xuanxly/fpga-piano-Chuyun/docs/design-status.md

# 文件适用范围与资料状态

[返回项目首页](../README.md)

整理日期：2026-11-03。

|资料|当前内容|适用范围|
|---|---|---|
|PCB工程|项目归档的三份嘉立创EDA专业版原生epro2导出|可编辑设计；Pressure/Control选择PCB2，Lighting选择PCB1|
|原理图和PCB图|项目归档的9张原始截图及对应图文材料|接口和布局阅读|
|亚克力CAD|七片毫米DXF|标称切割轮廓与厚度|
|按键STL|固定定位座、圆形托盘，各28件|打印几何，配合需结合采购硅胶和FSR|
|Blender|整机分层、单键模型|结构说明；层高、PCB厚度及电路外观为示意|
|实物照片|整机、按键、主控、Control、采集板、屏幕及接线|原型装配记录|
|技术文档|R10复核提交版，40页|机械、电路、D13软件、新HOME/VERIFY/EFFECTS实拍与验证数据|
|D13工程|D13完整源码及发布文件，逐文件校验复制|源码、约束、ROM、已发布位流、CH569 HEX、测试与历史记录|
|录音工作室|项目提供的在线链接|外部维护，不随硬件目录打包网页部署文件|

## 配合资料待补

- IO Bank实际供电与D13约束、电气连接的一致性验收记录。
- 四块采集板编号、28个实体键到ADC通道的实装映射。
- 触摸、模拟音频、长时间录放和手机磁盘兼容性等实板专项测试记录。
- 外贴侧板后的整机实测外廓、左右轨距、各层高度和层板有效宽度。
- 灯板实物照片与112灯工程的逐灯地址/布局对应记录。
- Gerber、钻孔文件、贴片生产BOM、坐标文件和原始DRC结果（当前材料未包含，未从截图代造）。

以上空缺集中记录在本页；已经确认的最终结构在正文直接描述。D13源码、约束与发布文件已附入，D12作为历史版本保留。硬件专项验收数据由对应实测记录提供。

## 文件核验

[manifest.csv](../verification/manifest.csv) 列出归档材料、便携来源标签、文件字节数及SHA-256。 [file-checks.json](../verification/file-checks.json) 记录工程包完整性、DXF、STL和Blender资源检查。文件检查不能代替PCB DRC、加工公差验证或整机上板测试。

源资料中的本地工作目录、软件会话数据库和历史备份不作为GitHub入口。原始文件保留在原位置，仓库采用独立副本。

D12目录保留原包内容与第三方许可证；其中历史报告的本机路径仅表示原验证环境，不作为新电脑的依赖路径。附带的历史接线资料以本仓库D13 CST与现版接线说明为准。
