xuanxly/fpga-piano-Chuyun/fpga/d13/docs/hardware/PCB4_20261021/原始工程核对_20261021.md

# PCB4 原始工程核对与已确认灯效

日期：2026-10-21。

## 本轮用户确认

- 原始工程：桌面 `4x7_R2_C120019_布线修复完成_20261020.epro2`。
- 尚未打样。
- 保留当前 PCB，不修改去耦电容或其他板上电路；不再把增加去耦作为继续软件开发的前置条件。
- 灯效：按住时本键四灯保持亮；按下瞬间向周围其他琴键扩散一次并逐渐熄灭；多键可各自产生波纹。
- 5V 电源来源、额定电流及线束仍未确认。
- 本轮完成资料归档和静态网络核对，未修改 PCB、原理图、HDL、CST 或位流，未操作下载器。

## 原始工程归档

- 来源：`C:/Users/KUKI/Desktop/4x7_R2_C120019_布线修复完成_20261020.epro2`
- 本目录保留同名副本，大小 366,899 字节。
- 原件和副本 SHA256：`D5F0B95F5D8CA90B69EB961A93FDA79C734F0D4EC0A00FE1CC61A12144680D92`。
- 工程为 ZIP 容器，包括 project2.json、图片和 `4x7_R2_slots_power_20261020.epru`。
- 内含 1 张原理图页、1 块 PCB，以及符号、器件和封装库。读取时将空值记录按删除记录处理，而非当成有效元件；未修改原始工程包。

## 已核对的 PCB 焊盘网络

以下是原始文件中的焊盘网络定义，不等于原生 EDA 的 ERC/DRC 或实物导通验证。

| 接口 | 引脚 | 工程网络 | 用途 |
| --- | --- | --- | --- |
| U2 四针接口 | 1 | 空网络 | NC，不接 |
| U2 | 2 | GND | FPGA 与灯板的信号参考地 |
| U2 | 3 | $1N5 | FPGA 灯光数据输入至缓冲器 |
| U2 | 4 | 空网络 | NC，不接 |
| P1 电源端 | 1 | +5V | 灯板独立 5V 电源正极 |
| P1 | 2 | GND | 灯板电源负极 |

U2 的第 1、4 针未分配电源网络，不能按常见四针灯带接口的线序猜接。辅助几何检查未发现走线靠近这两个 NC 焊盘，但未进行完整铜皮/焊盘几何 DRC。

信号路径：

`U2-3 → U1-2（1A）→ U1-3（1Y）→ R2 33Ω → D001-3（DI）`

- R3 10kΩ 从 $1N5 接 GND，是缓冲器输入下拉。
- R2 确认为 C120019、33Ω，跨接缓冲器输出 $1N6 与首灯输入 $1N7。
- U1-14 接 +5V、U1-7 接 GND；使用的通道 U1-1（低有效 OE）接 GND。
- 未使用通道的 OE：4、10、13 接 +5V；A：5、9、12 接 GND；Y：6、8、11 空置。没有发现这些控制输入悬空的网络定义。
- 5V 缓冲器输出只进入灯链；U2 数据入口位于缓冲器输入侧。未发现数据入口网络被直接分配到 +5V。
- P1 有装配备注：原端子高度超过外壳限制，计划将端子移到板外并在 P1 焊线。后续装配需要明确线束固定、绝缘和极性标识。

## 112 灯链检查

已通过 7 项静态网络断言，结果另存 `native_net_audit.json`：

1. 112 颗灯全部为 2 脚接 GND、4 脚接 +5V。
2. D001～D112 之间 111 个相邻连接全部满足前灯 1 脚 DO 与后灯 3 脚 DI 同网，且不是电源/地/空网络。
3. D112 的 DO 留空，符合末端无需继续输出的连接方式。
4. U2 数据入口、U1 输入和 R3 下拉连接一致。
5. U1 输出经 R2 进入第一颗灯。
6. P1 电源极性网络一致。
7. U1 电源、所用 OE 及未用通道输入连接一致。

这些检查能确认串接网络的意图；不能证明实际走线、过孔和铺铜没有断路或短路。

## 灯珠封装名称疑点的更新

原 PDF 的封装名带 WS2815C，单凭名称不能判错。原始工程显示：

- 所用器件实际是 C52917434 / WS2812B-2020-V6。
- 符号定义为 1=DO、2=GND、3=DI、4=VDD，与厂家资料相符。
- 封装四个焊盘编号的相对分布可对应厂家顶视图旋转 180° 后的方向，未发现逻辑编号互换。
- 实际库焊盘约 0.8×0.8mm，横向中心距约 1.73mm，纵向约 1.10mm；与本次取得的厂家推荐焊盘图不完全相同。此处只记录尺寸，不能将“编号正确”扩大为贴装工艺验证通过。

依用户决定，本轮保留现有封装与 PCB，不做替换。

## 供电的已知边界

- 文件存在 100mil（2.54mm）+5V 主干和 60mil（1.524mm）行供电线；分支主要约 0.6mm；底层有 GND 铺铜定义。
- 这是文件中的线宽信息，不能据此单独保证整个回路在约 4A 负载下的温升、压降、连接器和焊线载流均合格。
- 现板电源从 P1 进入；FPGA 只需提供数据和参考地。不得让普通 GPIO 或信号杜邦线承担灯板供电电流。
- 5V 电源额定值未确认，不把“有 5V”视为具备所需供电能力。后续程序可以设置总亮度上限和复位时熄灯，但不能把软件限亮当作供电/接线检查的替代品。
- 用户已经决定保留现板电容配置；先前 PDF 初审中的电容建议保留为历史记录，本轮不执行。

## 空间映射

以 PDF 第 4 页的正面方向为准；上到下 4 排、左到右 7 列。按现有电子琴每排 C/D/E/F/G/A/B 的顺序，拟采用下表。最终安装方向尚未通过实物确认。

| 排 | C | D | E | F | G | A | B |
| --- | --- | --- | --- | --- | --- | --- | --- |
| 上排 C3～B3 | D025～028 | D021～024 | D017～020 | D013～016 | D009～012 | D005～008 | D001～004 |
| 第 2 排 C4～B4 | D029～032 | D033～036 | D037～040 | D041～044 | D045～048 | D049～052 | D053～056 |
| 第 3 排 C5～B5 | D081～084 | D077～080 | D073～076 | D069～072 | D065～068 | D061～064 | D057～060 |
| 下排 C6～B6 | D085～088 | D089～092 | D093～096 | D097～100 | D101～104 | D105～108 | D109～112 |

键组中心间距约 31mm，各键四灯中心形成约 23×23mm 的方形。按灯链序号逐个追逐不是二维扩散；后续应按物理坐标计算波纹，再映射到串行发送地址。

拟定实现边界：

- 使用现有压力前端的 28 键状态，检测按下边沿；不从混音或 FFT 反推按键。
- 本键四灯的保持显示与一次性波纹分别计算，避免波纹消失时误熄仍按住的本键。
- 每键分别维护波纹状态，多键同时触发时不互相抢占；重叠像素按确定规则限幅合成。
- 112 灯统一串行发送；协议按实际 V6 的 GRB、脉宽和复位时间实现。
- 仍未选择 FPGA 输出球位；需要结合当前 36 个已用球位和开发板原理图检查可用口，不能拿 U2-3 的数字当成 FPGA 引脚号。
- 当前 RTL 仍未实现以上灯效，本轮没有新增 RTL 或运行相关仿真。

## 依据和验证范围

- 原始工程包为当前接口和灯链连接的依据；PDF 初审仍保留在同目录。
- Worldsemi V6 资料：https://www.world-semi.com/downloads/datasheets/en/ws2812b-2020-v6-1.0.pdf
- TI SN74HCT125：https://www.ti.com/lit/ds/symlink/sn74hct125.pdf
- 本轮为静态文件审查，未运行嘉立创原生 ERC/DRC，未验证制造输出、实物供电、装配或 FPGA 下载后的灯效。
