xuanxly/fpga-piano-Chuyun/fpga/d13/docs/hardware/PCB4_20261021/阅读与待确认事项.md

# PCB4 灯板资料归档与初审

日期：2026-10-21。当前阶段为资料阅读和讨论，未修改 HDL、CST、器件配置或位流，未进行上电、下载、ERC/DRC 或实物验证。

后续更新：已收到并核对同目录原始 `.epro2` 工程，接口、灯链和用户确认规则以 `原始工程核对_20261021.md` 为准。用户确认尚未打样、现有 PCB 不修改，去耦建议不作为继续软件开发的前置条件；本文件保留为 PDF 初审记录。

## 原文件与副本

- 用户提供：`C:/Users/KUKI/Desktop/PCB4.pdf`
- 项目副本：`D:/FPGA/13_learning/pressure_piano_28/docs/hardware/PCB4_20261021/PCB4.pdf`
- 大小：2,277,691 字节；6 页。
- 原件与副本 SHA256 均为：`CE9CCC7E7CCBFC173521DB89D6F004352775C1BB69287AA93D68EDE226FE4917`。
- 保留原始文件内容，未重新导出、裁切或覆盖桌面文件。

## 逐页内容

| 页 | 内容 | 可支持的结论 |
| --- | --- | --- |
| 1 | 正面灯珠位号分布 | 4 排琴键，每排 7 组，每组 4 灯，共 112 灯；相邻组未共用同一颗灯 |
| 2 | 背面元件位号分布 | 28 个分布式电容位置，另有电源入口、缓冲器和接口 |
| 3 | BOM | 具体型号及数量，见下表 |
| 4 | 正面焊盘与走线 | 灯珠串接布局；需要原理图/网表确认完整 DIN→DOUT 顺序 |
| 5 | 背面走线、铺铜及器件 | 可观察供电布线和接口区域；不能据此替代网络与载流核验 |
| 6 | 钻孔分布 | 可用于位置辅助核对；没有孔径表、板材/铜厚或完整尺寸标注 |

该 PDF 不含电气原理图、网络表、ERC/DRC 报告。不能从“已经画出走线”直接认定网络正确、焊盘正确或供电安全。

## BOM 摘要

| 器件 | 数量 | 型号/值 | 备注 |
| --- | --- | --- | --- |
| D001～D112 | 112 | WS2812B-2020-V6，C52917434 | BOM 封装名为 LED-SMD_4P-L2.2-W2.0-P1.00_WS2815C-2020-4P，须核对映射 |
| C1～C28 | 28 | 100nF，CT4-0805B104K500F3，C84772 | BOM 使用直插封装；不能只凭型号中的 0805 判断为贴片料 |
| C29 | 1 | 470µF，OCR471M1CBK-0811G，C134851 | 核对极性、耐压及尺寸 |
| U1 | 1 | SN74HCT125N，PDIP-14，C154102 | 5V 缓冲器，须核对供电、使能和未用输入 |
| U2 | 1 | PZ2.54-1*4-WZ，C5224015 | 四针接口，当前缺少各针网络定义 |
| P1 | 1 | WJ500V-5.08-2P，C8465 | 两针端子，极性与供电用途待原理图确认 |
| R2 | 1 | 33Ω，C120019 | 功能需原理图确认，不直接认定为数据串联电阻 |
| R3 | 1 | 10kΩ，C119347 | 功能需原理图确认，不直接认定为下拉电阻 |

## 当前代码是否已实现

检查 `src/pressure_piano_28_top.v`、`src/piano28_core.v`、`src/instrument_controls.v` 及工程源文件清单：

- 当前已有 28 键 `key_gate` 和每键 12bit `key_pressure`，可作为未来灯效输入。
- `transpose_led[9:0]` 是移调指示，`dark_led` 是明暗模式指示，不是本灯板控制接口。
- 尚无本灯板的数据输出端口、WS2812 发送驱动、112 灯空间映射或按键波纹引擎。
- 现有 HDMI 屏幕琴键格不等于实体琴键灯效。
- 结论：28 键检测可复用，实体“本键四灯点亮并向周围扩散”尚未实现。
- 当前原工程的仿真及实现结果不构成本灯板的验证证据；未来加入后须单独验证并重新综合、布局布线。

## 必须核对或建议修改

1. **灯珠封装与引脚映射。** BOM 料号与封装名称不同，不足以直接判定错误，但必须对照实际库焊盘编号、尺寸及安装方向。厂家资料第 2～3 页定义：1=DO、2=GND、3=DI、4=VDD。必须保证各级 DO 接下一级 DI，不能把编号连续当成已验证串联顺序。

2. **独立供电和压降。** 厂家标注每个颜色通道 12mA；若 112 灯三色满亮，按该数值估算 LED 电流为 `112×3×12mA=4.032A`，功率在 5V 下约 20.16W，尚未计控制电路及供电余量。这是选型估算，不是实测电流或保证最大值。灯板电源应独立规划，不能由 FPGA GPIO 或单根普通杜邦线承担全板电流。还需根据实际铜厚、板尺寸、供电/地线宽度、连接器、线束及注电点核算压降和温升；程序亮度上限只能作为补充措施。

3. **去耦电容分布。** 本次取得的厂家 WS2812B-2020-V6 V1.4 资料第 5 页典型应用电路为每灯 VDD 配 100nF。本板是 112 灯配 28 个 100nF。建议按每颗灯附近一个 100nF 预留/调整，并为 U1 的 VCC/GND 就近配置一个 100nF。若用户已打样或具体批次有另行明确要求，应先核对实际资料与布局，再决定补焊和限亮测试，不直接声称现板必然失效。470µF 入口电容不能替代每处高频去耦。

4. **缓冲器和 FPGA 边界。** TI 的 SN74HCT125 推荐供电 4.5～5.5V，VIH 最低 2V，可用于 FPGA 3.3V 输出到 5V 灯板方向的缓冲。必须确认 14 脚 VCC、7 脚 GND、所用通道低有效 OE，以及所有未用输入/OE 的确定电平。不能把 5V 输出、5V 上拉或外部 5V 电源接回 FPGA 普通 GPIO。PDF 缺少网络名，当前不能给 U2/P1 的逐针接线结论，尤其应核对其电源是否会与开发板电源并接回灌。

5. **空间映射与机械位置。** 从正面位号可见各琴键行的编号方向交替。未来代码需要明确“ADC 板/通道 → 琴键行列 → 四颗灯 → 串行地址”的表，不能简单沿灯珠链依次点亮来冒充二维扩散。需要确认演奏者视角下每排 C～B 的方向及整板安装方向，并核对琴键、FSR、支架和背面元件是否干涉。

## 协议可行性（计算，非实测）

厂家资料给出 24bit GRB、高位先发、约 800kbps、帧间低电平复位大于 280µs。

- 112 灯一帧数据耗时约 `112×24/800000=3.36ms`。
- 加入不少于 300µs 的复位空闲，约 3.66ms；因此从发送带宽看，60Hz 灯效刷新可行。
- 发送逻辑应按实际 V6 数据手册的 0/1 高低脉宽实现，不能只按“800kHz”生成等占空比时钟。
- 这是协议预算，未验证当前 PCB 信号质量、供电、实际可达帧率或灯效观感。

## 讨论完成前需要的信息

- 配套电气原理图或原始嘉立创工程路径；至少包含 U1/U2/P1、第一颗灯和灯链连接。
- 当前是否已打样、焊接，灯板计划的 5V 供电来源和可供电流。
- 建议效果：按住本键四灯保持亮，按下边沿产生一次向邻键扩散并衰减的波纹；多键分别触发并叠加。与“按住持续产生波纹”需由用户选择。

## 外部依据

- Worldsemi 官方 WS2812B-2020-V6 数据手册（本次取得页面标记 V1.4；URL 文件名含 1.0，不能按 URL 推断正文版本）：https://www.world-semi.com/downloads/datasheets/en/ws2812b-2020-v6-1.0.pdf ，重点第 1～5 页。
- TI SNx4HCT125 Rev.G 数据手册：https://www.ti.com/lit/ds/symlink/sn74hct125.pdf ，重点第 3～4、8～9 页。

归档与阅读完成。灯板电气通过、整机接线通过、灯效代码完成、实物效果通过均未确认。
