xuanxly/fpga-piano-Chuyun/fpga/d13/docs/D12_DESIGN.md

# D12 实现与边界

六应用：频谱、触屏键盘、WAV录音、文件管理/WAV播放、五音色、灯光游戏。Home为2排3列，所有页面保留音量和音调柱，文件播放时音调柱禁用。

界面仍保持原两拍RGB/HS/VS/DE延迟：第一拍选择文本及字符序号，第二拍取字符、字模和字模位置。八页共3072000像素与修改前逐字节一致，进度条全范围和28键隔离另外复验，不增加帧缓存。

## 游戏

四排七键对应 C3..B6，与实体压力键、触屏键和PCB4灯序相同。进入GAME显示 `/SONGS` 的英文CSV文件，每页六个，可翻页。选择后校验整份文件，再以最多32个待处理事件流式装入分布式队列。计时、按键边沿、和弦、长音、分数、灯光和屏幕提示由HDL完成。

练习模式在目标时刻等待正确键；挑战模式按固定时间前进。倒计时期间灯光不提示琴键，结束后最多提前150ms提示，与可按窗口对齐，灯亮即可按。挑战允许前后150ms，50ms内命中100分，其他命中70分。和弦必须在窗口内逐个触发并最终同时按住。超过300ms的音符按实际命中时刻计算持续时间，允许结尾60ms释放余量；下一次同键进入可按窗口时允许换音。蓝色提示按键，绿色表示正确/继续保持，红色表示错误。错误键仍会实时发声。队列暂空时冻结游戏计时，退出GAME停止游戏与引导。谱面最长5分钟，末尾为迟按尾音与EOF保留500ms内部收尾余量。

音频主链不读取谱面来自动发音。谱面只引导玩家，实际按键仍进入既有28声部合成器。

游戏状态按合法谱面范围缩窄：绝对时间和长音截止19位、分数20位，每条队列事件64位。最大迟按尾音截止不超过360500ms，小于19位上限524287ms。队首装载时预计算可按、提示及完美命中窗口；命中时分别保存长音结束和提前释放截止时刻。时间及长音的63项比较与实际下一状态一起预测寄存，判定仍在原来的毫秒边沿发生，不增加判定延迟；清空、队首装载和命中同拍的优先级也保持。214405个时钟周期与旧判定器逐拍对照，并检查全部63项寄存结果等于当前状态的直接比较。模块综合占用见 `reports/d12_game_area_reduction.json`，整机占用以最终PnR报告为准；不把单模块统计当作整片FPGA资源。游戏22个场景包含60/61ms释放边界，五分钟边界、画面/灯光和实际CPU暂停继续均纳入修改后复验。

## 谱面格式

```csv
PIANO28,1
0,1000,C3+E3+G3
1500,300,D4
```

三列依次是绝对时间ms、持续时间ms、以加号连接的键名。仅接受C/D/E/F/G/A/B、八度3..6，无升降号。相同时刻的和弦写在同一行。时间严格递增，同一键的音符不得重叠。40..60000ms音长，总时长不超过5分钟、4096事件、262144字节。`#` 开头是注释。示例均为本项目编写的短练习。

## 分音色按钮

钢琴、电钢琴、风琴：短按切换明暗。吉他：短按开关轻揉弦。弦乐：短按开关揉弦。五种音色各自记忆状态。短按在释放时确认；长按约2秒只执行既有触屏USB启动，不额外触发短按。

5Hz三角LFO只调节吉他/弦乐DDS步长。吉他50ms后渐入，峰值约±1.7音分；弦乐200ms后渐入，峰值约±13.6音分。每声部独立起音年龄，28声部仍896时钟/采样。

铃音相关的弯音步长、3.5倍步长和相位分别放在现有32拍调度的第2、3、4拍计算，保持逐声部上下文及整帧时长。修改后重新完成五音色逐样本对照、录音链、28键/四路ADC整机与揉弦验证。

## 文件、录音和磁盘调度

录音保存内部合成PCM为48kHz/16位单声道WAV，保留五分钟限制和暂停。WAV播放支持16位单/双声道、8..48kHz；文件播放屏蔽琴音，退出播放器停止播放。D12去掉MP3解码器以节省块存储，MP3仍可在磁盘模式复制/删除。

录音、游戏、手机磁盘互斥。进入游戏前结束并保存录音；进入USB磁盘前结束录音、停止播放器/游戏、同步并卸载FatFs。导出后仅处理手机的原始扇区请求，拒绝录音和打开文件。EJECT先让CH569断开USB设备，再同步TF卡并交还FPGA重新挂载。拷贝期间不应强制拔电或按EJECT。手机拔线后还须通过EJECT交还卡，不能仅根据USB暂停判断卡可收回。

## CH569

CH569-USB3 Type-C运行USB2 MSC/Bulk-Only设备，使用CH569原生USB外设。FPGA与CH569通过板上既有HSPI连接作带背压的四位GPIO握手。MCU PA/PB脚位与NEO31005原理图第21页核对，FPGA球位与官方60K HSPI CST核对。使用HD13作为MCU请求，HD5/6/7/12作为FPGA发送数据，避开专用I2C/SSPI引脚，保留D11启动设置。

MCU先发带CRC16的 `PIANO12!` 身份包，FPGA文件服务核验后才能驱动数据脚。FPGA数据OEN使用INIT=1寄存器，MCU READY下降时异步高阻。未更换CH569固件时磁盘功能显示 `USB LINK WAIT`，不自动进入磁盘。

屏幕的独立USB触控主机保持原枚举及轮询时序。其宽描述符比较先寄存，计数器按原门限缩窄；描述符在脱离设备和进入下一控制步骤前清零，避免等待窗口直接驱动328位清零使能。真实USB针脚模型的枚举、错误设备拒绝、五指演奏及USB时钟故障恢复均重新验证。

等待结束、帧启动窗口和拔出门限使用同步预测状态，逐拍对照原组合定义；控制步骤提前解码。事务复位许可单独寄存，首次SETUP等待许可就绪，避免异步CLEAR的状态解码长路径；USB位时序、重试等待和SOF窗口保持。

USB描述符、SCSI、传输错误恢复和128GB块地址经过软件测试；这不代表已通过USB电气或iPhone实测。速度由GPIO握手、软核SD SPI和TF卡决定，不声称USB3吞吐量。

只改CH569应用固件，不改BL616下载器。恢复镜像来自官方Sipeed固定提交，`docs/ch569_recovery/PROVENANCE.json`有来源和哈希；它是官方恢复镜像，不是本机板子的读回备份。刷写前仍须确认恢复方式并尽可能保留板上固件读回。

## 验证边界

数字仿真、C主机测试、综合/PnR与真实板级验收分别记录。新位流只在最终所有检查通过后交付，不使用中途失败产物。原D11保持可恢复。没有自动下载FPGA、CH569或写任何硬件Flash。

## UI和USB时序拆分

UI按“坐标预译码→五指归属→提交”三拍处理，一个50MHz时钟周期为20ns。额外一拍只用于分割组合路径，不改触摸坐标、音量刻度、移调范围和点击优先级。新旧UI通过16001帧随机逐帧对照，覆盖八页面、五指ID、滑动/松手、命令顺序、CPU导航和断线。流水数据不要求复位，只有有效标志清零；未有效的数据不会提交。

USB枚举的附着/总线复位/恢复计数独立于控制传输成功或失败分支；离开枚举阶段计时器保持零。各阶段原有门限不变，避免事务结果经错误分支组合路径返回宽计数器。

处理器数据总线先锁存请求、MMIO及常用FIFO地址译码，再完成仲裁；游戏命令在CPU消费ACK的同一拍提交。1220笔事务检查覆盖ROM、带字节掩码RAM、只提交一次的MMIO、连续游戏写后读、录放冲突及五分钟录音边界。五分钟容量标志和音频FIFO空满标志与计数同拍预测更新，音频采样不等待软件。

基准画面的音量柱高度改为完整128项整数查表，与原计算的194560个边缘/刻度像素一致，RGB延迟仍为两拍。五种音色关闭揉弦时保持与D11的逐样本对照结果，28声部仍为896时钟/帧。
