xuanxly/fpga-piano-Chuyun/fpga/d13/reports/package_checks/整理验证.md

# D13 整理与迁移验证

本目录是精简开发工程，版本 **0x0000C02F**。原工程`D:/FPGA/11_projects/pressure_piano_validation_d13`保留，14484项原文件在整理前后逐项SHA256一致。完整版逐字节保留全部原文件；精简版保留当前开发所需文件。

- 当前Gowin工程58项引用全部在包内，GPRJ、过程配置、device.cfg及正式FS与原D13相同。
- 原D13报告中记录的121项源码/约束/ROM/固件哈希一致，34项历史通过日志及其哈希全部保留。它们是原发布时的结果，不称为本次重跑34项。
- 在精简版新位置由真实Gowin CLI打开工程成功；没有重新综合或PnR，没有操作下载器。
- 从精简版路径重新编译全部仿真源码，运行`tb_effects28`、`tb_d13_rom_equivalence`、`tb_d12_game_timing`三项均PASS。效果器91300行新输出与原验证数据逐字节相同；ROM14336次等价、游戏214405周期等价通过。
- 从精简版重编译当前C固件，ROM和20个银行逐字节一致；重编译CH569 HEX与既有发布HEX一致。
- 两个新目录的`README_请先看.md`本地链接全部存在，工程不通过链接/junction引用原目录。外部软件工具需要另行安装，路径见工具参数/`compiler_path.json`。
- 每个目录附相对路径的`PACKAGE_MANIFEST.json`和`SHA256SUMS.txt`，使用`python tools/verify_package_d13.py`独立核对，不依赖原D13目录。清单自身不纳入自身哈希。

FPGA SHA256 `065BDDD3654E0265ABBB3CC54C5DD1021EBD49B6E1336ED688BE5E37649A1E46`；CH569 HEX SHA256 `32A1A44B66B82F75DF07F9CBE4BD8E78CFBD2A951D2C342DD48AD58F77CDE68E`。

本次未重跑完整物理实现或真实卡/触屏/音频实板验收，没有下载FPGA、MCU或Flash。原D13数字验证边界与PR1014记录保持。
