xuanxly/fpga-piano-Chuyun/docs/references.md

# 官方参考与项目链接

[返回项目首页](../README.md)

- [触韵录音工作室](https://proud-leaf-166f.2272419355.workers.dev/)：由项目提供，网站代码与部署由对应成员维护。
- [Sipeed Tang Mega 60K Dock 官方资料](https://wiki.sipeed.com/hardware/en/tang/tang-mega-60k/mega-60k.html)：主控平台参考。
- [Microchip MCP3004/3008 数据手册 DS21295D](https://www.microchip.com/content/dam/mchp/documents/APID/ProductDocuments/DataSheets/21295d.pdf)：ADC引脚和器件参数参考。
- [Waveshare 5inch HDMI LCD(H) 官方说明](https://www.waveshare.com/wiki/5inch_HDMI_LCD_(H))：屏幕接口与产品说明。

本仓库仅链接厂家资料，主控板和屏幕本身的原始设计权利归相应厂家。具体自制板端连接以原生工程导出为准。
