xuanxly/fpga-piano-Chuyun/fpga/levels/使用说明.md

# 三首右手主旋律关卡

把SONGS文件夹中的三个CSV复制到TF卡的 `/SONGS/` 目录，退出电脑USB磁盘模式并由FPGA重新挂载，在GAME中刷新/选择。无需覆盖七里香关卡，也无需重新烧录。

|文件|曲目|速度与范围|
|---|---|---|
|STAR.CSV|小星星|80 BPM，C4～A4；图中未标时值，按常见四分/二分音符节奏编排|
|ODEJOY.CSV|欢乐颂|保留60 BPM；从E调移到C调，低音sol使用G3|
|SUMMER1.CSV|菊次郎的夏天 第1页主题片段|保留90 BPM；从D调移到C调，右手单音主旋律|

三首均采用 `PIANO28,1`，UTF-8无BOM，第一列为倒计时结束后的绝对毫秒；第一音从1500ms开始。开始前把音调/移调设为0。休止以时间空隙表示，时值小于一拍留90ms松手间隙，一拍及以上留120ms。持续时间超过300ms的音按游戏规则长按。

《小星星》和《欢乐颂》按所给图片的旋律范围转换。《菊次郎的夏天》只收到第1页（原谱共3页），本版选取第4小节的弱起、第5～9及第13～15小节；省略左手、开头等待、反复及第一结尾路线，延音合并，右手和音取最高旋律音，第14小节的三连装饰音简化为主音D5。因此它是该页主题片段，不是整首完整版。

建议先用练习模式熟悉键位，再用挑战模式。《菊次郎的夏天》保留若干十六分音符，最快相邻音约167ms。CSV本身只引导灯光和判定，声音仍由玩家按键产生。

chart_sources中的JSON是按拍数整理的编辑源稿；实际游玩读取SONGS里的CSV。
