xuanxly/fpga-piano-Chuyun/fpga/d13/docs/D13_CONTEST_RECHECK.md

# D13 对赛题二的增量复核

本文件更新 D12 风险清单中与本次开发直接有关的结论。旧文件 `CONTEST_FAQ_RISK_REVIEW_20261102.md` 保留为历史证据，不代表 D13 当前功能。最终资源、时序及位流身份以 `reports/d13_verification.json` 为准；尚未生成该文件时，不代表实现验收通过。

最终数字审计已通过：34项测试，User Code **0x0000C02F**；Logic40581/59904、BSRAM103/118、DSP86/118，Setup/Hold零违例，最小余量+2.529/+0.140ns。原58球位与启动配置保持，新增J13三路标准I2S。仍需D13实板验证触控改善、效果听感及模拟延迟，不能由上述数字直接宣称所有评分项已实测达标。

依据仍为本地 `FPGA2026_pre2(1).pptx` 第9～14页，以及2026-11-02已读取的[技术答疑](https://docs.qq.com/sheet/DUXVvYWhsUmRhaVFI?tab=orss47)、[赛事答疑](https://docs.qq.com/sheet/DUXVvYWhsUmRhaVFI?tab=BB08J2)和[高云赛题原文](https://www.gowinsemi.com.cn/university/match2026)。答疑含整理建议、往届内容和未答问题，不能把所有单元格都解释为本届正式豁免。

## 本次补上的内容

|原问题|D13实现|仍需如何展示|
|---|---|---|
|缺少可从实机进入的验收模式|第七应用VERIFY，主动START后实时生成1/4/8/16/28/32个不同频率，离开停止；32份独立相位和包络，纯HDL计算|用高分辨率FFT观察375Hz步进的不同谱峰；32声部测试能力与28键演奏能力分别说明|
|板载PT8211不是标准I2S|保留PT8211右对齐接口，另加真正1bit延迟的I2S；J13-1/2/3分别BCLK/WS/DATA|逻辑分析仪核对48kHz、16bit有效数据和左右32bit时隙；三路为3.3V数字信号|
|混响/回声/合唱缺口|第八应用EFFECTS，三种HDL效果可独立开关及调节并叠加；退出保持|分别试听/测量尾音与调制；录音为带效果、主音量之前，文件播放不加效果|
|只用固定文字宣称性能|VERIFY提供采样计数、合成周期、PCM峰值、门控至数字DAC事件延迟与错误标志|区分标称时钟计数、静态设计参数及真实模拟测量，不把界面文字当外部仪器结果|
|触控间歇不灵敏|定向复现并修复USB空DATA序号、同时间戳有效变更及半帧超时误释放|数字测试通过仍须上板对照，详细证据见`TOUCH_SELF_CHECK_D13.md`|
|频谱参考来源说明未带齐|已补入`SPECTRUM.md`和`third_party/hack_spectrum`来源资料|按真实引用范围致谢；VexRiscv/FatFs/CH569等第三方来源及许可继续保留|

## 规模必须按实际信号路径解释

正常乐器提供28个独立演奏声部。钢琴、风琴、弦乐每声部显式相加6个分量，全部28声部启用时为168个计算分量，理论分量吞吐量8.064M次/秒。它们共享各自声部的基频和包络，不能写成168个独立琴键或168份独立声部状态；实际可闻分量还取决于音色、力度、衰减和频谱重叠。

VERIFY另有32份独立相位/包络和32个不同频率，标称48kHz时为1.536M声部采样/秒。其工作时屏蔽乐器门控，不能把两个互斥引擎的数量相加。32个谱峰已在RTL输出中由独立DFT核对；正式演示还应展示同一最终位流的真实输出。

吉他重复倍频合并计数；电钢琴FM调制器/载波与加法分量分别说明，不能把FM边带数当算子数。详见`D13_SCOPE.md`。

## 本次没有消除的边界

1. **整机延迟**：GATE-DAC只从已判定门控开始，到装载非零数字PCM为止。FSR形变、ADC触发滤波、起音包络和模拟DAC仍需完整口径的外部测量。D12记录的极弱压力静态12～13ms反例未在本次改变，不能承诺任意力度最坏情况均≤10ms或≤5ms。
2. **软件辅助职责**：演奏合成、效果、测试音、FFT和像素为HDL；FPGA软核处理文件系统、WAV封装/辅助播放及谱面装载，CH569处理USB磁盘。新增两个应用无需MCU算法，但整机不能称为完全没有处理器。媒体辅助功能按用户向赛事方确认的工作量边界单独介绍。
3. **真实外设验收**：仿真卡、协议模型和ROM重编译不能替代真实TF卡、手机、耳机、灯板及长期触摸测试。保留D12回退位流。未自动下载FPGA或升级CH569。
4. **扩展资源**：加入效果RAM后必须依据D13最终PnR统计，不能沿用D12的92块BSRAM。新增功能仍受片内RAM、布线及实际时序限制，不承诺继续无限添加。
5. **材料与现场**：最终报告、视频和桌面需自行核对匿名要求；现场测验应由队员独立解释/修改/仿真，保留已提交版本及哈希。第三方歌曲的公开使用范围另外确认。

本次开发补齐了指定的功能入口和数字验证证据，不作“所有基础及扩展要求已经实板达标”的结论。
