xuanxly/fpga-piano-Chuyun/fpga/d13/docs/D13_IMPLEMENTATION_NOTES.md

# D13 物理实现记录

## 最终通过结果（2026-11-02）

第五轮物理实现和完整审计已通过，User Code **0x0000C02F**，FS SHA256 `065BDDD3654E0265ABBB3CC54C5DD1021EBD49B6E1336ED688BE5E37649A1E46`。建立/保持零违例，最小Setup +2.529ns、Hold +0.140ns、Recovery +0.674ns、Removal +0.743ns，0.300ns额外建立预算保持。Logic40581/59904、Register16953/60780、BSRAM103/118、DSP86/118、PLLA2/8。

322个实际封装行与D12比较仅三处新I2S变化；原58球位、整份device.cfg及USB/CH569直接INIT1高阻使能均通过审计。表头不作为物理引脚，最终解析器显式排除表头。34项数字检查与当前源码匹配，最终文件身份见`reports/d13_verification.json`。下方失败/中止过程保留历史，只有本段及最终报告代表可交付版本。

仍保留PR1014通用时钟布线告警；在该实际布线结果下STA已通过，但这不代替板上长期稳定性、电气和模拟测量。本次未下载FPGA/CH569或写Flash，D13实板触控/音效试听仍待用户验收。

功能检查和物理布线是两道独立验收。存储优化和游戏关键路径修改后，34项当前源码匹配的RTL、独立音频模型及固件ROM复编译已通过。是否能够发布以最终`d13_verification.json`为准。

1. 初版Place3/Route0实际映射Logic46519、BSRAM112/118，最终PR0004，7298条未布通。失败源码和实现记录保存在`reports/pnr_attempts/route0_pr0004_7298/`。没有交付这一轮的位流。
2. 效果存储改为15个1024×16银行共享端口，所有原有延迟长度和16bit算法保持，处理26周期/样本；91300个输出重新与原独立模型逐值相等。原8KB LUT ROM改同步BSRAM，14336次全地址/随机/停顿读取证明数据和一周期延迟等价。综合Logic39927、BSRAM103（仅综合）；这轮Place3/Route2在45分钟仍停留布线阶段时保存并中止，没有判为STA通过。记录`reports/pnr_attempts/route2_split_enabled_stopped45/`。
3. 第三轮保留上述逻辑，关闭继承的`Convert_SDP32_36_to_SDP16_18`，使用原生宽度RAM做PnR。按[高云SUG1220 Tcl命令说明第36页](https://cdn.gowinsemi.com.cn/SUG1220.pdf)，此选项将32/36位SDP拆为两块16/18位SDP，0表示关闭，适用于Arora V。第一轮综合/映射的SDP计数存在8块差额；关闭后的实际资源和时序仍必须由这一轮报告确认，不能只按预计节省数量宣称成功。
4. 第三轮实际全部布通，BSRAM103/118，DSP86/118，但5处Setup违例（最差-1.724ns），Hold零违例；没有发布该FS。路径均为游戏队首的RAM选择、边界加减及比较串联。第四轮增加队首时间边界缓存并将当前/下一事件的比较分开，保留同拍命中/窗口更新；对照旧判定器214405周期完全一致，且逐拍检查缓存与队列。33项新回归和第四轮完整综合/PnR分别验收，不放宽时钟或时序预算。
5. 第四轮Setup零违例、最小+2.260ns，Hold有13处，均为触控邮箱目的寄存器的PnR副本。逐项验证13个触控及14个媒体快照副本与原目的寄存器D/CLK/握手CE一致后，将原邮箱max_delay16.667/30ns及异步Hold例外补到两组副本家族；不切正常内部时序或同步器二级。补约束后第五轮重跑PnR，原33项加独立异步邮箱测试为34项通过。最终审计同时核对这些复制端点的实际物理连接和明确的最大延迟约束，不能只以报告违例数消失作为证据。

第三轮复用的是逐项核对源文件哈希后保留的综合网表，物理映射选项不改变逻辑PCM精度、ROM内容、引脚或时钟；保存的过程JSON和实际`cmd.do`需一致。完整Setup/Hold/Recovery/Removal、0.300ns额外预算、全部322封装行、原58球位和USB/CH569直接INIT1高阻保护仍是发布门槛。

没有更改开发板供电、配置引脚、外部电平，也没有编程FPGA、MCU或Flash。失败/中止尝试的报告属于开发记录，不能替代最终可用位流的验收。
