xuanxly/fpga-piano-Chuyun/fpga/d13/docs/D13_SCOPE.md

# D13：现场验证、效果器、标准I2S及触控修复

User Code **0x0000C02F**；34项RTL自检、独立音频参考、两种128GB卡模型的真实C服务、ROM重编译和实际Gowin完整综合/PnR审计通过。最小余量{'Setup': 2.529, 'Hold': 0.14, 'Recovery': 0.674, 'Removal': 0.743} ns，资源{'Logic': '40581/59904', 'Register': '16953/60780', 'I/O Port': '61/297', 'BSRAM': '103/118', 'DSP': '86/118', 'PLLA': '2/8'}。保留额外0.300ns建立预算。 D12/925A保留；D13实板验收尚未完成，没有自动下载硬件。

## 用户确认的范围

Home两排四列，保留原六应用，新增VERIFY、EFFECTS。混响、回声、合唱独立开关/强度，允许同时使用；退出效果页仍生效，录音保存带效果琴声。文件播放器维持原路径。新增音频算法、参数控制、测试音与页面渲染均为HDL，既有CPU仅继续文件服务。

## 标准I2S接线

| 信号 | 开发板排针 | 60K球位 | 电平 |
|---|---|---|---|
| BCLK | J13-1 | E14 | 3.3V输出 |
| LRCLK/WS | J13-2 | E13 | 3.3V输出 |
| DATA | J13-3 | C15 | 3.3V输出 |
| GND | J13-12 | 地 | 共地 |

J13是靠PCIe侧的SDRAM0扩展排针，不是已接控制板的J14。J13不能同时插SDRAM扩展板；11脚是5V，不接音频信号。以NEO31005原理图第19页的方框/1脚标记确认方向，避免只凭照片左右。

48kHz、16位有效PCM、左右32位时隙，BCLK平均3.072MHz，WS为48kHz，WS改变后隔一位发送MSB。使用50MHz时钟分数分频，平均速率准确，单边沿有20ns量化；不因此宣称理想无抖动音频时钟。与原PT8211平均帧边界同步，原3.5mm输出保留。引出的是数字接口，不能直接接无源扬声器。

依据：NEO31005第7页BTB和第19页排针映射，官方60K CST中sdram_dq[0]/[1]/[2]的E14/E13/C15及LVCMOS33声明。最终PnR审计确认新增球位与D12原58球位无重合，全部322封装行只变化这三处。

## VERIFY数据口径

- 可选1/4/8/16/28/32测试声部，每个有独立相位、步长与包络状态；频率375×(1..32)Hz。只在本页主动START后出声，离开即停止。
- 该测试引擎是独立的纯HDL实时演示模式，不冒充乐器实际可弹的28复音，也不把其32声部与乐器28声部相加。
- FS MEAS：以50MHz标称系统时钟计数一秒内实际采样tick，不是外部频率计对晶振的校准。
- LAST/MAX CYC：实际合成busy到done周期；GATE-DAC：从全松手后检测到门控上升，到DAC帧装载非零PCM的数字延迟。都不包含真实FSR形变、ADC前端或DAC模拟延迟。
- LAST/MAX CYC接的是正常28声部乐器流水线；启动32声部测试时，该乐器流水线仍计算静音帧，计数不改成测试引擎的256周期。演示时分别解释两条并行流水线，不能把896周期标成32测试声部耗时。GATE-DAC测量前应关闭效果并等待原尾音消失，否则“下一非零PCM”可能来自原有尾音。
- ANALOG LAT明确要求外部测量，界面不伪造≤5/10ms通过结果。
- USB ERR/SKIP：主机轮询错误及已ACK但非11字节的DATA计数，用于观察触控异常时的状态。
- 28声部、5音色、3种效果以及资源/静态时序属于设计/构建参数；它们应与实际报告共同展示，不能把固定UI文字当作现场测量。

## 效果器

48kHz mono硬件效果链保留直接琴声，混入独立湿声，26个系统周期/采样。回声为128ms反馈延时；混响为四条互质附近延时梳状滤波器及全通扩散；合唱为0.8Hz LFO驱动的分数延时插值。系数变化按每采样一档平滑，反馈向零衰减防止负一LSB自保持。全关时采样等值；15个1024×16银行共用一个读写端口，15360周期初始化期间直通。最后输出限幅，极高叠加量可能有意触发限幅，验证页记录峰值/限幅标志。

效果产生的延时尾音不同于按键响应延迟；直接琴声没有等到128ms才发出。文件播放不加效果。录音抽取效果输出且不受监听主音量影响。

## 调度与资源口径

50MHz系统时钟下，每个48kHz采样帧约1041/1042周期。现有28声部流水线忙896周期，效果器再占26周期，滤波/音量还有少量寄存周期；完整音频链自检逐帧比较录音与串行输出并检查期限错误，不依靠CPU逐样本运算。VERIFY的32路测试引擎占256周期，与正常乐器引擎并行计算，输出只选一条；这不是把两个耗时顺序相加。FFT、USB的60MHz域、30MHz像素域和灯光发送均继续使用各自状态机，不用软件轮流绘屏/生成音效。

这些周期数字描述算法调度，不能代替组合逻辑在50MHz内能否收敛的物理STA；最终资源/时序看本次PnR审计。效果延迟线使用片内RAM，初始化期间直通；未新增外部SDRAM或MCU，也未占用TF卡作实时效果延迟。原有软核/CH569仍承担媒体辅助服务。

## 触控修复证据边界

用户反馈运行D12/925A时有时整段触控不灵敏，有时正常。旧代码已通过新定向测试复现：合法已ACK空DATA未更新toggle；相同ScanTime但不同坐标/松手会被忽略。原报告层还会因不完整下一帧超时清空上一完整触点。

修复分别维护USB包序号与HID帧语义：合法DATA推进toggle，只有11字节才发布；内容变化的同ScanTime可更新；缺续包只丢半帧；已知ID明确Tip0或拔出仍释放。保持CRC、重复DATA和停钟高阻保护。定向测试和7302条历史真实报告回放已通过，但不能据此确认已覆盖实板全部原因，需要上板观察新增错误计数。

## 五种音色的规模说明

乐器是28份独立声部状态。钢琴、风琴、弦乐每声部显式计算1/2/3/4/5/7倍频正弦并相加，设计上为6个分量；28份全开时168个运算分量，标称吞吐量168×48000=8.064M分量采样/秒。它们共享本声部基频相位及包络，不能写成168个独立演奏声部。

吉他基础1/2/3分量与亮度分支2/3/4/5/7相加，其中2/3倍频重复，应合并理解为6个频率分量，而非8个独立频率。起音亮度衰减后部分分量可能已不可闻，不能一直算满168。

电钢琴包含直接基频、二倍频正弦FM调制器及载波、独立3.5倍铃音与很弱的5倍附加分量。调制器/载波按FM算子口径、旁路加法分量按实际非零贡献分开统计，不能把边带峰数当算子数，也不能把中间计算但未混入输出的h3/h4计入。正式评分数量仍需按答疑和频谱/RTL说明共同核定。

此外28个自然音阶键的泛音存在重叠，32频段柱图不能当作168个独立谱峰证明。VERIFY使用375Hz间隔的32个不同频率，2048点FFT中对齐16..512bin；内部/外部高分辨率频谱核对更明确。音频均由实时DDS计算，无整段录音触发。
