xuanxly/fpga-piano-Chuyun/fpga/d13/docs/D13_上板步骤.md

# D13 上板与使用

保留原D12/925A位流。用SRAM Program下载本包D13 FS，核对User Code **0x0000C02F**。原PCB2/3/4、耳机和HDMI接线不变；TOUCH接J18，USBA-Switch朝FPGA，长按PCB3按钮约2秒启用触控。

Home两排四列，VERIFY为第七个、EFFECTS为第八个应用。SPECTRUM/KEYBOARD/RECORDER/FILES分别是频谱/键盘/录音/文件，TIMBRE/GAME是音色/游戏。实际版本以Home D13及烧录日志User Code核对。

效果页REVERB为混响、ECHO为回声、CHORUS为合唱。左侧按钮独立开关，右侧滑条分别调强度，三种可叠加，退出保持；录音保存带效果琴声，监听音量不改变录音，文件播放器不加效果。

VERIFY默认不发测试音。选择1/4/8/16/28/32后START，纯HDL实时生成375Hz步进至12kHz的测试声部；离开页面停止。STOP后可用实体键演示真实演奏。测试32声部与正常乐器28复音分开说明。

FS MEAS、LAST/MAX CYC、GATE-DAC、PCM PEAK来自硬件计数。LAST/MAX CYC观察正常28声部乐器引擎；32声部测试有另一条256周期流水线，不混用两者耗时。GATE-DAC只表示已判定门控到数字DAC装载非零PCM，测量前关闭效果并等待原尾音消失；整机模拟延迟仍需外部测量。触摸修复经过数字回归，实板是否完整改善仍须确认；异常时记录VERIFY内USB ERR/SKIP与顶部诊断行。

## 新标准I2S

|信号|位置|球位|
|---|---|---|
|BCLK|J13-1|E14|
|LRCLK/WS|J13-2|E13|
|DATA|J13-3|C15|
|GND|J13-12|GND|

三路均为3.3V数字输出；J13靠PCIe侧，不能与SDRAM0扩展板并用。11脚是5V，不接信号。16bit有效PCM、32bit左右时隙、48kHz，标准1bit延迟。原3.5mm继续工作。

## 验证边界

34项RTL自检、独立音频模型、模拟128GB FAT32/exFAT真实C服务、ROM复编译及实际Gowin综合/PnR审计通过。
最小余量：{'Setup': 2.529, 'Hold': 0.14, 'Recovery': 0.674, 'Removal': 0.743} ns，保留0.300ns额外建立预算。资源：{'Logic': '40581/59904', 'Register': '16953/60780', 'I/O Port': '61/297', 'BSRAM': '103/118', 'DSP': '86/118', 'PLLA': '2/8'}。

以上不是D13实板验收，没有自动刷写FPGA、CH569或Flash。已有USB磁盘仍需D12配套CH569固件。FS SHA256 `065BDDD3654E0265ABBB3CC54C5DD1021EBD49B6E1336ED688BE5E37649A1E46`。

本轮仍保留PR1014通用时钟布线告警；实际STA已通过，长期实板稳定性仍待确认。完整失败/修复过程和数字验证见工程内`docs/D13_IMPLEMENTATION_NOTES.md`、`docs/D13_VALIDATION_INDEX.md`；触控问题若仍出现，记录VERIFY的USB ERR/SKIP和顶部诊断行再定位。
