xuanxly/fpga-piano-Chuyun/fpga/d12/docs/CONTEST_TOPIC2_D12.md

# 选题2复核（D12）

依据：本地 `D:\Gowin\FPGA2026_pre2(1).pptx` 第9..14页（哈希与提取见 `reports/d12_contest_slides.json`），以及[高云2026赛事页](https://www.gowinsemi.com.cn/university/match2026)。

2026-11-02 根据当前实现及已完成的数字检查再次逐项复核，原PPT哈希未变，记录见 `reports/d12_contest_recheck.json`。最终检查数量以 `reports/d12_verification.json` 为准。下列待确认项仍保留，不因仿真通过而改写为实测达标。

用户已向赛事方确认：辅助媒体播放功能不计工作量，不会因此违规。此处按该补充解释组织功能，不把辅助播放算作实时合成成果。

2026-11-02新增：[按公开答疑逐项核对的风险清单](CONTEST_FAQ_RISK_REVIEW_20261102.md)。本次新增资料改变了PT8211与32路规模的判断口径；旧JSON中的“未达/未确认”是当时的复核记录，不是新的赛事定论。另发现默认压力滤波下弱按压触发约12～13ms的静态反例，尚未修复或实测。

| 题目要求 | D12实现及证据边界 |
|---|---|
| FPGA HDL逐样本、逐声部实时合成，核心避免软核 | DDS、加法谐波、电钢琴FM、ADSR、持续力度、滤波、揉弦、混音、限幅、主音量和PT8211发送均为RTL。软核只负责文件系统、WAV辅助录放、谱面装载、USB扇区服务；CH569只处理USB磁盘传输。 |
| 至少2个独立可控演奏维度 | 压力键选音和持续力度独立；还有全局移调、明暗/揉弦、音色选择。传感器实际灵敏度、误触率仍须逐键实测。 |
| 基础复音≥4 | 28份独立声部上下文，896时钟/48kHz音频帧，约17.92µs。多音同时发声、上下文隔离及关闭揉弦时五音色对照有仿真。 |
| 控制到音频总延迟≤10ms | 数字调度有上界，但896时钟只是合成时间，不能当作传感器到声卡模拟输出总延迟。ADC扫描、压力滤波、触屏轮询、音色自身起音和DAC均须计入，整机≤10ms尚待示波器/音频实测。弦乐慢起音是音色设计，演示延迟应同时给出明确测量定义。 |
| I2S输出DAC | PPT第9页设计要求第2条，不是I2C。PT8211仍为LSBJ右对齐，不能称为标准I2S；新增答疑技术100/赛事72倾向允许板载PT8211，并建议另留GPIO标准I2S。因此不再列为确定违规，保留协议表述和额外I2S的保底建议。 |
| 扩展规模 | 当前28复音、每声部多个显式合成分量。新增答疑技术108/109、赛事75/77允许分量统计及同采样周期时分复用，不能仅凭28键断定32路扩展未达。实际可闻分量、共享相位/包络和FM统计仍须列表与频谱佐证；当前不宣称已验证某个大于32的独立振荡器数。 |
| 扩展≥2种乐器音色 | 五种音色，吉他/电钢琴D11听感已有用户确认；D12保持关闭揉弦时五音色与D11逐样本一致。实板D12试听待验收。 |
| 表情/效果 | 压力动态、移调、明暗及吉他/弦乐5Hz揉弦。未实现混响、延迟或合唱，不把揉弦当作这些效果。 |
| FPGA硬件可视化/LED演奏指引 | FFT、画面像素、WS2812发送、游戏计时/判定/提示掩码均为RTL。CSV由CPU校验/装载，不自动触发预录音或自动代奏。 |
| 脱机曲目引导、手机谱面/录音回传 | GAME从TF卡加载CSV后脱机引导；CH569 USB MSC提供手机修改谱面与传输WAV录音。USB识别、TF卡兼容及实物灯序仍须上板验收。 |

实时演奏主链与辅助WAV播放必须在说明和演示中分开。游戏错误键仍由同一HDL引擎即时发声；谱面没有预置整段音频。新增MCU/CPU服务不冒充FPGA实时合成工作量。

该复核说明实现范围和未确认指标，不替代赛事方对正式材料的判断。不要在答辩中把尚未实测的总延迟、标准I2S、已验证的32路规模或手机USB兼容性写为已通过。
