xuanxly/fpga-piano-Chuyun/fpga/d12/reports/package_checks/gowin_synthesis_report.html

- Synthesis Messages
- Synthesis Details
- Resource
  - Resource Usage Summary
  - Resource Utilization Summary
- Timing
  - Clock Summary
  - Max Frequency Summary
  - Detail Timing Paths Informations

# Synthesis Messages

Report Title | GowinSynthesis Report

Design File

D:\Gowin\outputs\pressure_piano_D12_clean_20261102\src\ch569_gpio_link.v
D:\Gowin\outputs\pressure_piano_D12_clean_20261102\src\game_engine28.v
D:\Gowin\outputs\pressure_piano_D12_clean_20261102\src\reset_sync.v
D:\Gowin\outputs\pressure_piano_D12_clean_20261102\src\debounce_bit.v
D:\Gowin\outputs\pressure_piano_D12_clean_20261102\src\instrument_controls.v
D:\Gowin\outputs\pressure_piano_D12_clean_20261102\src\mcp3008_scan.v
D:\Gowin\outputs\pressure_piano_D12_clean_20261102\src\pressure_frontend.v
D:\Gowin\outputs\pressure_piano_D12_clean_20261102\src\voice_allocator.v
D:\Gowin\outputs\pressure_piano_D12_clean_20261102\src\note_frequency.v
D:\Gowin\outputs\pressure_piano_D12_clean_20261102\src\piano_osc.v
D:\Gowin\outputs\pressure_piano_D12_clean_20261102\src\piano_voice.v
D:\Gowin\outputs\pressure_piano_D12_clean_20261102\src\tone_filter.v
D:\Gowin\outputs\pressure_piano_D12_clean_20261102\src\piano_engine.v
D:\Gowin\outputs\pressure_piano_D12_clean_20261102\src\pt8211_tx.v
D:\Gowin\outputs\pressure_piano_D12_clean_20261102\src\pressure_piano_top.v
D:\Gowin\outputs\pressure_piano_D12_clean_20261102\src\spectrum_fft.v
D:\Gowin\outputs\pressure_piano_D12_clean_20261102\src\spectrum_video.v
D:\Gowin\outputs\pressure_piano_D12_clean_20261102\src\spectrum_board.v
D:\Gowin\outputs\pressure_piano_D12_clean_20261102\src\pressure_piano_visual_top.v
D:\Gowin\outputs\pressure_piano_D12_clean_20261102\src\ip\DVI_TX_Top.v
D:\Gowin\outputs\pressure_piano_D12_clean_20261102\src\ip\spectrum_pll.v
D:\Gowin\outputs\pressure_piano_D12_clean_20261102\src\mcp3008_scan28.v
D:\Gowin\outputs\pressure_piano_D12_clean_20261102\src\pressure28_frontend.v
D:\Gowin\outputs\pressure_piano_D12_clean_20261102\src\sine28_shared.v
D:\Gowin\outputs\pressure_piano_D12_clean_20261102\src\note_frequency28.v
D:\Gowin\outputs\pressure_piano_D12_clean_20261102\src\piano28_engine.v
D:\Gowin\outputs\pressure_piano_D12_clean_20261102\src\piano28_core.v
D:\Gowin\outputs\pressure_piano_D12_clean_20261102\src\pressure_piano_28_top.v
D:\Gowin\outputs\pressure_piano_D12_clean_20261102\src\ws2812_frame_tx.v
D:\Gowin\outputs\pressure_piano_D12_clean_20261102\src\light_ripple28.v
D:\Gowin\outputs\pressure_piano_D12_clean_20261102\src\piano28_lights.v
D:\Gowin\outputs\pressure_piano_D12_clean_20261102\src\audio_status28.v
D:\Gowin\outputs\pressure_piano_D12_clean_20261102\src\touch_ui28.v
D:\Gowin\outputs\pressure_piano_D12_clean_20261102\src\piano_ui_renderer.v
D:\Gowin\outputs\pressure_piano_D12_clean_20261102\src\piano28_touch_system.v
D:\Gowin\outputs\pressure_piano_D12_clean_20261102\src\ws170120_reports.v
D:\Gowin\outputs\pressure_piano_D12_clean_20261102\src\usb_fs_phy60.v
D:\Gowin\outputs\pressure_piano_D12_clean_20261102\src\usb_fs_transaction.v
D:\Gowin\outputs\pressure_piano_D12_clean_20261102\src\ws170120_usb_host.v
D:\Gowin\outputs\pressure_piano_D12_clean_20261102\src\usb_touch_board.v
D:\Gowin\outputs\pressure_piano_D12_clean_20261102\src\usb_session_guard.v
D:\Gowin\outputs\pressure_piano_D12_clean_20261102\src\usb_pad_buffer.v
D:\Gowin\outputs\pressure_piano_D12_clean_20261102\src\usb_pad_pair_registered.v
D:\Gowin\outputs\pressure_piano_D12_clean_20261102\src\usb_diag_bridge.v
D:\Gowin\outputs\pressure_piano_D12_clean_20261102\src\ip\usb_pll60.v
D:\Gowin\outputs\pressure_piano_D12_clean_20261102\src\VexRiscv.v
D:\Gowin\outputs\pressure_piano_D12_clean_20261102\src\media_soc.v
D:\Gowin\outputs\pressure_piano_D12_clean_20261102\src\media_ui28.v
D:\Gowin\outputs\pressure_piano_D12_clean_20261102\src\media_ui_renderer.v
D:\Gowin\outputs\pressure_piano_D12_clean_20261102\src\media_memories.v
D:\Gowin\outputs\pressure_piano_D12_clean_20261102\src\piano28_timbre_engine.v
GowinSynthesis Constraints File | ---
Tool Version | V1.9.11.03 Education
Part Number | GW5AT-LV60PG484AC1/I0
Device | GW5AT-60
Device Version | B
Created Time | Mon Nov 2 15:16:11 2026
Legal Announcement | Copyright (C)2014-2025 Gowin Semiconductor Corporation. ALL rights reserved.

# Synthesis Details

Top Level Module | pressure_piano_28_touch_top

Synthesis Process

Running parser:
CPU time = 0h 0m 16s, Elapsed time = 0h 0m 18s, Peak memory usage = 514.379MB
Running netlist conversion:
CPU time = 0h 0m 0s, Elapsed time = 0h 0m 0s, Peak memory usage = 0MB
Running device independent optimization:
Optimizing Phase 0: CPU time = 0h 0m 15s, Elapsed time = 0h 0m 17s, Peak memory usage = 514.379MB
Optimizing Phase 1: CPU time = 0h 0m 6s, Elapsed time = 0h 0m 7s, Peak memory usage = 514.379MB
Optimizing Phase 2: CPU time = 0h 0m 32s, Elapsed time = 0h 0m 37s, Peak memory usage = 514.379MB
Running inference:
Inferring Phase 0: CPU time = 0h 1m 3s, Elapsed time = 0h 1m 15s, Peak memory usage = 514.379MB
Inferring Phase 1: CPU time = 0h 0m 13s, Elapsed time = 0h 0m 15s, Peak memory usage = 514.379MB
Inferring Phase 2: CPU time = 0h 0m 0.64s, Elapsed time = 0h 0m 0.675s, Peak memory usage = 514.379MB
Inferring Phase 3: CPU time = 0h 0m 0.593s, Elapsed time = 0h 0m 0.686s, Peak memory usage = 514.379MB
Running technical mapping:
Tech-Mapping Phase 0: CPU time = 0h 0m 18s, Elapsed time = 0h 0m 21s, Peak memory usage = 514.379MB
Tech-Mapping Phase 1: CPU time = 0h 0m 3s, Elapsed time = 0h 0m 3s, Peak memory usage = 514.379MB
Tech-Mapping Phase 2: CPU time = 0h 0m 5s, Elapsed time = 0h 0m 6s, Peak memory usage = 514.379MB
Tech-Mapping Phase 3: CPU time = 0h 4m 49s, Elapsed time = 0h 5m 13s, Peak memory usage = 514.379MB
Tech-Mapping Phase 4: CPU time = 0h 0m 5s, Elapsed time = 0h 0m 5s, Peak memory usage = 514.379MB
Generate output files:
CPU time = 0h 0m 4s, Elapsed time = 0h 0m 5s, Peak memory usage = 640.293MB
Total Time and Memory Usage | CPU time = 0h 7m 50s, Elapsed time = 0h 8m 43s, Peak memory usage = 640.293MB

# Resource

## Resource Usage Summary

Resource | Usage
I/O Port | 58
I/O Buf | 54
IBUF | 19
OBUF | 25
TBUF | 4
IOBUF | 2
TLVDS_OBUF | 4
Register | 14544
DFFSE | 60
DFFRE | 2260
DFFPE | 207
DFFCE | 12017
LUT | 28344
LUT2 | 2681
LUT3 | 9078
LUT4 | 16585
ALU | 5679
ALU | 5679
SSRAM | 81
RAM16SDP4 | 81
ROM16 | 3577
ROM16 | 3577
INV | 68
INV | 68
IOLOGIC | 4
OSER10 | 4
DSP
MULTALU27X18 | 19
MULT12X12 | 103
MULT27X36 | 1
BSRAM | 84
SPX9 | 12
SDPB | 42
SDPX9B | 4
pROM | 25
pROMX9 | 1
CLOCK | 2
PLLA | 2

## Resource Utilization Summary

Resource | Usage | Utilization
Logic | 38154(28412 LUT, 5679 ALU, 3577 ROM16, 81 RAM16) / 59904 | 64%
Register | 14544 / 60780 | 24%
--Register as Latch | 0 / 60780 | 0%
--Register as FF | 14544 / 60780 | 24%
BSRAM | 84 / 118 | 72%

# Timing

## Clock Summary:

NO. | Clock Name | Type | Period | Frequency(MHz) | Rise | Fall | Source | Master | Object
1 | sys_clk | Base | 20.000 | 50.000 | 0.000 | 10.000 | | | sys_clk_ibuf/I
2 | u_usb_pll/PLLA_inst/CLKOUT0.default_gen_clk | Generated | 16.667 | 60.000 | 0.000 | 8.333 | sys_clk_ibuf/I | sys_clk | u_usb_pll/PLLA_inst/CLKOUT0
3 | u_system/u_video_pll/PLLA_inst/CLKOUT0.default_gen_clk | Generated | 6.667 | 150.000 | 0.000 | 3.333 | sys_clk_ibuf/I | sys_clk | u_system/u_video_pll/PLLA_inst/CLKOUT0
4 | u_system/u_video_pll/PLLA_inst/CLKOUT1.default_gen_clk | Generated | 33.333 | 30.000 | 0.000 | 16.667 | sys_clk_ibuf/I | sys_clk | u_system/u_video_pll/PLLA_inst/CLKOUT1

## Max Frequency Summary:

NO. | Clock Name | Constraint | Actual Fmax | Logic Level | Entity
1 | sys_clk | 50.000(MHz) | 53.601(MHz) | 21 | TOP
2 | u_usb_pll/PLLA_inst/CLKOUT0.default_gen_clk | 60.000(MHz) | 102.341(MHz) | 12 | TOP
3 | u_system/u_video_pll/PLLA_inst/CLKOUT1.default_gen_clk | 30.000(MHz) | 47.147(MHz) | 23 | TOP

## Detail Timing Paths Information

### Path 1

Path Summary:

Slack | 1.294
Data Arrival Time | 18.982
Data Required Time | 20.276
From | u_usb2_pads/pad_oe_n_s0
To | usb_pin_meta_2_s0
Launch Clk | u_usb_pll/PLLA_inst/CLKOUT0.default_gen_clk[R]
Latch Clk | sys_clk[R]

Data Arrival Path:

AT | DELAY | TYPE | RF | FANOUT | NODE
16.667 | 0.000 | | | | u_usb_pll/PLLA_inst/CLKOUT0.default_gen_clk
16.948 | 0.281 | tCL | RR | 2642 | u_usb_pll/PLLA_inst/CLKOUT0
17.323 | 0.375 | tNET | RR | 1 | u_usb2_pads/pad_oe_n_s0/CLK
17.706 | 0.382 | tC2Q | RR | 3 | u_usb2_pads/pad_oe_n_s0/Q
18.081 | 0.375 | tNET | RR | 1 | u_usb2_pads/usb_drive_s0/I0
18.607 | 0.526 | tINS | RR | 1 | u_usb2_pads/usb_drive_s0/F
18.982 | 0.375 | tNET | RR | 1 | usb_pin_meta_2_s0/D

Data Required Path:

AT | DELAY | TYPE | RF | FANOUT | NODE
20.000 | 0.000 | | | | sys_clk
20.000 | 0.000 | tCL | RR | 1 | sys_clk_ibuf/I
20.000 | 0.000 | tINS | RR | 10419 | sys_clk_ibuf/O
20.375 | 0.375 | tNET | RR | 1 | usb_pin_meta_2_s0/CLK
20.340 | -0.035 | tUnc | | | usb_pin_meta_2_s0
20.276 | -0.064 | tSu | | 1 | usb_pin_meta_2_s0

Path Statistics:

Clock Skew: | -0.281
Setup Relationship: | 3.333
Logic Level: | 2
Arrival Clock Path Delay: | cell: 0.000, 0.000%; route: 0.375, 100.000%
Arrival Data Path Delay: | cell: 0.526, 31.726%; route: 0.750, 45.214%; tC2Q: 0.382, 23.060%
Required Clock Path Delay: | cell: 0.000, 0.000%; route: 0.375, 100.000%

### Path 2

Path Summary:

Slack | 1.344
Data Arrival Time | 18.968
Data Required Time | 20.311
From | u_system/media.u_media/u_game/rp_0_s1
To | u_system/media.u_media/u_game/window_open_q_s0
Launch Clk | sys_clk[R]
Latch Clk | sys_clk[R]

Data Arrival Path:

AT | DELAY | TYPE | RF | FANOUT | NODE
0.000 | 0.000 | | | | sys_clk
0.000 | 0.000 | tCL | RR | 1 | sys_clk_ibuf/I
0.000 | 0.000 | tINS | RR | 10419 | sys_clk_ibuf/O
0.375 | 0.375 | tNET | RR | 1 | u_system/media.u_media/u_game/rp_0_s1/CLK
0.757 | 0.382 | tC2Q | RR | 36 | u_system/media.u_media/u_game/rp_0_s1/Q
1.132 | 0.375 | tNET | RR | 4 | u_system/media.u_media/u_game/queue_queue_0_0_s/RAD[0]
1.659 | 0.526 | tINS | RR | 4 | u_system/media.u_media/u_game/queue_queue_0_0_s/DO[1]
2.034 | 0.375 | tNET | RR | 1 | u_system/media.u_media/u_game/n1653_s4/I0
2.560 | 0.526 | tINS | RR | 10 | u_system/media.u_media/u_game/n1653_s4/F
2.935 | 0.375 | tNET | RR | 1 | u_system/media.u_media/u_game/n1651_s5/I0
3.461 | 0.526 | tINS | RR | 5 | u_system/media.u_media/u_game/n1651_s5/F
3.836 | 0.375 | tNET | RR | 1 | u_system/media.u_media/u_game/n1408_s5/I0
4.362 | 0.526 | tINS | RR | 1 | u_system/media.u_media/u_game/n1408_s5/F
4.737 | 0.375 | tNET | RR | 1 | u_system/media.u_media/u_game/n1408_s3/I1
5.254 | 0.516 | tINS | RR | 1 | u_system/media.u_media/u_game/n1408_s3/F
5.629 | 0.375 | tNET | RR | 1 | u_system/media.u_media/u_game/n1408_s2/I1
6.145 | 0.516 | tINS | RR | 22 | u_system/media.u_media/u_game/n1408_s2/F
6.520 | 0.375 | tNET | RR | 1 | u_system/media.u_media/u_game/n1888_s19/I1
7.036 | 0.516 | tINS | RR | 3 | u_system/media.u_media/u_game/n1888_s19/F
7.411 | 0.375 | tNET | RR | 1 | u_system/media.u_media/u_game/compare_step_6_s63/I1
7.928 | 0.516 | tINS | RR | 1 | u_system/media.u_media/u_game/compare_step_6_s63/F
8.302 | 0.375 | tNET | RR | 1 | u_system/media.u_media/u_game/compare_step_6_s62/I0
8.829 | 0.526 | tINS | RR | 1 | u_system/media.u_media/u_game/compare_step_6_s62/F
9.204 | 0.375 | tNET | RR | 1 | u_system/media.u_media/u_game/compare_step_6_s61/I1
9.720 | 0.516 | tINS | RR | 1 | u_system/media.u_media/u_game/compare_step_6_s61/F
10.095 | 0.375 | tNET | RR | 1 | u_system/media.u_media/u_game/compare_step_6_s58/I0
10.621 | 0.526 | tINS | RR | 1 | u_system/media.u_media/u_game/compare_step_6_s58/F
10.996 | 0.375 | tNET | RR | 1 | u_system/media.u_media/u_game/compare_step_6_s55/I0
11.522 | 0.526 | tINS | RR | 1 | u_system/media.u_media/u_game/compare_step_6_s55/F
11.897 | 0.375 | tNET | RR | 1 | u_system/media.u_media/u_game/compare_step_6_s51/I2
12.359 | 0.461 | tINS | RR | 1 | u_system/media.u_media/u_game/compare_step_6_s51/F
12.734 | 0.375 | tNET | RR | 1 | u_system/media.u_media/u_game/compare_step_6_s47/I0
13.260 | 0.526 | tINS | RR | 1 | u_system/media.u_media/u_game/compare_step_6_s47/F
13.635 | 0.375 | tNET | RR | 1 | u_system/media.u_media/u_game/compare_step_6_s43/I0
14.161 | 0.526 | tINS | RR | 1 | u_system/media.u_media/u_game/compare_step_6_s43/F
14.536 | 0.375 | tNET | RR | 1 | u_system/media.u_media/u_game/compare_step_6_s42/I0
15.062 | 0.526 | tINS | RR | 1 | u_system/media.u_media/u_game/compare_step_6_s42/F
15.437 | 0.375 | tNET | RR | 1 | u_system/media.u_media/u_game/compare_step_6_s41/I2
15.899 | 0.461 | tINS | RR | 1 | u_system/media.u_media/u_game/compare_step_6_s41/F
16.274 | 0.375 | tNET | RR | 1 | u_system/media.u_media/u_game/compare_step_6_s40/I0
16.800 | 0.526 | tINS | RR | 2 | u_system/media.u_media/u_game/compare_step_6_s40/F
17.175 | 0.375 | tNET | RR | 1 | u_system/media.u_media/u_game/n1888_s2/I0
17.701 | 0.526 | tINS | RR | 1 | u_system/media.u_media/u_game/n1888_s2/F
18.076 | 0.375 | tNET | RR | 1 | u_system/media.u_media/u_game/n1888_s0/I1
18.593 | 0.516 | tINS | RR | 1 | u_system/media.u_media/u_game/n1888_s0/F
18.968 | 0.375 | tNET | RR | 1 | u_system/media.u_media/u_game/window_open_q_s0/D

Data Required Path:

AT | DELAY | TYPE | RF | FANOUT | NODE
20.000 | 0.000 | | | | sys_clk
20.000 | 0.000 | tCL | RR | 1 | sys_clk_ibuf/I
20.000 | 0.000 | tINS | RR | 10419 | sys_clk_ibuf/O
20.375 | 0.375 | tNET | RR | 1 | u_system/media.u_media/u_game/window_open_q_s0/CLK
20.311 | -0.064 | tSu | | 1 | u_system/media.u_media/u_game/window_open_q_s0

Path Statistics:

Clock Skew: | 0.000
Setup Relationship: | 20.000
Logic Level: | 21
Arrival Clock Path Delay: | cell: 0.000, 0.000%; route: 0.375, 100.000%
Arrival Data Path Delay: | cell: 10.335, 55.587%; route: 7.875, 42.356%; tC2Q: 0.382, 2.057%
Required Clock Path Delay: | cell: 0.000, 0.000%; route: 0.375, 100.000%

### Path 3

Path Summary:

Slack | 1.344
Data Arrival Time | 18.968
Data Required Time | 20.311
From | u_system/media.u_media/u_game/rp_0_s1
To | u_system/media.u_media/u_game/guide_due_q_s0
Launch Clk | sys_clk[R]
Latch Clk | sys_clk[R]

Data Arrival Path:

AT | DELAY | TYPE | RF | FANOUT | NODE
0.000 | 0.000 | | | | sys_clk
0.000 | 0.000 | tCL | RR | 1 | sys_clk_ibuf/I
0.000 | 0.000 | tINS | RR | 10419 | sys_clk_ibuf/O
0.375 | 0.375 | tNET | RR | 1 | u_system/media.u_media/u_game/rp_0_s1/CLK
0.757 | 0.382 | tC2Q | RR | 36 | u_system/media.u_media/u_game/rp_0_s1/Q
1.132 | 0.375 | tNET | RR | 4 | u_system/media.u_media/u_game/queue_queue_0_0_s/RAD[0]
1.659 | 0.526 | tINS | RR | 4 | u_system/media.u_media/u_game/queue_queue_0_0_s/DO[1]
2.034 | 0.375 | tNET | RR | 1 | u_system/media.u_media/u_game/n1653_s4/I0
2.560 | 0.526 | tINS | RR | 10 | u_system/media.u_media/u_game/n1653_s4/F
2.935 | 0.375 | tNET | RR | 1 | u_system/media.u_media/u_game/n1651_s5/I0
3.461 | 0.526 | tINS | RR | 5 | u_system/media.u_media/u_game/n1651_s5/F
3.836 | 0.375 | tNET | RR | 1 | u_system/media.u_media/u_game/n1408_s5/I0
4.362 | 0.526 | tINS | RR | 1 | u_system/media.u_media/u_game/n1408_s5/F
4.737 | 0.375 | tNET | RR | 1 | u_system/media.u_media/u_game/n1408_s3/I1
5.254 | 0.516 | tINS | RR | 1 | u_system/media.u_media/u_game/n1408_s3/F
5.629 | 0.375 | tNET | RR | 1 | u_system/media.u_media/u_game/n1408_s2/I1
6.145 | 0.516 | tINS | RR | 22 | u_system/media.u_media/u_game/n1408_s2/F
6.520 | 0.375 | tNET | RR | 1 | u_system/media.u_media/u_game/n1888_s19/I1
7.036 | 0.516 | tINS | RR | 3 | u_system/media.u_media/u_game/n1888_s19/F
7.411 | 0.375 | tNET | RR | 1 | u_system/media.u_media/u_game/compare_step_6_s63/I1
7.928 | 0.516 | tINS | RR | 1 | u_system/media.u_media/u_game/compare_step_6_s63/F
8.302 | 0.375 | tNET | RR | 1 | u_system/media.u_media/u_game/compare_step_6_s62/I0
8.829 | 0.526 | tINS | RR | 1 | u_system/media.u_media/u_game/compare_step_6_s62/F
9.204 | 0.375 | tNET | RR | 1 | u_system/media.u_media/u_game/compare_step_6_s61/I1
9.720 | 0.516 | tINS | RR | 1 | u_system/media.u_media/u_game/compare_step_6_s61/F
10.095 | 0.375 | tNET | RR | 1 | u_system/media.u_media/u_game/compare_step_6_s58/I0
10.621 | 0.526 | tINS | RR | 1 | u_system/media.u_media/u_game/compare_step_6_s58/F
10.996 | 0.375 | tNET | RR | 1 | u_system/media.u_media/u_game/compare_step_6_s55/I0
11.522 | 0.526 | tINS | RR | 1 | u_system/media.u_media/u_game/compare_step_6_s55/F
11.897 | 0.375 | tNET | RR | 1 | u_system/media.u_media/u_game/compare_step_6_s51/I2
12.359 | 0.461 | tINS | RR | 1 | u_system/media.u_media/u_game/compare_step_6_s51/F
12.734 | 0.375 | tNET | RR | 1 | u_system/media.u_media/u_game/compare_step_6_s47/I0
13.260 | 0.526 | tINS | RR | 1 | u_system/media.u_media/u_game/compare_step_6_s47/F
13.635 | 0.375 | tNET | RR | 1 | u_system/media.u_media/u_game/compare_step_6_s43/I0
14.161 | 0.526 | tINS | RR | 1 | u_system/media.u_media/u_game/compare_step_6_s43/F
14.536 | 0.375 | tNET | RR | 1 | u_system/media.u_media/u_game/compare_step_6_s42/I0
15.062 | 0.526 | tINS | RR | 1 | u_system/media.u_media/u_game/compare_step_6_s42/F
15.437 | 0.375 | tNET | RR | 1 | u_system/media.u_media/u_game/compare_step_6_s41/I2
15.899 | 0.461 | tINS | RR | 1 | u_system/media.u_media/u_game/compare_step_6_s41/F
16.274 | 0.375 | tNET | RR | 1 | u_system/media.u_media/u_game/compare_step_6_s40/I0
16.800 | 0.526 | tINS | RR | 2 | u_system/media.u_media/u_game/compare_step_6_s40/F
17.175 | 0.375 | tNET | RR | 1 | u_system/media.u_media/u_game/n1892_s1/I0
17.701 | 0.526 | tINS | RR | 1 | u_system/media.u_media/u_game/n1892_s1/F
18.076 | 0.375 | tNET | RR | 1 | u_system/media.u_media/u_game/n1892_s0/I1
18.593 | 0.516 | tINS | RR | 1 | u_system/media.u_media/u_game/n1892_s0/F
18.968 | 0.375 | tNET | RR | 1 | u_system/media.u_media/u_game/guide_due_q_s0/D

Data Required Path:

AT | DELAY | TYPE | RF | FANOUT | NODE
20.000 | 0.000 | | | | sys_clk
20.000 | 0.000 | tCL | RR | 1 | sys_clk_ibuf/I
20.000 | 0.000 | tINS | RR | 10419 | sys_clk_ibuf/O
20.375 | 0.375 | tNET | RR | 1 | u_system/media.u_media/u_game/guide_due_q_s0/CLK
20.311 | -0.064 | tSu | | 1 | u_system/media.u_media/u_game/guide_due_q_s0

Path Statistics:

Clock Skew: | 0.000
Setup Relationship: | 20.000
Logic Level: | 21
Arrival Clock Path Delay: | cell: 0.000, 0.000%; route: 0.375, 100.000%
Arrival Data Path Delay: | cell: 10.335, 55.587%; route: 7.875, 42.356%; tC2Q: 0.382, 2.057%
Required Clock Path Delay: | cell: 0.000, 0.000%; route: 0.375, 100.000%

### Path 4

Path Summary:

Slack | 1.936
Data Arrival Time | 18.375
Data Required Time | 20.311
From | u_system/media.u_media/u_game/rp_0_s1
To | u_system/media.u_media/u_game/perfect_open_q_s0
Launch Clk | sys_clk[R]
Latch Clk | sys_clk[R]

Data Arrival Path:

AT | DELAY | TYPE | RF | FANOUT | NODE
0.000 | 0.000 | | | | sys_clk
0.000 | 0.000 | tCL | RR | 1 | sys_clk_ibuf/I
0.000 | 0.000 | tINS | RR | 10419 | sys_clk_ibuf/O
0.375 | 0.375 | tNET | RR | 1 | u_system/media.u_media/u_game/rp_0_s1/CLK
0.757 | 0.382 | tC2Q | RR | 36 | u_system/media.u_media/u_game/rp_0_s1/Q
1.132 | 0.375 | tNET | RR | 4 | u_system/media.u_media/u_game/queue_queue_0_3_s/RAD[0]
1.659 | 0.526 | tINS | RR | 3 | u_system/media.u_media/u_game/queue_queue_0_3_s/DO[2]
2.034 | 0.375 | tNET | RR | 1 | u_system/media.u_media/u_game/queue_DOL_14_G[0]_s0/I0
2.560 | 0.526 | tINS | RR | 7 | u_system/media.u_media/u_game/queue_DOL_14_G[0]_s0/F
2.935 | 0.375 | tNET | RR | 1 | u_system/media.u_media/u_game/n1615_s7/I0
3.461 | 0.526 | tINS | RR | 1 | u_system/media.u_media/u_game/n1615_s7/F
3.836 | 0.375 | tNET | RR | 1 | u_system/media.u_media/u_game/n1615_s6/I2
4.297 | 0.461 | tINS | RR | 1 | u_system/media.u_media/u_game/n1615_s6/F
4.672 | 0.375 | tNET | RR | 1 | u_system/media.u_media/u_game/n1615_s4/I3
4.935 | 0.262 | tINS | RR | 2 | u_system/media.u_media/u_game/n1615_s4/F
5.310 | 0.375 | tNET | RR | 1 | u_system/media.u_media/u_game/n1615_s2/I3
5.572 | 0.262 | tINS | RR | 22 | u_system/media.u_media/u_game/n1615_s2/F
5.947 | 0.375 | tNET | RR | 1 | u_system/media.u_media/u_game/n1890_s24/I1
6.464 | 0.516 | tINS | RR | 3 | u_system/media.u_media/u_game/n1890_s24/F
6.839 | 0.375 | tNET | RR | 1 | u_system/media.u_media/u_game/compare_step_4_s68/I1
7.355 | 0.516 | tINS | RR | 1 | u_system/media.u_media/u_game/compare_step_4_s68/F
7.730 | 0.375 | tNET | RR | 1 | u_system/media.u_media/u_game/compare_step_4_s66/I0
8.256 | 0.526 | tINS | RR | 1 | u_system/media.u_media/u_game/compare_step_4_s66/F
8.631 | 0.375 | tNET | RR | 1 | u_system/media.u_media/u_game/compare_step_4_s64/I1
9.147 | 0.516 | tINS | RR | 1 | u_system/media.u_media/u_game/compare_step_4_s64/F
9.522 | 0.375 | tNET | RR | 1 | u_system/media.u_media/u_game/compare_step_4_s62/I2
9.984 | 0.461 | tINS | RR | 1 | u_system/media.u_media/u_game/compare_step_4_s62/F
10.359 | 0.375 | tNET | RR | 1 | u_system/media.u_media/u_game/compare_step_4_s58/I0
10.885 | 0.526 | tINS | RR | 1 | u_system/media.u_media/u_game/compare_step_4_s58/F
11.260 | 0.375 | tNET | RR | 1 | u_system/media.u_media/u_game/compare_step_4_s56/I0
11.786 | 0.526 | tINS | RR | 1 | u_system/media.u_media/u_game/compare_step_4_s56/F
12.161 | 0.375 | tNET | RR | 1 | u_system/media.u_media/u_game/compare_step_4_s53/I2
12.622 | 0.461 | tINS | RR | 2 | u_system/media.u_media/u_game/compare_step_4_s53/F
12.997 | 0.375 | tNET | RR | 1 | u_system/media.u_media/u_game/compare_step_4_s47/I1
13.514 | 0.516 | tINS | RR | 1 | u_system/media.u_media/u_game/compare_step_4_s47/F
13.889 | 0.375 | tNET | RR | 1 | u_system/media.u_media/u_game/compare_step_4_s44/I0
14.415 | 0.526 | tINS | RR | 2 | u_system/media.u_media/u_game/compare_step_4_s44/F
14.790 | 0.375 | tNET | RR | 1 | u_system/media.u_media/u_game/compare_step_4_s41/I1
15.306 | 0.516 | tINS | RR | 1 | u_system/media.u_media/u_game/compare_step_4_s41/F
15.681 | 0.375 | tNET | RR | 1 | u_system/media.u_media/u_game/compare_step_4_s40/I0
16.207 | 0.526 | tINS | RR | 1 | u_system/media.u_media/u_game/compare_step_4_s40/F
16.582 | 0.375 | tNET | RR | 1 | u_system/media.u_media/u_game/n1890_s2/I0
17.109 | 0.526 | tINS | RR | 1 | u_system/media.u_media/u_game/n1890_s2/F
17.484 | 0.375 | tNET | RR | 1 | u_system/media.u_media/u_game/n1890_s0/I1
18.000 | 0.516 | tINS | RR | 1 | u_system/media.u_media/u_game/n1890_s0/F
18.375 | 0.375 | tNET | RR | 1 | u_system/media.u_media/u_game/perfect_open_q_s0/D

Data Required Path:

AT | DELAY | TYPE | RF | FANOUT | NODE
20.000 | 0.000 | | | | sys_clk
20.000 | 0.000 | tCL | RR | 1 | sys_clk_ibuf/I
20.000 | 0.000 | tINS | RR | 10419 | sys_clk_ibuf/O
20.375 | 0.375 | tNET | RR | 1 | u_system/media.u_media/u_game/perfect_open_q_s0/CLK
20.311 | -0.064 | tSu | | 1 | u_system/media.u_media/u_game/perfect_open_q_s0

Path Statistics:

Clock Skew: | 0.000
Setup Relationship: | 20.000
Logic Level: | 21
Arrival Clock Path Delay: | cell: 0.000, 0.000%; route: 0.375, 100.000%
Arrival Data Path Delay: | cell: 9.742, 54.125%; route: 7.875, 43.750%; tC2Q: 0.382, 2.125%
Required Clock Path Delay: | cell: 0.000, 0.000%; route: 0.375, 100.000%

### Path 5

Path Summary:

Slack | 2.196
Data Arrival Time | 18.081
Data Required Time | 20.276
From | u_usb_diag/u_cdc/held_data_0_s0
To | u_usb_diag/u_cdc/dst_data_0_s0
Launch Clk | u_usb_pll/PLLA_inst/CLKOUT0.default_gen_clk[R]
Latch Clk | sys_clk[R]

Data Arrival Path:

AT | DELAY | TYPE | RF | FANOUT | NODE
16.667 | 0.000 | | | | u_usb_pll/PLLA_inst/CLKOUT0.default_gen_clk
16.948 | 0.281 | tCL | RR | 2642 | u_usb_pll/PLLA_inst/CLKOUT0
17.323 | 0.375 | tNET | RR | 1 | u_usb_diag/u_cdc/held_data_0_s0/CLK
17.706 | 0.382 | tC2Q | RR | 1 | u_usb_diag/u_cdc/held_data_0_s0/Q
18.081 | 0.375 | tNET | RR | 1 | u_usb_diag/u_cdc/dst_data_0_s0/D

Data Required Path:

AT | DELAY | TYPE | RF | FANOUT | NODE
20.000 | 0.000 | | | | sys_clk
20.000 | 0.000 | tCL | RR | 1 | sys_clk_ibuf/I
20.000 | 0.000 | tINS | RR | 10419 | sys_clk_ibuf/O
20.375 | 0.375 | tNET | RR | 1 | u_usb_diag/u_cdc/dst_data_0_s0/CLK
20.340 | -0.035 | tUnc | | | u_usb_diag/u_cdc/dst_data_0_s0
20.276 | -0.064 | tSu | | 1 | u_usb_diag/u_cdc/dst_data_0_s0

Path Statistics:

Clock Skew: | -0.281
Setup Relationship: | 3.333
Logic Level: | 1
Arrival Clock Path Delay: | cell: 0.000, 0.000%; route: 0.375, 100.000%
Arrival Data Path Delay: | cell: 0.000, 0.000%; route: 0.375, 49.505%; tC2Q: 0.382, 50.495%
Required Clock Path Delay: | cell: 0.000, 0.000%; route: 0.375, 100.000%
