xuanxly/fpga-piano-Chuyun/assets/photos/screen-back.jpg

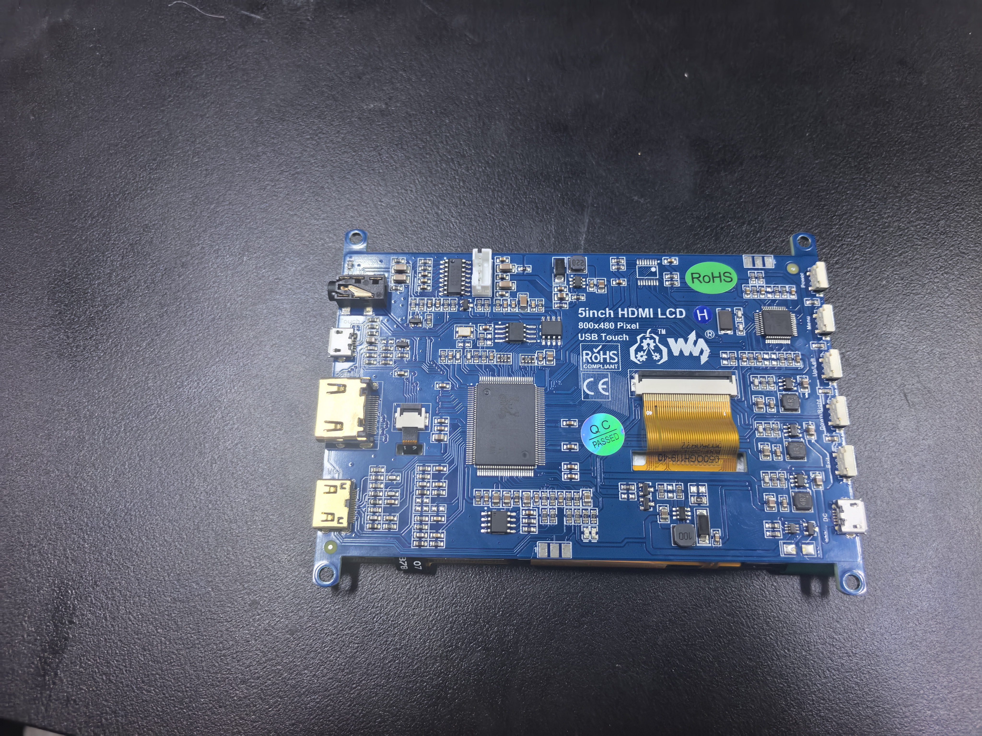
assets/photos/screen-back.jpg
