xuanxly/fpga-piano-Chuyun/assets/photos/screen-front.jpg

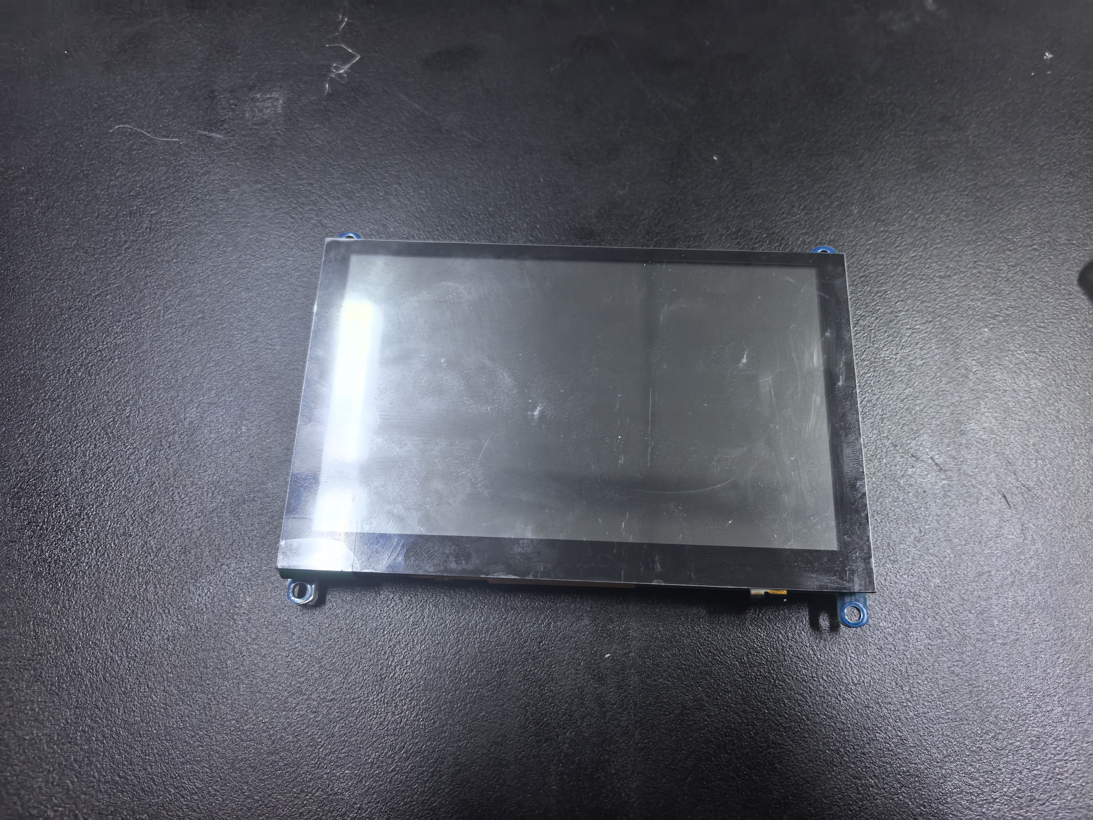
assets/photos/screen-front.jpg
