xuanxly/fpga-piano-Chuyun/fpga/d13/docs/song_sources/QLX_EASY_20261102/user_score.png

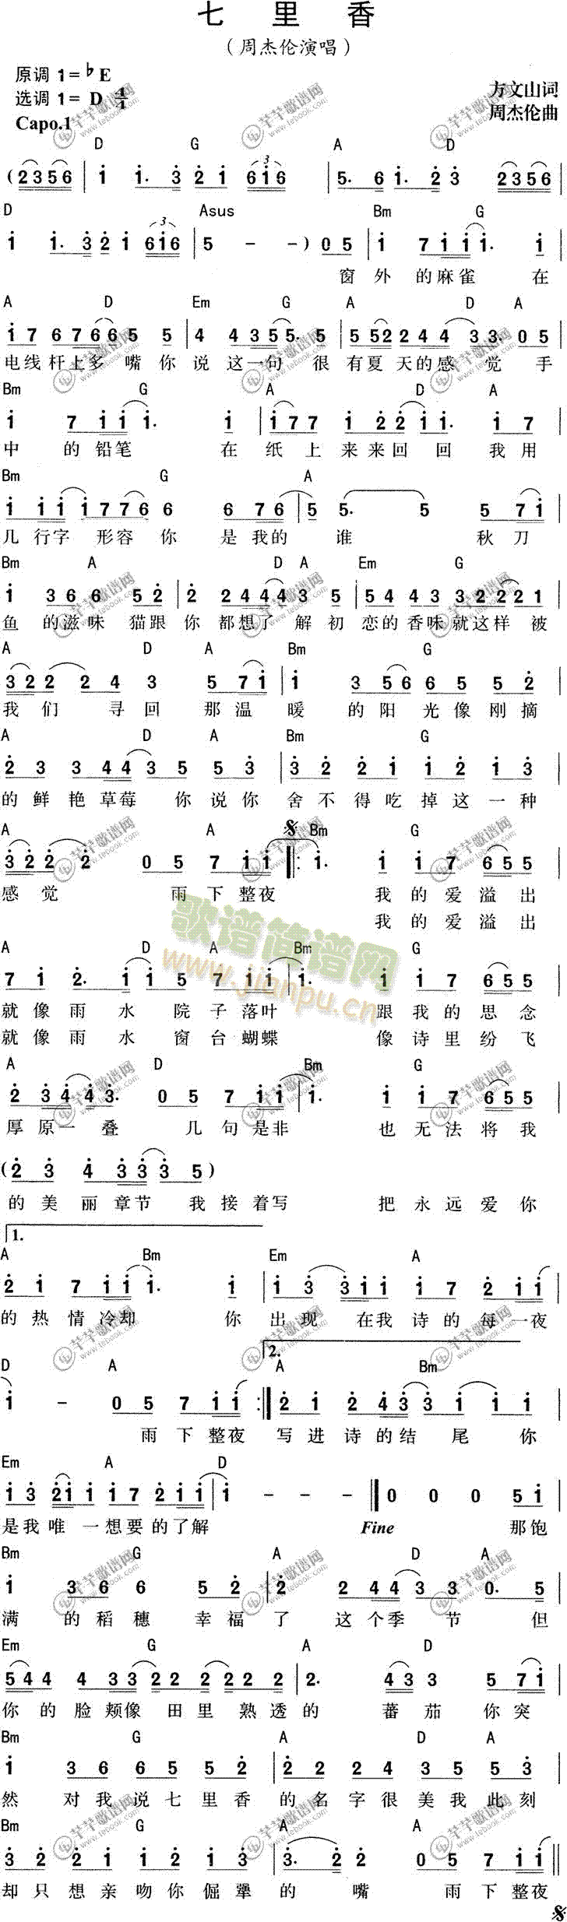
fpga/d13/docs/song_sources/QLX_EASY_20261102/user_score.png
