xuanxly/fpga-piano-Chuyun/hardware/electronics/control/pcb.png

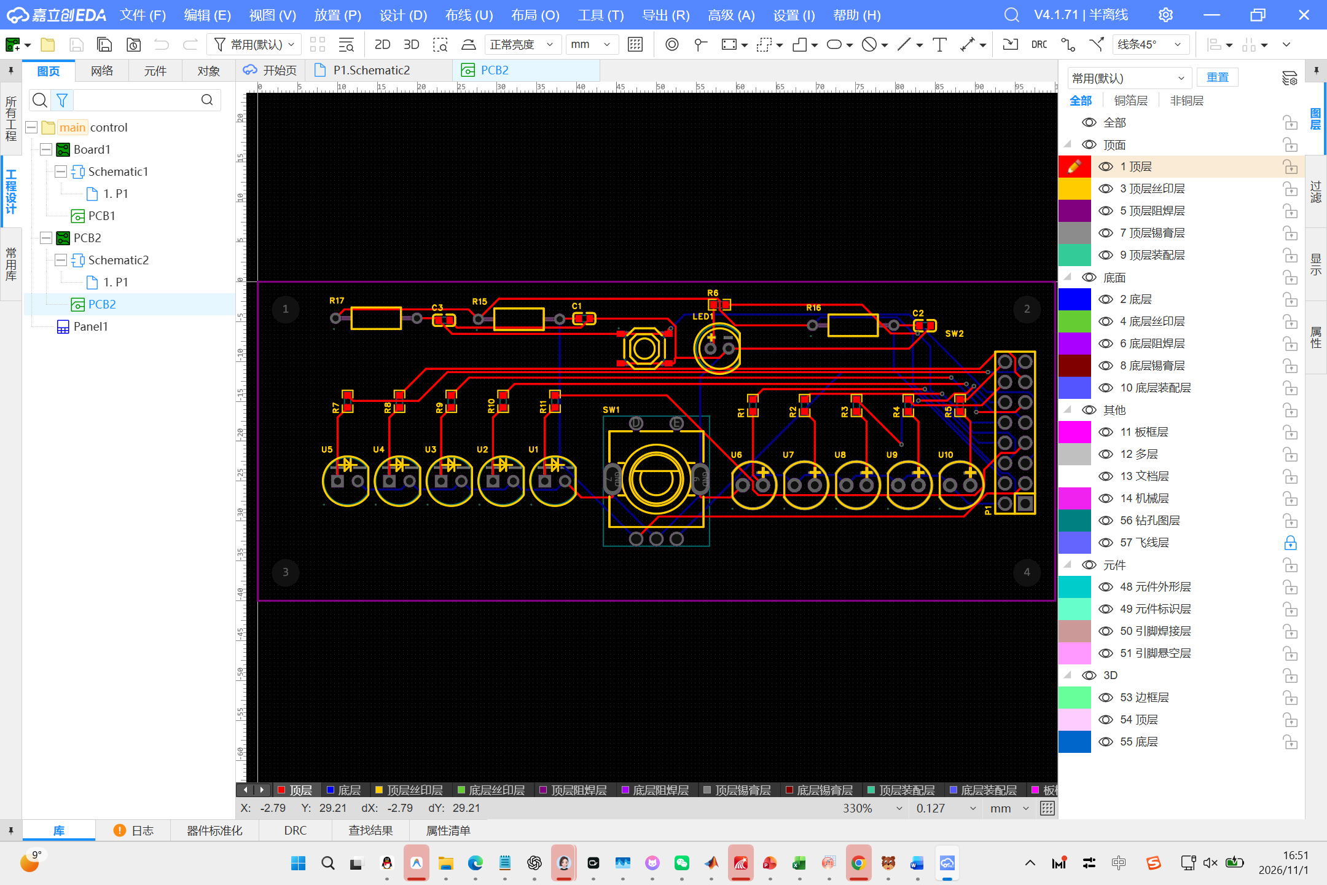
hardware/electronics/control/pcb.png
