xuanxly/fpga-piano-Chuyun/hardware/electronics/control/schematic.png

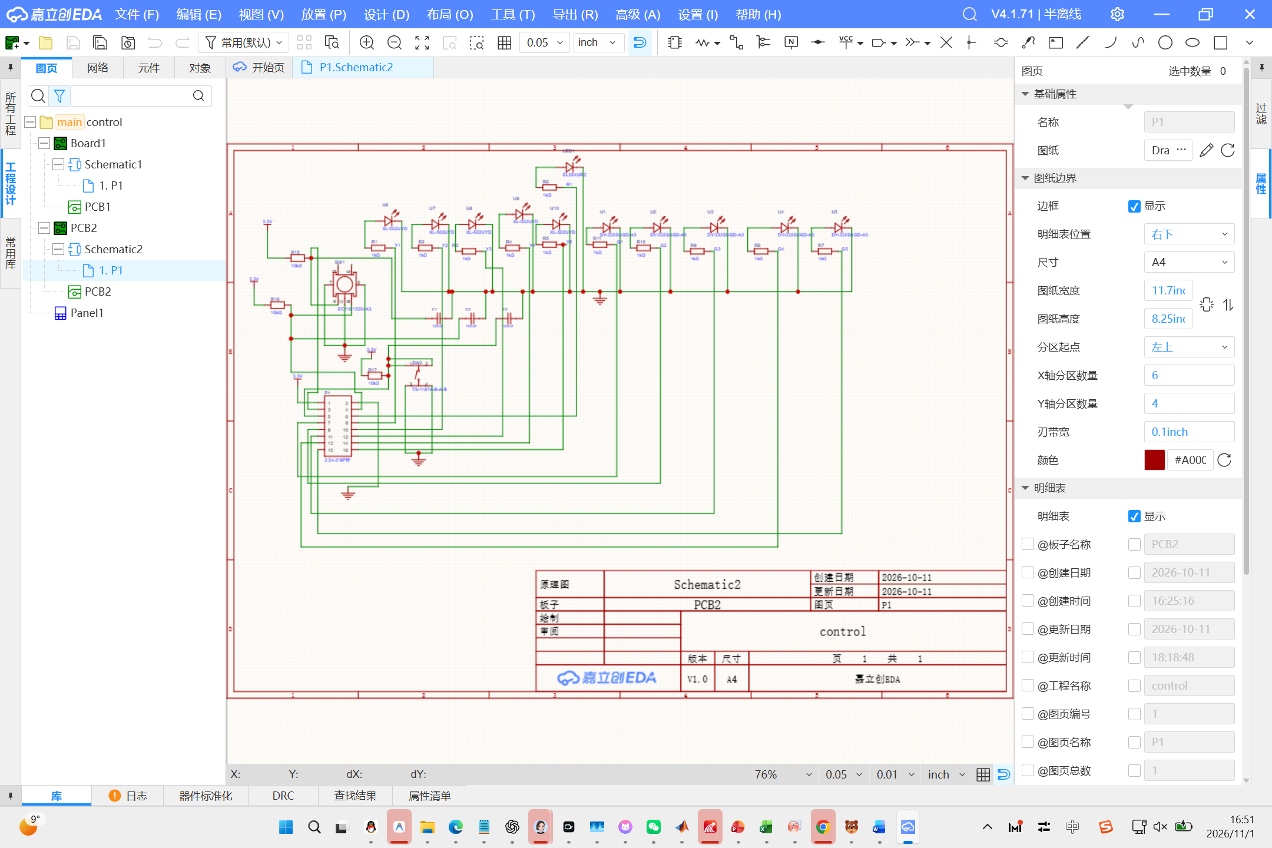
hardware/electronics/control/schematic.png
