xuanxly/fpga-piano-Chuyun/hardware/electronics/lighting/input-buffer.png

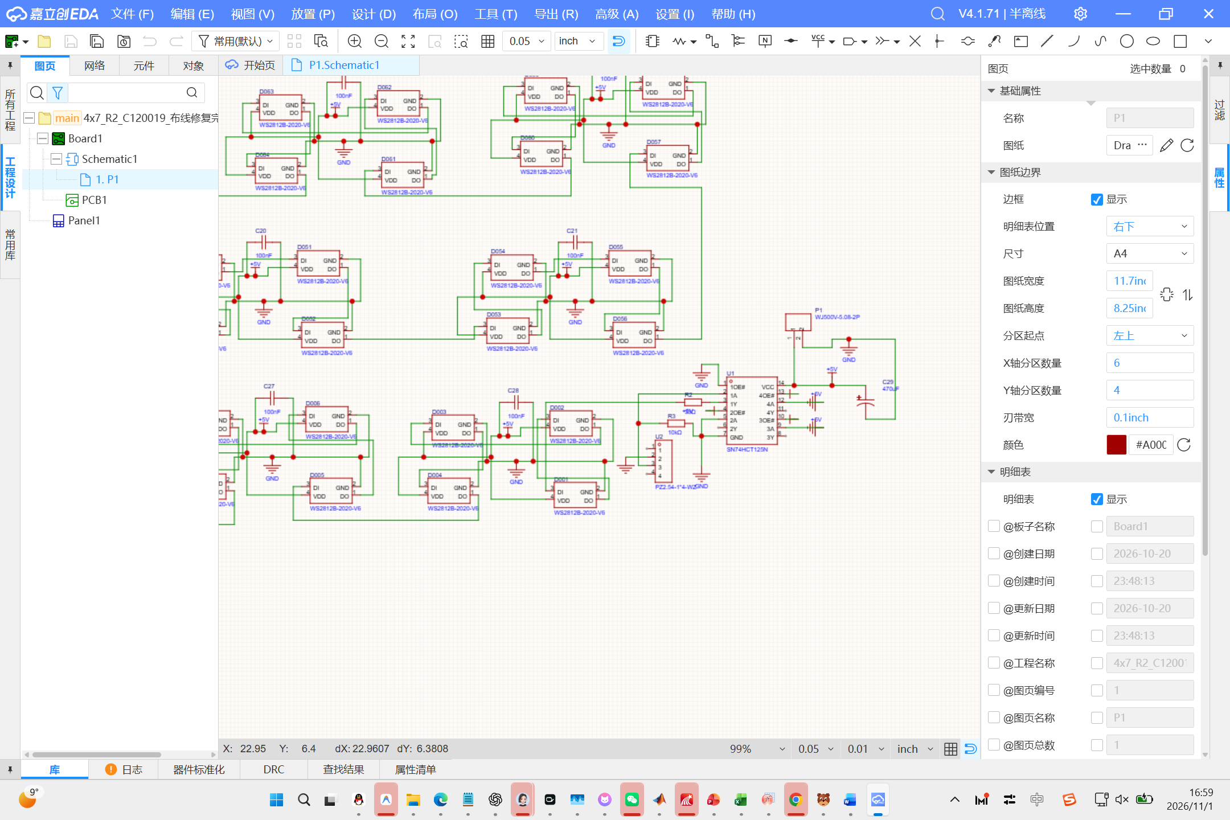
hardware/electronics/lighting/input-buffer.png
