xuanxly/fpga-piano-Chuyun/hardware/electronics/lighting/pcb.png

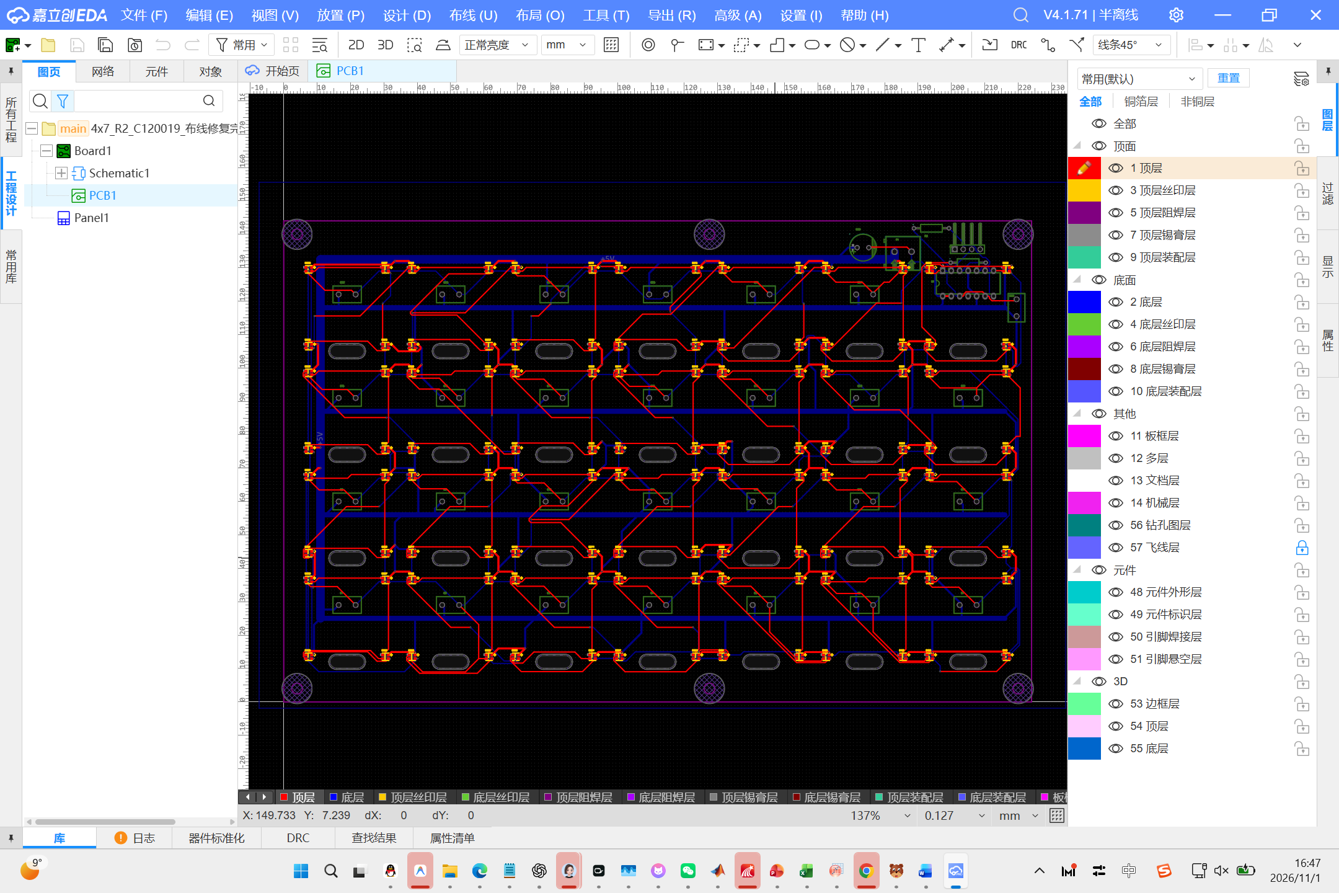
hardware/electronics/lighting/pcb.png
