xuanxly/fpga-piano-Chuyun/hardware/electronics/lighting/schematic.png

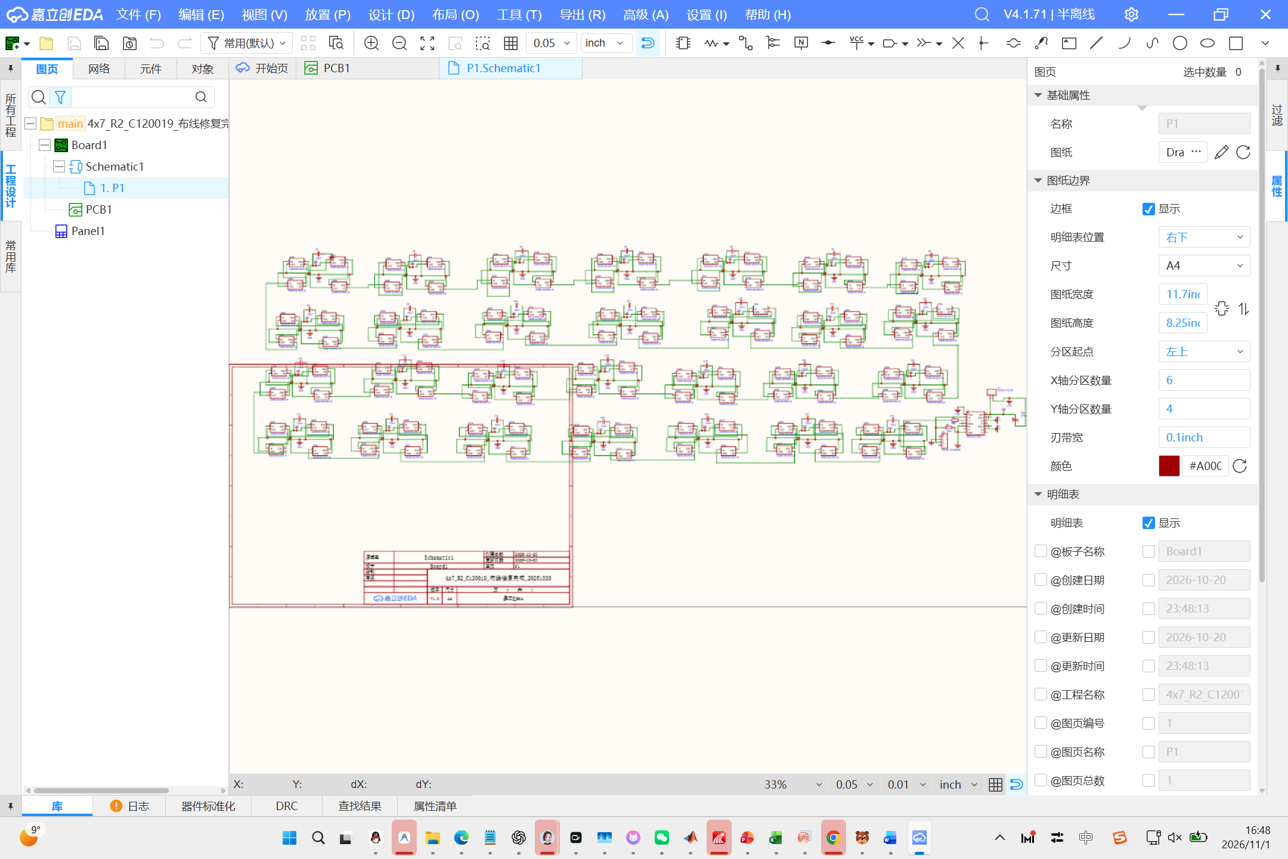
hardware/electronics/lighting/schematic.png
