xuanxly/fpga-piano-Chuyun/hardware/electronics/pressure/pcb.png

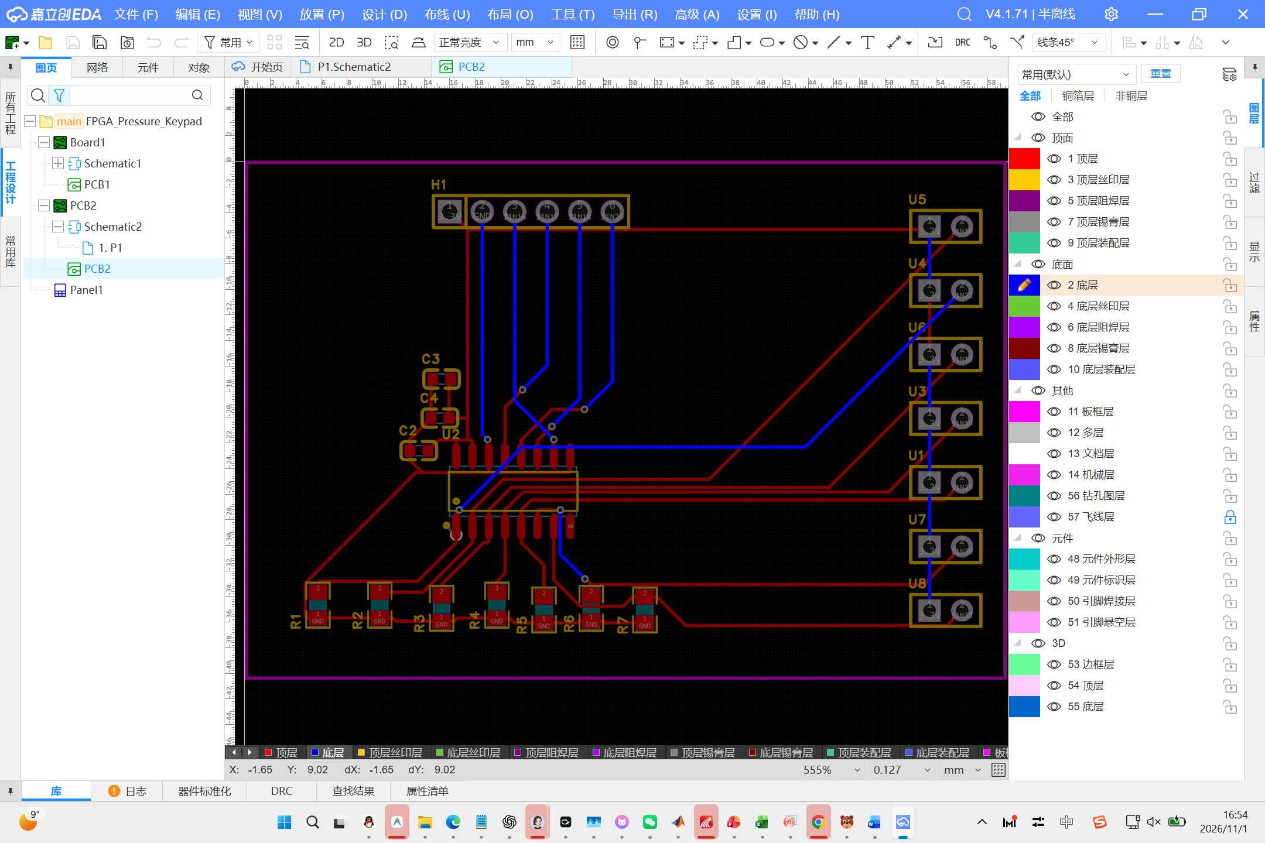
hardware/electronics/pressure/pcb.png
