xuanxly/fpga-piano-Chuyun/hardware/electronics/pressure/schematic-detail.png

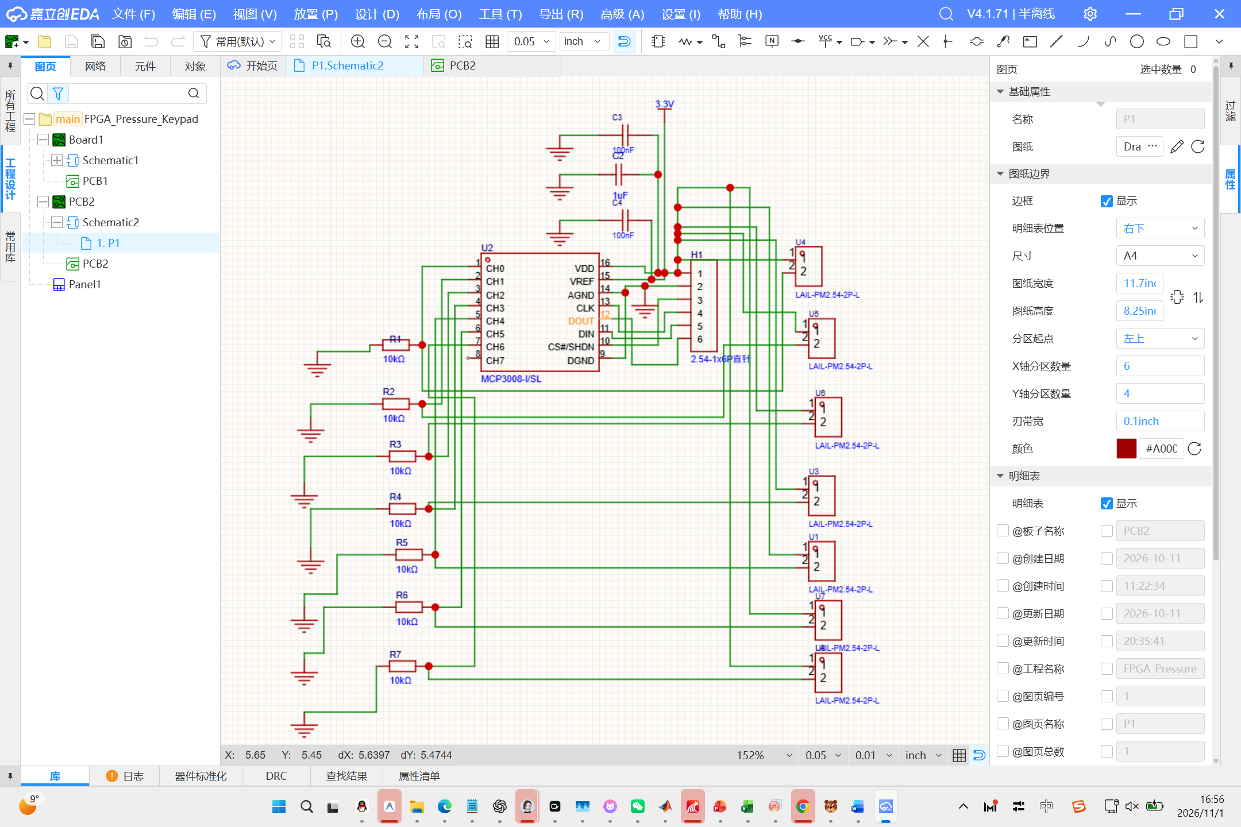
hardware/electronics/pressure/schematic-detail.png
