xuanxly/fpga-piano-Chuyun/hardware/electronics/pressure/schematic.png

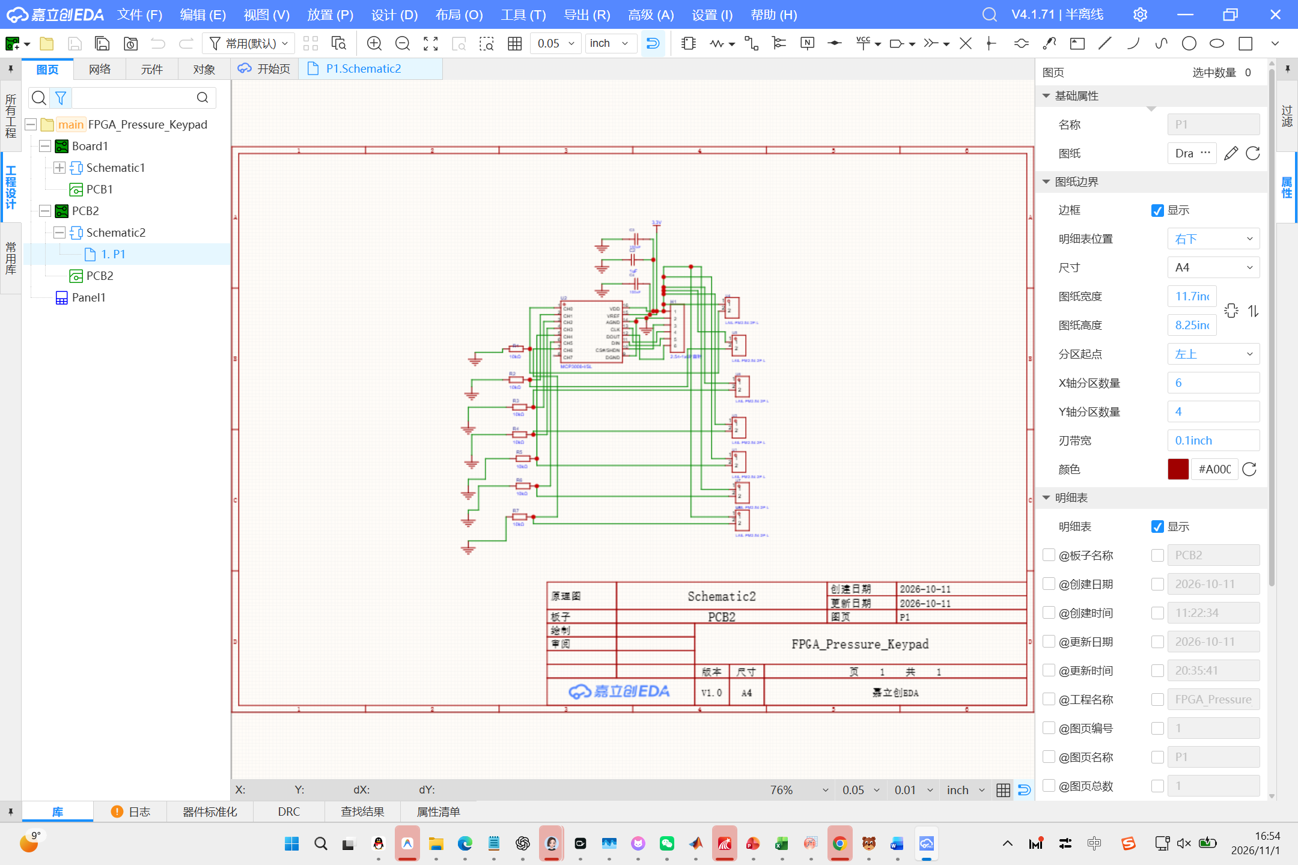
hardware/electronics/pressure/schematic.png
