xuanxly/fpga-piano-Chuyun/docs/parts-list.csv

类别 | 部件 | 数量 | 单位 | 规格或用途 | 备注
主控 | Tang Mega 60K + NEO DOCK | 1 | 套 | FPGA主控平台 | 外购
采集 | 七路压力采集PCB | 4 | 块 | 每板MCP3008使用7路，共28路 | 项目自制
控制 | Control PCB | 1 | 块 | 编码器、独立按键、11路指示灯 | 项目自制
灯光 | RGB灯板PCB | 1 | 块 | 4x7键位、一键四灯、112颗LED工程 | 项目自制
传感 | FSR压力垫 | 28 | 个 | 按采购型号与软尾开口适配 | 外购
按键 | 硅胶垫 | 28 | 片 | 直径25mm、厚约2mm | 外购
按键 | 固定定位座 | 28 | 件 | 29.8x29.8x4.4mm | 3D打印
按键 | 圆形传力托盘 | 28 | 件 | 直径25mm、总高约2.4mm | 3D打印
外壳 | 底板 | 1 | 片 | 244x224x5mm | 亚克力
外壳 | 前板 | 1 | 片 | 244x111x3mm | 亚克力
外壳 | 左侧板 | 1 | 片 | 221x111x3mm | 亚克力
外壳 | 右侧板 | 1 | 片 | 221x111x3mm | 亚克力
外壳 | 后板 | 1 | 片 | 244x116x3mm | 亚克力
层板 | 采集托板 | 1 | 片 | 232x214x5mm | 亚克力
层板 | 顶层承压板 | 1 | 片 | 232x215.5x5mm | 亚克力
导轨 | U形导轨 | 6 | 段 | 每段210mm，三层左右各一段 | 截面及配合按实物
显示 | 微雪5inch HDMI LCD(H) | 1 | 套 | 800x480、HDMI视频、USB Touch | 外购
连接 | 线束、接口线、电源、固定辅材 |  | 按实装 | 长度与数量按现物登记 | 本表为系统级清单，不是贴片BOM
