xuanxly/fpga-piano-Chuyun/docs/key-channel-map.csv

键位ID | 行_靠近演奏者为1 | 列_左到右1至7 | 采集板编号_待实装登记 | ADC通道_待实装登记 | FSR插座位号_待实装登记 | 备注 | FPGA共用CS球位_D12
1 | 1 | 1 |  |  |  | 按实际线束填写，不预设一行一板 | Y22
2 | 1 | 2 |  |  |  | 按实际线束填写，不预设一行一板 | Y22
3 | 1 | 3 |  |  |  | 按实际线束填写，不预设一行一板 | Y22
4 | 1 | 4 |  |  |  | 按实际线束填写，不预设一行一板 | Y22
5 | 1 | 5 |  |  |  | 按实际线束填写，不预设一行一板 | Y22
6 | 1 | 6 |  |  |  | 按实际线束填写，不预设一行一板 | Y22
7 | 1 | 7 |  |  |  | 按实际线束填写，不预设一行一板 | Y22
8 | 2 | 1 |  |  |  | 按实际线束填写，不预设一行一板 | Y22
9 | 2 | 2 |  |  |  | 按实际线束填写，不预设一行一板 | Y22
10 | 2 | 3 |  |  |  | 按实际线束填写，不预设一行一板 | Y22
11 | 2 | 4 |  |  |  | 按实际线束填写，不预设一行一板 | Y22
12 | 2 | 5 |  |  |  | 按实际线束填写，不预设一行一板 | Y22
13 | 2 | 6 |  |  |  | 按实际线束填写，不预设一行一板 | Y22
14 | 2 | 7 |  |  |  | 按实际线束填写，不预设一行一板 | Y22
15 | 3 | 1 |  |  |  | 按实际线束填写，不预设一行一板 | Y22
16 | 3 | 2 |  |  |  | 按实际线束填写，不预设一行一板 | Y22
17 | 3 | 3 |  |  |  | 按实际线束填写，不预设一行一板 | Y22
18 | 3 | 4 |  |  |  | 按实际线束填写，不预设一行一板 | Y22
19 | 3 | 5 |  |  |  | 按实际线束填写，不预设一行一板 | Y22
20 | 3 | 6 |  |  |  | 按实际线束填写，不预设一行一板 | Y22
21 | 3 | 7 |  |  |  | 按实际线束填写，不预设一行一板 | Y22
22 | 4 | 1 |  |  |  | 按实际线束填写，不预设一行一板 | Y22
23 | 4 | 2 |  |  |  | 按实际线束填写，不预设一行一板 | Y22
24 | 4 | 3 |  |  |  | 按实际线束填写，不预设一行一板 | Y22
25 | 4 | 4 |  |  |  | 按实际线束填写，不预设一行一板 | Y22
26 | 4 | 5 |  |  |  | 按实际线束填写，不预设一行一板 | Y22
27 | 4 | 6 |  |  |  | 按实际线束填写，不预设一行一板 | Y22
28 | 4 | 7 |  |  |  | 按实际线束填写，不预设一行一板 | Y22
