xuanxly/fpga-piano-Chuyun/fpga/d13/reports/xsim_d13_final_components/d13_page9.png

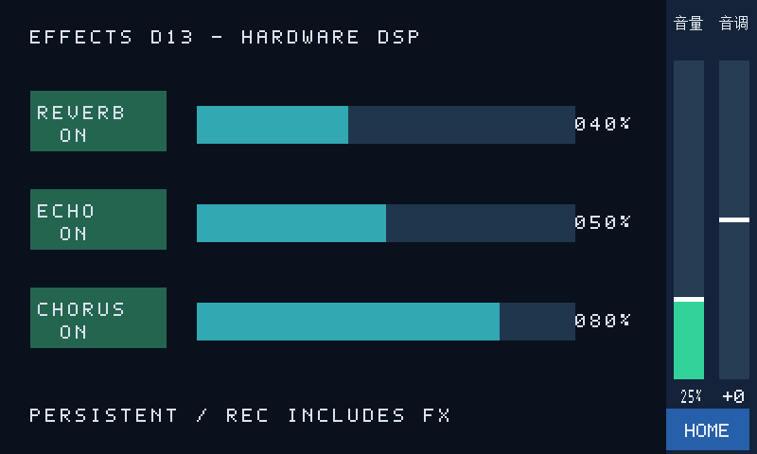
fpga/d13/reports/xsim_d13_final_components/d13_page9.png
