xuanxly/fpga-piano-Chuyun/hardware/mechanical/cad/base_244x224_t5.dxf

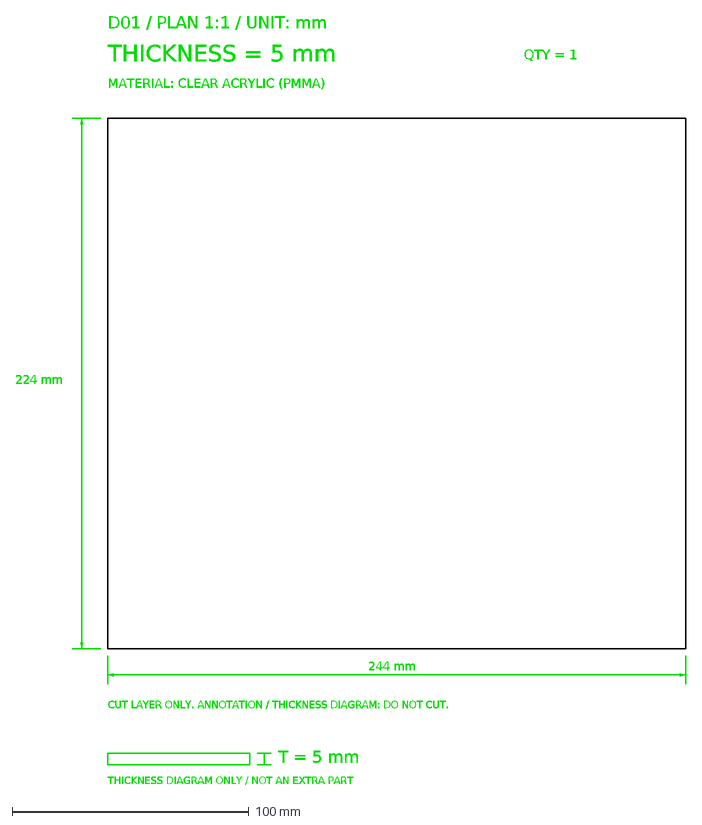
[picture p74: CAD file, 2026-11-02]
hardware/mechanical/cad/base_244x224_t5.dxf
D01 / PLAN 1:1 / UNIT: mm
THICKNESS = 5 mm
QTY = 1
MATERIAL: CLEAR ACRYLIC (PMMA)
CUT LAYER ONLY. ANNOTATION / THICKNESS DIAGRAM: DO NOT CUT.
244 mm
224 mm
THICKNESS DIAGRAM ONLY / NOT AN EXTRA PART
T = 5 mm
