xuanxly/fpga-piano-Chuyun/hardware/mechanical/stl/key_guide_29p8mm.stl

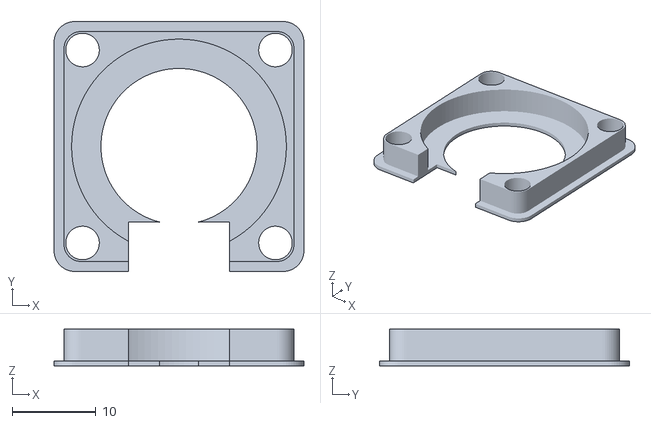
[picture p75: CAD file, 2026-11-02]
hardware/mechanical/stl/key_guide_29p8mm.stl
29.8 x 29.8 x 4.40
