xuanxly/fpga-piano-Chuyun/hardware/mechanical/cad/key_support_232x215p5_t5.dxf

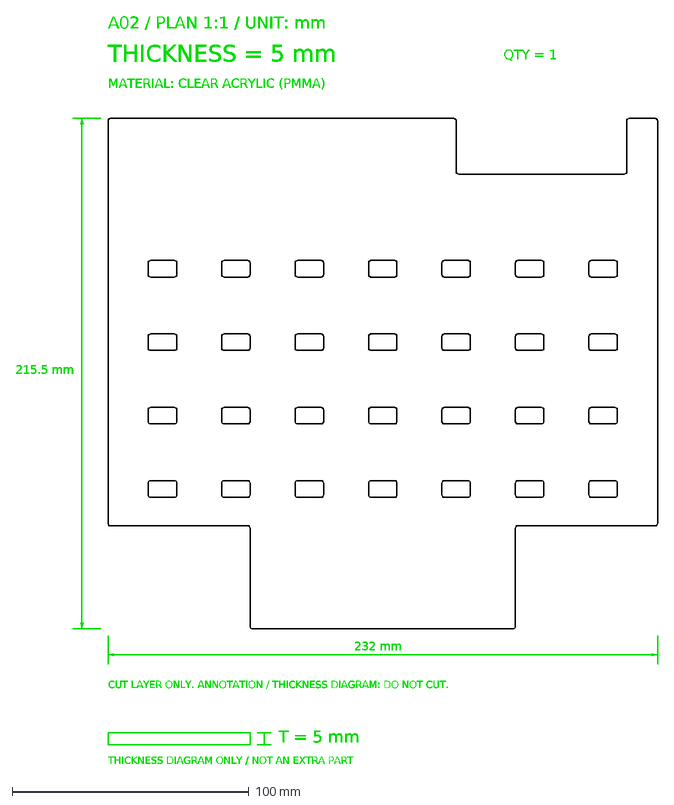
[picture p76: CAD file, 2026-11-02]
hardware/mechanical/cad/key_support_232x215p5_t5.dxf
A02 / PLAN 1:1 / UNIT: mm
THICKNESS = 5 mm
QTY = 1
MATERIAL: CLEAR ACRYLIC (PMMA)
CUT LAYER ONLY. ANNOTATION / THICKNESS DIAGRAM: DO NOT CUT.
232 mm
215.5 mm
THICKNESS DIAGRAM ONLY / NOT AN EXTRA PART
T = 5 mm
