xuanxly/fpga-piano-Chuyun/hardware/mechanical/stl/key_tray_25mm.stl

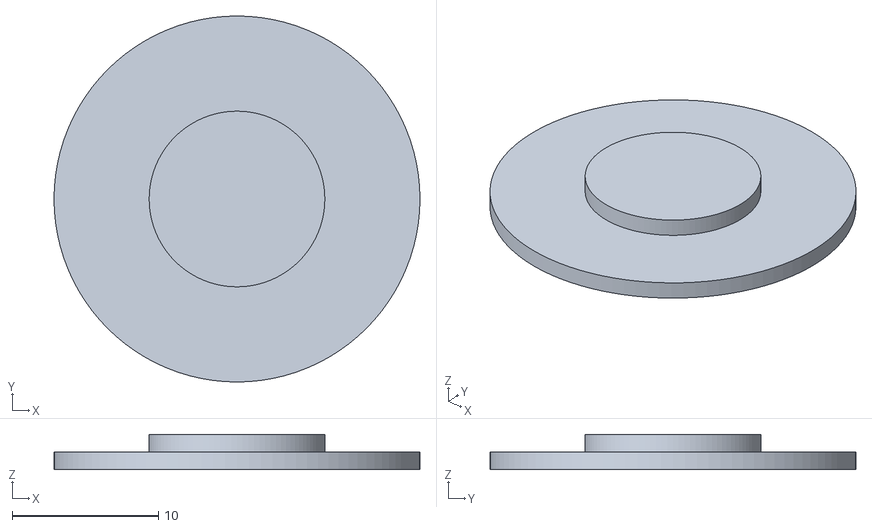
[picture p77: CAD file, 2026-11-02]
hardware/mechanical/stl/key_tray_25mm.stl
25.0 x 25.0 x 2.40
