xuanxly/fpga-piano-Chuyun/hardware/mechanical/cad/rear_244x116_t3.dxf

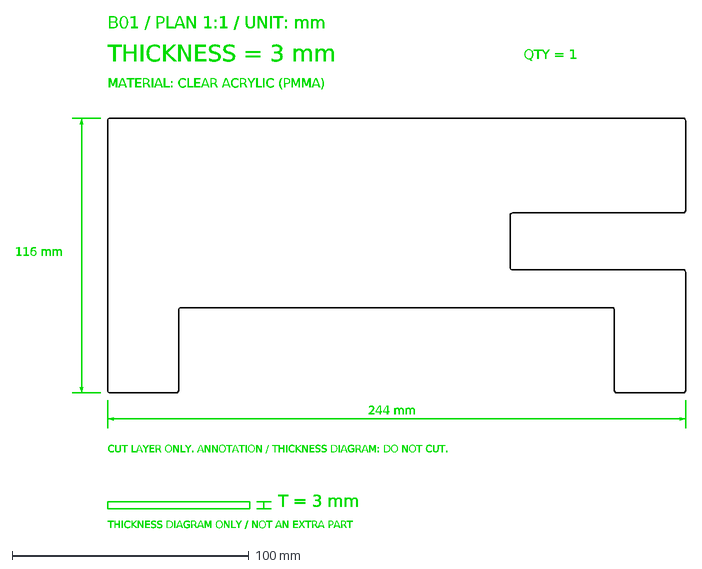
[picture p80: CAD file, 2026-11-02]
hardware/mechanical/cad/rear_244x116_t3.dxf
B01 / PLAN 1:1 / UNIT: mm
THICKNESS = 3 mm
QTY = 1
MATERIAL: CLEAR ACRYLIC (PMMA)
CUT LAYER ONLY. ANNOTATION / THICKNESS DIAGRAM: DO NOT CUT.
244 mm
116 mm
THICKNESS DIAGRAM ONLY / NOT AN EXTRA PART
T = 3 mm
