xuanxly/fpga-piano-Chuyun/hardware/mechanical/cad/side_left_221x111_t3.dxf

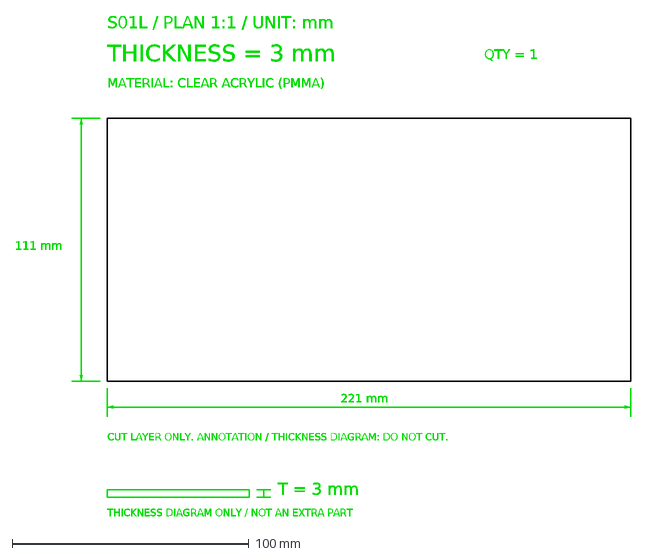
[picture p81: CAD file, 2026-11-02]
hardware/mechanical/cad/side_left_221x111_t3.dxf
S01L / PLAN 1:1 / UNIT: mm
THICKNESS = 3 mm
QTY = 1
MATERIAL: CLEAR ACRYLIC (PMMA)
CUT LAYER ONLY. ANNOTATION / THICKNESS DIAGRAM: DO NOT CUT.
221 mm
111 mm
THICKNESS DIAGRAM ONLY / NOT AN EXTRA PART
T = 3 mm
