xuanxly/fpga-piano-Chuyun/hardware/mechanical/cad/acquisition_tray_232x214_t5.dxf

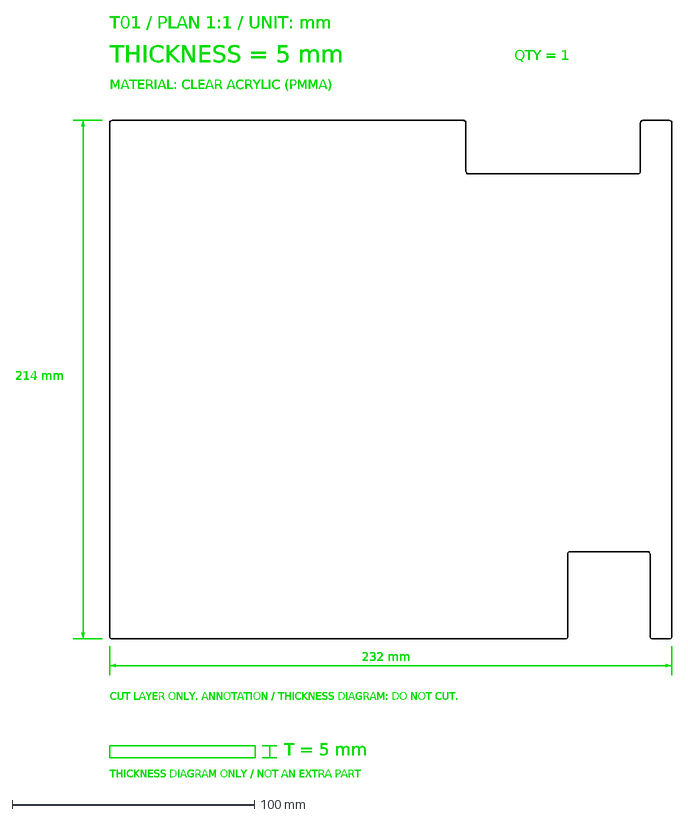
[picture p82: CAD file, 2026-11-02]
hardware/mechanical/cad/acquisition_tray_232x214_t5.dxf
T01 / PLAN 1:1 / UNIT: mm
THICKNESS = 5 mm
QTY = 1
MATERIAL: CLEAR ACRYLIC (PMMA)
CUT LAYER ONLY. ANNOTATION / THICKNESS DIAGRAM: DO NOT CUT.
232 mm
214 mm
THICKNESS DIAGRAM ONLY / NOT AN EXTRA PART
T = 5 mm
