xuanxly/fpga-piano-Chuyun/(list of files, cad)

Other CAD files:
hardware/mechanical/blender/assembly.blend
hardware/mechanical/blender/single-key.blend
