xuanxly/fpga-piano-Chuyun/fpga/d13/docs/D13_VALIDATION_INDEX.md

# D13 数字验证索引

这些检查用于证明代码行为及实现结果，不代替D13实板验收。最终汇总由`tools/audit_d13.py`生成`reports/d13_verification.json`；该审计未通过时不得发布中途位流。

## RTL：34项自检

|报告目录（reports下）|数量|覆盖|
|---|---:|---|
|xsim_d13_final_components|8|三种效果与叠加、ROM两种推断方式14336次等价读、32测试音、八应用触控、硬件计数、三页像素/同步、旧界面16001随机帧等价及原UI|
|xsim_d13_final_usb|11|同ScanTime、半帧保持、空DATA toggle、7302条真实历史报告、USB引脚模型、PID/端点拒绝、五指/音频、USB停钟高阻保护、CH569链路、灯光帧|
|xsim_d13_game_cache_final|6|游戏判定器214405周期对照、缓存逐拍一致性、22种游戏场景、五分钟边界、真实CPU游戏装载、1220次Wishbone、导引灯|
|xsim_d13_cached_system|8|媒体PCM/CPU启动、音色/力度、完整音频链录音/I2S、四ADC模型28键隔离及旧音色整机|
|xsim_d13_cdc_final|1|触控邮箱在异步时钟下134份原子快照、最新帧及断开递送|

每项以对应`tb_*.run.log`中的PASS为准，是否全部完成由最终审计确认。开发中发现过旧testbench仍以3bit连接新4bit页面，以及测试起始时按键未释放导致音色安全静音；这些是测试夹具问题，已修正后运行真实产品路径，没有删除产品保护。效果器为节省RAM从16改为26个系统周期，组件期限据此改为32周期，完整48kHz音频帧期限保持；独立采样模型的数学运算与所有延迟长度均未改。

第一轮默认路由曾因7298条未布通失败（Logic46519、BSRAM112/118），记录在`reports/pnr_attempts/route0_pr0004_7298/`。随后改效果器为15个共享端口RAM银行、固件ROM改全BSRAM，以减少高扇出LUT及RAM读端口复制；第二轮Place3/Route2保存后中止，第三轮关闭工具的宽RAM拆分映射。所有最终资源/时序均以最终审计为准，旧轮失败或中止不能当作通过；详细过程见`D13_IMPLEMENTATION_NOTES.md`。

## 独立参考和真实C服务

- `d13_audio_reference.json`：91300个效果输出与独立采样域模型逐值相等；实际测试音RTL输出4096点，32个预期频率由DFT独立核对。效果器最初的合唱RAM读延迟错误由此发现并修正。
- `host_media/test_0.log`、`test_1.log`：实际媒体C/FatFs服务连接模拟128GB FAT32/exFAT，各14455487项检查，覆盖五分钟录音、WAV回读/重采样、CSV与磁盘所有权/异常；EFFECTS保留录音，VERIFY进入时保存录音。没有操作真实卡。
- `tools/build_media_firmware.py --verify`：重新编译目标固件，并逐字节比较产品ROM，防止C源码和位流中的程序分离。
- `d13_toggle_before.log`、`d13_touch_before.log`：修复前USB空DATA与同时间戳拖动的可复现失败，不作为通过记录。修复前源码保留在`touch_before_sources/`。

## 最终物理实现审计

`tools/run_implementation.ps1`必须确认本次Tcl完整返回、新位流生成、Setup/Hold零违例及构建输入哈希未变。`audit_d13.py`还检查：

1. Setup、Hold、Recovery、Removal最小余量均非负，保留0.300ns额外建立预算。
2. D12的97项原始产品输入未改；D13实际构建输入与最终文件匹配。
3. 原58球位及整份启动配置保持，全部322封装行只允许新增E14/E13/C15三行变化，61个实际信号球位唯一。
4. USB两路IOBUF、CH569四路TBUF仍由直接INIT=1寄存器控制高阻使能，不能仅凭RTL复位代码推断上电状态。
5. 最终资源和User Code直接读取实际PnR及FS文件，发布包逐项读回核对，不沿用D12数字。

## 建议的首次实板验收顺序

1. 保留925A可回退文件，使用SRAM方式下载最终D13并核对User Code，观察POWER和HDMI持续正常。
2. 启用USB触摸；重复点击、长按、拖动、五指、松手，并观察VERIFY的USB ERR/SKIP及顶部诊断。若再次整段失灵，记录出问题前后计数，暂不把仿真修复当作根因已彻底排除。
3. 进入EFFECTS，逐个开启三种效果并调节，退出确认持续；回到录音确认保存带效果且监听音量不影响文件，文件播放保持原声。
4. 进入VERIFY默认静音，先选1声部低监听音量，再切4/8/16/28/32；观察实际采样计数、计算周期及错误标志。退出验证页应停止测试音。
5. 条件具备时接逻辑分析仪检查标准I2S，再用模拟输出做外部多频FFT和端到端延迟测量。先核对J13的1脚方向，不将数字引脚接无源扬声器。

本次未操作Programmer、FPGA Flash或CH569固件。所有“真实报告”指此前采集并保存的触控数据；“ADC模型/卡模型”不表示当前真实外设测试。
