xuanxly/fpga-piano-Chuyun/fpga/d13/reports/xsim_d13_final_components/validation32_pcm.txt

149
311
137
-15
165
310
117
-14
178
301
101
-15
192
298
83
-12
203
287
58
-15
217
280
36
-14
225
265
16
-15
231
250
-12
-8
240
227
-35
-15
245
208
-63
-14
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
