xuanxly/fpga-piano-Chuyun/verification/manifest.csv

file | source | bytes | sha256
.gitattributes | Project documentation, diagrams, renders, or verification index | 445 | 546ddb524028d8d65f745306337358571f022ffd1bee14b142292a64a46a633b
.gitignore | Project documentation, diagrams, renders, or verification index | 444 | 9452a98f10ae34096d66197acaf386f8edb2f99699d62c112a0fa05b538e54dc
README.md | Project documentation, diagrams, renders, or verification index | 5526 | a5735f991fe19fe4510a46bdef3af6461f6b522b9b5850f9ab578fd36d89dcee
assets/cover.png | Project documentation, diagrams, renders, or verification index | 2356656 | 3adcb40c853daf4eb9541902f4de17c436c2719556b7e6e645bec09ec562295c
assets/photos/control-board.jpg | Project prototype photographs | 1019618 | 656969690b1f5bb037600b038bf7ff65b81f02d86ef1ecd553b1116dc8501cd3
assets/photos/fpga-back.jpg | Project prototype photographs | 4993047 | 4bbab5d6ec912a473d8921258c90e260325c121d78375dbe398cfe45bddbee82
assets/photos/fpga-front.jpg | Project prototype photographs | 4770476 | 135e1e2844628e370c6f2fc4e23e375c0194f84eb7c96288551a148bde48bc6b
assets/photos/fpga-wiring.jpg | Project prototype photographs | 3062377 | 483c339cb53e2f6d149c0661097af630dacd9e9085b17353fee5943130044e1a
assets/photos/key-parts.jpg | Project prototype photographs | 5338326 | f2ef95237a588cdd5e6e2ed050dc94d70d562b4040a60efb531ede4dc3d0b84c
assets/photos/key-underside.jpg | Project prototype photographs | 3946165 | 19a187a9a04245d9db026756ac09fa338f8eab5528babcca439331fd70c63259
assets/photos/pressure-board.jpg | Project prototype photographs | 2190859 | 0ff0f38cabc078a99cab480d7b61f03a8977e0809dbb5ee42cef9adba250cc72
assets/photos/screen-back.jpg | Project prototype photographs | 6430692 | 84388e221087a6d39f05c49717738c0b09e76fcbbfd71a6ff912578d502111f1
assets/photos/screen-front.jpg | Project prototype photographs | 6051383 | 8f7775815ade40539421777b5424e9ef8daa0586be570d783156af1bc1285b7b
assets/photos/software/effects.jpg | Project prototype photographs | 588668 | dcb4049c2951ed29b66cbdf88aa92e6d30bbf8a2df06713436417cf7becb6348
assets/photos/software/files.png | Project prototype photographs | 1676646 | 3b79242e46cbdfac4d5dd9f9731848597fcc72dea80b5a5c6d48701529cc568e
assets/photos/software/game.jpg | Project prototype photographs | 295653 | 21cd6c1b88b49280d73893adda919dcf2f1542e4d2b1c7598edfce58b674c2d0
assets/photos/software/home.png | Project prototype photographs | 6279036 | ded3949909abc2b933abce8bd615871bc204da9017d48432bb7d18312130cee5
assets/photos/software/recorder.png | Project prototype photographs | 2084449 | 7e31b56761d95ea33cc20a84db6a737fa089c52d09e63119e8de54a214ba2330
assets/photos/software/spectrum.png | Project prototype photographs | 2714233 | 4b4cad92e9a4eb26f141f715aeb900b9742cd14b3b1d99566baf0173ff469ed5
assets/photos/software/timbre.jpg | Project prototype photographs | 201588 | b303fdb602816915eee378df3de731e3ea04f46569814f395985a3f3facc1d54
assets/photos/software/verify.jpg | Project prototype photographs | 698953 | 58a13d1130329780fbf202ac001f81aac509203fbbdf1cd36f63d4a0a2a1d330
assets/photos/whole-angle.jpg | Project prototype photograph | 405415 | 6769043f5033288044c0844ad036973f5c2afb4b9e06c58ee97ad8476df3a569
assets/photos/whole-front.jpg | Project prototype photographs | 520163 | 3e6b0c3167eabc71059ccf82725191cd10aa106b3af4e45f62083eb85a11a2e4
assets/photos/whole-inside.jpg | Project prototype photographs | 536386 | b0bd8cadec79c547a63a8c5aea2134fe5eadcf3243a4174ea96e2f5d6eccb8a3
assets/renders/assembled-cutaway.png | Project documentation, diagrams, renders, or verification index | 2262694 | cc644227bb71702526e3beb10fe7d87ccd19c58eee84000444eaf7ee424895a6
assets/renders/internal-plates-cad.png | Project documentation, diagrams, renders, or verification index | 43748 | 04895849b324855e6cfa73b0d28b413c798174b30cf91abeb7de6bb3c10fdb2c
assets/renders/key-exploded.png | Project documentation, diagrams, renders, or verification index | 1738899 | cedbb04edb0fe4b05201f50251b830d47615a0a8e97c38ea7f98b214f175ce92
assets/renders/layered-assembly.png | Project documentation, diagrams, renders, or verification index | 1939586 | 385e5a93b5d8a54718e1721ac941aea54faf70c4c1d86436d23c85052a44f88a
docs/assembly.md | Project documentation, diagrams, renders, or verification index | 4348 | 25e4c6f610cc8dadd965f64dbc42e8ade90ffe67aa586ff3ca8da9928c02344b
docs/design-status.md | Project documentation, diagrams, renders, or verification index | 2591 | 8ebe7b484e60f6ab3ea25de941694c0cc4a272f7637aded1d1d61b8b6c9eba20
docs/figures/01-system-overview.png | Project documentation, diagrams, renders, or verification index | 249388 | 95f8575e2e2c5420194db065412ee38dbf0fe9e1743df69e14e438d6bbacdd64
docs/figures/01-system-overview.svg | Project documentation, diagrams, renders, or verification index | 10048 | 3fe63d9d6261b64290ee38dee35a62921e5eebec613fae47fa810ba2d7857622
docs/figures/02-pressure-board.png | Project documentation, diagrams, renders, or verification index | 2761091 | 2349515f4d8841e1cae9fc9ec8a62bb2a11a30569fb86a26f127cc0f8ac4e2d7
docs/figures/02-pressure-board.svg | Project documentation, diagrams, renders, or verification index | 500647 | 98252a383625d05f70002f48c4ee1b8c2f54bb530427e7a3e8f2ee49b3d958e7
docs/figures/03-pressure-spi.png | Project documentation, diagrams, renders, or verification index | 989317 | 0f5aebc8a3f61015c4dd5c00e1d01919030edcf684fd9db7434802905b7ed619
docs/figures/03-pressure-spi.svg | Project documentation, diagrams, renders, or verification index | 686474 | 3d4b1d5b56559231b07582537d7525c58a0a58d4d31683edd82a1faad8404089
docs/figures/04-control-layout.png | Project documentation, diagrams, renders, or verification index | 4293930 | fed170d8460915fdcd16affd7e1210b12a284cbf6d44afaa5e4e5e064917e297
docs/figures/04-control-layout.svg | Project documentation, diagrams, renders, or verification index | 625661 | 01baa6e6f68fe0e7cdbce2df1e76171d3ea98998ceb048c7cad9fe793e428f16
docs/figures/05-control-pinout.png | Project documentation, diagrams, renders, or verification index | 1063130 | 8cd5d96f306bd59944e05e79ace165661eee9995521ead1a4af44d88062c9b42
docs/figures/05-control-pinout.svg | Project documentation, diagrams, renders, or verification index | 796327 | 4d4acf31a52678fbbb903b32bf05f8ce3b0aa9e55e3e02a8c391bdd5a54e0e30
docs/figures/06-lighting-layout.png | Project documentation, diagrams, renders, or verification index | 4210200 | f4cc63703aa0d6e610bfca52cfebc8970b14ba96ec7966c970f95c7a31f82ff3
docs/figures/06-lighting-layout.svg | Project documentation, diagrams, renders, or verification index | 713338 | 397d492f165f8bbce2f17ccd8a15d4ecdb031ad90f02d22ee87531d6e64f554b
docs/figures/07-lighting-input.png | Project documentation, diagrams, renders, or verification index | 1092125 | fbd6ebee10027769946cd371609f261073f5ecfbfb06cf59c31ce59a34cf5919
docs/figures/07-lighting-input.svg | Project documentation, diagrams, renders, or verification index | 838840 | 49c3c3d76c761f8fe808879a3ffaa8d2aaa7dbbb665d7cf5e73954280e5cd171
docs/figures/08-wiring.png | Project documentation, diagrams, renders, or verification index | 2161856 | 6b3bb1e32857131a876d558afdf6a2da4240b471bdcb4f9ea0cf161069747530
docs/figures/08-wiring.svg | Project documentation, diagrams, renders, or verification index | 98293 | 42b1650b0bd2a744781544b79fc8381b01b341f548d6dd9e8c3994eb877e21b4
docs/figures/09-peripherals.png | Project documentation, diagrams, renders, or verification index | 3067536 | 9918eb220f113ae0edfb6945bee5d50c089571fd6d1f76cf96257d6be81a0065
docs/figures/09-peripherals.svg | Project documentation, diagrams, renders, or verification index | 83272 | d53509017bdc1b7ab514a76f4815a1efc7cc189d558ba3bb51a93a5762d0fdff
docs/figures/media-function-flows.png | Project software flow diagram | 527533 | 61a8e83d3db54b5f082caca6307625e4dbe7ed3805aba93868e148692da53475
docs/figures/media-function-flows.svg | Project software flow diagram | 9178 | 7692f54445402bf04c214752f0c881127ae6caece5a59122d117cb3dcf56b41f
docs/figures/realtime-signal-flow.png | Project software flow diagram | 439235 | 718bf6ff6289547002e8d41dd6115935493f81925d235c8a76d71ba61ff3c276
docs/figures/realtime-signal-flow.svg | Project software flow diagram | 6471 | 75dacb91c3f34d226a5ab5329a86b076eea0c8bfb8074ed5c7d2ccdc676a87fc
docs/figures/software-main-flow.png | Project software flow diagram | 283307 | e8ba28097d7e65719eb7fd569f3149bfab9b7895f9d045ed754997a349d4921a
docs/figures/software-main-flow.svg | Project software flow diagram | 4227 | 7ad5d3d9ab2b6a05f288b29cb6b638d2abd774015a58e254cf4d7a6932d03b64
docs/hardware.md | Project documentation, diagrams, renders, or verification index | 3237 | 4803a665346bc5e8e97b09c31cbe12167e0bf964baa0c42130cc2f1f0fa72365
docs/key-channel-map.csv | Project documentation, diagrams, renders, or verification index | 1875 | 66872ee4db5cfdca5aed2d4f7a4f4e1be07ac4b9a9a0ebe7678bebf9f0a790b1
docs/parts-list.csv | Project documentation, diagrams, renders, or verification index | 1222 | d30cdc4e72813ff65ff4dcbeb4acb3c5bde34652f39bebcb896c9fc38bbd8423
docs/references.md | Project documentation, diagrams, renders, or verification index | 809 | 2e77763bc48173ae7bcf9415455bc60c8cf0bed6e37e482b445d162bd3b5a015
docs/software.md | Project documentation, diagrams, renders, or verification index | 3538 | 81a8e6a21446efb0a8c116a8fa3579e0344a6fb06a3f20f9dca3f64e6f851a2b
docs/technical-report.docx | R10 technical report, 40 pages | 36874126 | 3ae68137e0356a0bbc92eafbb047d4b07a33173b47107a3c9b20e9c7aecd4482
docs/wiring.md | Project documentation, diagrams, renders, or verification index | 4533 | 5dd08d022c77769cbcd5d21ed3e63ba8b1054342e271b091975c3478e5bbd928
fpga/README.md | Project documentation, diagrams, renders, or verification index | 2242 | 4cb207c913b4bb27e76da8b8208702e64ece90e3e97adfebce8d09c6cf4055a1
fpga/d12/README_请先看.md | D12 historical release archive | 4233 | cab27abb93afdfbfa58e4de08a11a4d1e0a932c4d9bd24d042077a39987cf023
fpga/d12/SHA256SUMS.txt | D12 historical release archive | 75606 | 3ff82e2a126061c727acbaf8070f4c227168cd849f416fe16ff49fef7d2cefd1
fpga/d12/constraints/pressure_piano.cst | D12 historical release archive | 5092 | f60b6f13f9d4f29993d240db2ea9fad21df84c416155f7166b4b0a2a6aa2ff00
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
fpga/d12/third_party/ch569/EVT/EXAM/SRC/Peripheral/inc/CH56x_timer.h | D12 historical release archive | 6790 | 3f9fd4f19e5fe949e0669dcb633664e5864cb67900b2eb30b4773c0ae1a0b171
fpga/d12/third_party/ch569/EVT/EXAM/SRC/Peripheral/inc/CH56x_uart.h | D12 historical release archive | 7106 | 082519ef221feb152fdb58e38b395485f2618089149381ffc624a80246b42fc3
fpga/d12/third_party/ch569/EVT/EXAM/SRC/Peripheral/src/CH56x_bus8.c | D12 historical release archive | 1506 | 462d0e8de449b4865976fbd389fb3b85460860c6115c668b4f7402680701128c
fpga/d12/third_party/ch569/EVT/EXAM/SRC/Peripheral/src/CH56x_clk.c | D12 historical release archive | 3043 | ccc6c5cb55e34707fbe005dd2aed8f6a1a7ae9ceca3ad08edb1b93666f7ac6c8
fpga/d12/third_party/ch569/EVT/EXAM/SRC/Peripheral/src/CH56x_dvp.c | D12 historical release archive | 3424 | d108c902d72eb8970a6754edd2e7ce7347ac0922166007be1739f3aa569692fe
fpga/d12/third_party/ch569/EVT/EXAM/SRC/Peripheral/src/CH56x_ecdc.c | D12 historical release archive | 5431 | 711a2358d4c92b5b04eb7c7bfb152674216b98a8ecf7c1df5efdef3a733a1b29
fpga/d12/third_party/ch569/EVT/EXAM/SRC/Peripheral/src/CH56x_emmc.c | D12 historical release archive | 23863 | 63c78d3c530e3972f905221c73cf00ff18dd4874a931d3499ab3b5a2ee11c289
fpga/d12/third_party/ch569/EVT/EXAM/SRC/Peripheral/src/CH56x_eth.c | D12 historical release archive | 11855 | fed77ec9415ad8778aec3eb75292ee63b7098af1e1c5d36ca6390fc036bd1ad1
fpga/d12/third_party/ch569/EVT/EXAM/SRC/Peripheral/src/CH56x_gpio.c | D12 historical release archive | 15864 | 942bbbd9e00c891a8d24980ae83b879f7b01c65911e1ab3b2181ac10d37f7dad
fpga/d12/third_party/ch569/EVT/EXAM/SRC/Peripheral/src/CH56x_hspi.c | D12 historical release archive | 2073 | a602aa0bb71e91cd50412ff6033b115005c73ee99a9e90aa5614e4516062a92c
fpga/d12/third_party/ch569/EVT/EXAM/SRC/Peripheral/src/CH56x_pwm.c | D12 historical release archive | 2187 | 9e81ba2075596745c9c570e5663ab0959cb3b6e32df5a0b5e7298ca837ab2ced
fpga/d12/third_party/ch569/EVT/EXAM/SRC/Peripheral/src/CH56x_pwr.c | D12 historical release archive | 3873 | 492feee4a24d33f9e73de916cf9e2e21641d80e90ee0ec32c378a7e97436ddba
fpga/d12/third_party/ch569/EVT/EXAM/SRC/Peripheral/src/CH56x_spi.c | D12 historical release archive | 17747 | 9852d750a8871d69e6fa7f008178811c0ea80ee42d6271f6a6927e4d78840b8b
fpga/d12/third_party/ch569/EVT/EXAM/SRC/Peripheral/src/CH56x_sys.c | D12 historical release archive | 5240 | 0c2a16609eef50f247cb652d4be002ace2ba8184735fc600cde6f7a9981485e9
fpga/d12/third_party/ch569/EVT/EXAM/SRC/Peripheral/src/CH56x_timer.c | D12 historical release archive | 6847 | 7f49fa51199928939e2e86bc1857fe65cd85c206f2446d0641118dce2a062638
fpga/d12/third_party/ch569/EVT/EXAM/SRC/Peripheral/src/CH56x_uart.c | D12 historical release archive | 13747 | daf1c7bc46da74b7e88bd718388eaadfe28d81e33442e78e0397cb80b7303a12
fpga/d12/third_party/ch569/EVT/EXAM/SRC/RVMSIS/core_riscv.c | D12 historical release archive | 8227 | 27ee847e65f27cc2d10504aa061a3705c189354a2952649d078abffc4aa20236
fpga/d12/third_party/ch569/EVT/EXAM/SRC/RVMSIS/core_riscv.h | D12 historical release archive | 17043 | c4c6b1e75321e0842577f4ac92f1bf3ef530ff021546790858114dea67c26487
fpga/d12/third_party/ch569/EVT/EXAM/SRC/Startup/startup_CH56x.S | D12 historical release archive | 4404 | 9e705dcf06cc51a85e308f8397a6cdc9b1d64bef22918c4c1dc336683e3281b2
fpga/d12/third_party/ch569/EVT/EXAM/USBSS/USBD/MSC_U-Disk/.cproject | D12 historical release archive | 33746 | ab2b6a8fecf77250e285e520df6e8d1b41849c7fdf0f05848e4d15a3f9665e43
fpga/d12/third_party/ch569/EVT/EXAM/USBSS/USBD/MSC_U-Disk/.ld | D12 historical release archive | 3771 | bf256ff00504b63a20aa46ccf619cc62ba4fc22cf71077595eef6662118ddad7
fpga/d12/third_party/ch569/EVT/EXAM/USBSS/USBD/MSC_U-Disk/.project | D12 historical release archive | 1677 | ca7239d548cd8311cd1bc8166f70e5e5f068121f50aa7890e1f6711148a3ebe5
fpga/d12/third_party/ch569/EVT/EXAM/USBSS/USBD/MSC_U-Disk/.template | D12 historical release archive | 917 | ef306df7c125c1cf811166ca57154ddb5d2b23a7dca3df803765c4647c2b32b7
fpga/d12/third_party/ch569/EVT/EXAM/USBSS/USBD/MSC_U-Disk/MSC_U-Disk.wvproj | D12 historical release archive | 202 | 474400f56cabf2d81e7a48e9c74464f2cb27954c436c1479356a262f5a8ccd2d
fpga/d12/third_party/ch569/EVT/EXAM/USBSS/USBD/MSC_U-Disk/User/Main.c | D12 historical release archive | 2980 | c20f61c3a031aee88cd64e23be1c2d5063754980915289da82eff9eccac2dc6f
fpga/d12/third_party/ch569/EVT/EXAM/USBSS/USBD/MSC_U-Disk/User/SW_UDISK.c | D12 historical release archive | 43262 | 2f98639f52bf424da28c6d295388058d311e2613d1f144dbdb817f98ca2dd657
fpga/d12/third_party/ch569/EVT/EXAM/USBSS/USBD/MSC_U-Disk/User/SW_UDISK.h | D12 historical release archive | 5465 | 3d28c7cea9c3c0ba665d32ef7e53ddf164bf2c60cede07cdbac06dc8ec68e518
fpga/d12/third_party/ch569/EVT/EXAM/USBSS/USBD/MSC_U-Disk/User/USB20/CH56x_usb20.c | D12 historical release archive | 21759 | f3dc363836487b5a266c5ca7906f5f6add5dd85ad87b2e4776b26b9d85e5cc6d
fpga/d12/third_party/ch569/EVT/EXAM/USBSS/USBD/MSC_U-Disk/User/USB20/CH56x_usb20.h | D12 historical release archive | 1445 | 5df7aeea27063aa8243d232c7c0b45869f645388892154096f7330aa3b02127e
fpga/d12/third_party/ch569/EVT/EXAM/USBSS/USBD/MSC_U-Disk/User/USB30/CH56x_usb30.c | D12 historical release archive | 29766 | ad7b680c53f73f961c8214853bc64b3eef903792d4d6297a8f7630de3e37481b
fpga/d12/third_party/ch569/EVT/EXAM/USBSS/USBD/MSC_U-Disk/User/USB30/CH56x_usb30.h | D12 historical release archive | 2692 | bca56a924803c11ca818f25a33b39a1f6f196da0419c7d2d98188807181f7336
fpga/d12/third_party/ch569/EVT/EXAM/USBSS/USBD/MSC_U-Disk/User/USB30/CH56xusb30_LIB.h | D12 historical release archive | 14215 | b25afceddae0557963d25a56d498235f43c09bd66526fe69ccddbe1845d5aa96
fpga/d12/third_party/ch569/EVT/EXAM/USBSS/USBD/MSC_U-Disk/User/USB30/libCH56x_USB30_device_lib.a | D12 historical release archive | 44868 | df585627c3f5a81cd9dc5034f09792495f5c1fb3e1077c891e3170b7cb2d2b1b
fpga/d12/third_party/ch569/PROVENANCE.json | D12 historical release archive | 6194 | f4b1a430042b9e28cc093cfb5999e56f2416a66e9caf2341239bd9523621e590
fpga/d12/third_party/ch569/README.md | D12 historical release archive | 3102 | 38ff0790ccdfa840bd45d54c3f3b44984ab537dfb59cf944a72dd8f07001465f
fpga/d12/third_party/ch569/README_zh.md | D12 historical release archive | 2619 | 40e94aaa3bfcac6cbd0a8ed022bd17b46f169c7e133c8e61853fac119cd67491
fpga/d12/third_party/fatfs/00readme.txt | D12 historical release archive | 861 | f8e4cd3036f8ac35956dd8d105a519a388306b9190e121bb936b1599c6bda564
fpga/d12/third_party/fatfs/diskio.h | D12 historical release archive | 2733 | 1c2b29f53e061c55d43b2e412c3a61320b2621bac7561a05e275514baa44785a
fpga/d12/third_party/fatfs/ff.c | D12 historical release archive | 266710 | dbeae3d7d22dbc070983e31af897fa5e43d29c726a0a240fe9589ffe2ec0ef1e
fpga/d12/third_party/fatfs/ff.h | D12 historical release archive | 17365 | 42920ae4d6080bfc2a72d92a9969b5e94eeaff070e5e71d90da9ab6d7d8e158e
fpga/d12/third_party/fatfs/ffconf.h | D12 historical release archive | 12715 | 08ab6d82a3db47ffa6337bedf0a0e6748aaa7a422cd8ea9947beb78338845c84
fpga/d12/third_party/fatfs/ffunicode.c | D12 historical release archive | 1974995 | 3f1632c1f1e64b0b683b0d7e51341b9870728f398604869dd8211f1819509a8e
fpga/d12/third_party/hack_spectrum/LICENSE | D12 historical release archive | 35150 | a528722b444d85696d4edafadf85c37f20ebdbb79835129d1d198cf297757825
fpga/d12/third_party/hack_spectrum/ORIGINAL_README.md | D12 historical release archive | 1256 | e6b17a14b8d6885358354eb10113704a8931302c4d1f8b94dd734160a7d1460e
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
fpga/d12/third_party/helix/testwrap/Umakefil | D12 historical release archive | 2030 | e6ccf1aa2ec440f86a33fbf9ff50eb8b479080b914f47b3b90eafab1390ace45
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
