xuanxly/fpga-piano-Chuyun/fpga/d13/docs/CONTEST_FAQ_RISK_REVIEW_20261102.md

# D12 对照赛事答疑的风险核对

核对日期：2026-11-02。对象：`pressure_piano_game_d12` 当前源码、925A位流对应数字报告、已有实板反馈。此次未修改HDL/固件/管脚，未重新编译或下载硬件。

## 依据及解释边界

- [答疑汇总·技术相关](https://docs.qq.com/sheet/DUXVvYWhsUmRhaVFI?tab=orss47)，以下用“技术问题号（回复单元格）”定位。
- [答疑汇总·赛事相关](https://docs.qq.com/sheet/DUXVvYWhsUmRhaVFI?tab=BB08J2)。
- [高云官网2026赛题原文与时间安排](https://www.gowinsemi.com.cn/university/match2026)。本地PPT第9～14页作为补充。

答疑表含往届答复搬运、整理者建议和未答问题。赛事表第43行明确标注前部来自上一届；部分新答复使用“应该”“我觉得”等措辞。因此下文保留答复的不确定性，不把整张表解释为具有同等确定性的本届正式承诺。技术问题133、134及赛事问题94的回复当前为空，不能视为已获批准。

## 结论

当前未发现足以认定整机违规的确定证据。实时合成、FFT、像素渲染和灯光核心仍为HDL。但不能宣称“全部要求和扩展均已达标”。最需要优先处理的是弱按压延迟、现场可验证性、软件辅助功能的工作量边界；此外还缺D12整机实板验收。

原复核中的两项需要更新：

1. 板载PT8211：技术100（D62）、赛事72（D77）给出倾向可接受的答复，建议额外引出标准I2S。当前不应再写成确定违规或必须外购DAC。
2. 规模：技术108/109（D70/D71）、赛事75/77（D80/D82）允许按合成分量统计及采样周期内时分复用。28个琴键不等于只有28个可计分合成分量，不能仅凭键数判定32路扩展未达；也不能未经统计直接宣称168个独立振荡器。

## 逐项风险

### R1 高：压力触发存在超过10ms的静态反例

依据：官网基础要求；技术95、103、115（D57、D65、D77）。外部传感器是否全部计入尚无统一口径，但FPGA内部处理应先满足要求。

当前四块MCP3008并行扫描，每键约0.99988ms更新一次。`pressure28_frontend.v`先做差值四分之一滤波，再用归一化结果决定触发；默认BASE=0、FULL=1023、PRESS_ON=160。

从空载阶跃到ADC=41，按源码整数规则，滤波值依次为：

`10,17,23,27,30,32,34,35,36,37,38,39,40`

第13次更新才达到归一化160。因此从原始输入变化至触发约需12～13ms，尚未包含音色起音和DAC。此为静态推算，不是实板或新增仿真结果；也不表示所有力度均超标，但足以否定当前“最坏情况必定≤10ms”的说法。

建议：后续将低延迟触发与持续力度平滑分开设计并验证；测量弱/强按压、触屏、不同音色，从原始有效控制到PCM及模拟音频的延迟。896周期/17.92µs仅是声部运算耗时，不能代替整链路数据。弦乐的渐强包络不能用“到达峰值时间”与“首次有效发声时间”混为一谈。

源码：`src/mcp3008_scan.v:6,18`、`src/mcp3008_scan28.v:3,14`、`src/pressure28_frontend.v:3,20,46,62`、`src/piano28_timbre_engine.v:63`。

### R2 高：WAV辅助播放确实经过软核，展示边界必须明确

依据：技术A2（D35）、赛事A2（D45）；技术133（D95）仍未答。用户此前转述已向赛事方确认辅助媒体播放不计工作量、不会因此整机违规，此事实保留，但当前表格未为这个专门问题提供新的书面明确答复。

当前VexRiscv执行C文件读取、WAV解析及重采样，播放PCM经复用器送向同一DAC。这与纯HDL演奏合成是两条不同来源，不能把文件播放器也算作纯硬件实时合成成果。录音的PCM生成和采集为HDL，WAV封装与写卡为软件。

建议：材料用两种颜色标出实时演奏主链与辅助媒体链；主展示先演奏且可在不读音频文件时工作。若需要更保守的参赛版，可另行关闭辅助播放，保留录音/文件传输，不必因本条立即删除所有软核服务。

证据：`src/media_soc.v:28,84,105`；`firmware/media_service.c:129,165,183`；`src/piano28_core.v:53`。

### R3 中：不能把整个作品宣称为“没有CPU、全部纯HDL”

依据：技术A2、90、91（D35、D52、D53），赛事58、68（D64、D73）。参数配置与外设控制并非一概禁用MCU；选题二音频/视觉核心另有要求。

FFT、柱图、UI像素、灯光发送和游戏计时判定是HDL；CPU仍提供文件名、状态文本、谱面校验和装载，CH569运行USB磁盘固件。这种划分有合理性，但对应软件工作不能全部归入纯HDL视觉算法。CPU文件名写入文本RAM，与CPU生成频谱/音效不是同一回事。

建议：逐模块列出“HDL／FPGA软核C／CH569 C／显示器内部驱动”，如实解释职责。屏幕自身HDMI驱动芯片、USB触控控制器的存在不等于违规。

证据：`src/piano28_touch_system.v:36,55,65,68,84`、`src/media_soc.v:84`、`docs/D12_DESIGN.md:9,43`。

### R4 中：振荡器规模与吞吐量尚无可审查的统计证明

依据：官网振荡器统计/吞吐量规则；技术101/102/108/109（D63、D64、D70、D71），赛事75/77（D80、D82）。

当前28份声部上下文，每声部计算多个显式正弦分量；部分音色还使用FM与独立铃音相位。时分复用本身符合答疑，键数不足32不直接等于规模不达标。但非当前音色使用的运算、静音声部、同一波形天然谐波、未进入输出的中间结果，不能机械累加。当前多个谐波由同一基频相位派生，包络也共享，需按加法分量/FM规则逐项解释。

建议：按五种音色列出实际非零可闻运算分量、状态、频率、包络、输出贡献与48kHz实际采样率；给出保守统计和频谱证据，再申报规模项。未做这份核对前，既不写“确定未达32”，也不写“已验证168个独立振荡器”。

证据：`src/piano28_timbre_engine.v:37,100,156,163,228,238,252,265`。

### R5 高：缺少已确认可从实机进入的多频验收模式

依据：官网“现场验证要求”；技术110（D72）说明一个音频通道即可，不要求多组I2S输出。

当前产品入口是六个应用；未在产品HDL/C入口找到专用多频测试模式。已有仿真testbench不能直接作为板上可操作入口。手按多键能演示复音，但当前32频段柱状图也不能逐一分辨和计数所有独立谱峰：2048点/48kHz的FFT频率间隔约23.44Hz，柱图还做了频段聚合，且自然音列及泛音会重叠。

建议：后续提供明确可进入的纯HDL验收模式，输出已知、分离的频率；用外部频谱或高分辨率原始FFT数据核验，并当场修改频率/力度证明实时运算。一个模拟音频输出通道即可。

证据：`src/media_ui28.v`、`src/piano28_core.v`、`src/spectrum_fft.v:7,12`。

### R6 低～中：PT8211可接受性已有正向答复，标准I2S仍需准确表述

依据：技术87、100、110（D49、D62、D72），赛事72（D77）。答复倾向允许现有板载PT8211，同时建议留GPIO标准I2S。

当前PT8211发送器是16位LSBJ/右对齐，不是带1bit延迟的标准I2S。3.5mm耳机输出可以继续保留；不能直接把这三根音频线复制并改名为标准I2S。

建议：材料如实说明板载DAC协议并引用答疑；资源/空闲引脚允许时可另增标准I2S串行输出作保底，无需先购买新DAC。此条不应再作为确定的整机违规结论。

证据：`src/pt8211_tx.v:72`、`src/piano28_core.v:72`。

### R7 中：独立演奏维度还缺实体链路闭环验收

依据：技术97、119（D59、D81）：不同传感原理不是硬性条件；选音和独立力度可成立。

28压力键的键位与持续力度、触屏音调/音量、明暗/揉弦已具备逻辑路径。历史实板反馈中，EC11旋钮及十灯/TRANS不响应仍未闭环；G3带亮F3也未见当前D12逐键实物复测结论。默认压力标定仍为全键0..1023，不能由仿真替代逐键空载/满量程/误触检查。

建议：逐键复测并记录；至少演示“固定音高改变力度”和“保持力度改变音高/音色”。不要将28个键等同28个维度，或将半音步进移调称作连续滑音。

证据：`src/piano28_core.v:4,27,33`、`src/pressure28_frontend.v:3`；项目导言中的D7旋钮问题记录为用户实板反馈，尚无新实测覆盖。

### R8 中：效果器扩展尚未覆盖

官网扩展要求包含混响、延迟、合唱等效果。当前有压力动态、明暗、移调、五种音色及吉他/弦乐揉弦，没有上述空间/延时类效果器。5Hz音高LFO不等于混响或合唱；五种音色不等于五个表情维度。

这是扩展得分缺口，不是由此认定基础作品违规。建议如实申报，在核心和实板稳定后再评估资源，不为堆功能挤掉基础验证时间。

### R9 高（交付）：D12真实TF、灯光与iPhone链路尚未验收

30项RTL自检、模拟128GB FAT32/exFAT、目标固件编译与协议测试均已有报告；报告状态明确仍待实板。不能把这些数字结果表述为真实128GB卡、CH569和iPhone17均已成功使用。

USB磁盘除了925A FPGA位流，还必须配套CH569固件；当前未刷写/未实测。CH569原固件读回备份与恢复演练也未完成。录音/游戏/磁盘模式互斥是当前设计，不能承诺磁盘拷贝同时录音/游戏。

建议：演示前完成开机、28复音、触屏、112灯、五分钟录音/暂停、卡上回读、手机拷贝和安全弹出闭环。手机USB可作为联动方式，技术124（D86）不强制蓝牙；但USB2磁盘不能宣称USB3高速传输，也不能宣称已实现任意键位自定义。

证据：`README.md:7`、`docs/CH569_D12_UPGRADE.md:7,16,32`、`docs/D12_DESIGN.md:39,51`、`reports/d12_verification.json:2`。

### R10 中：资源与时序余量限制继续扩展

当前最终报告：Logic38648/59904，BSRAM92/118，DSP72.5/118；Setup/Hold最小余量+0.283/+0.001ns，保留额外0.300ns建立预算。PR1014通用时钟布线告警仍在。

这不是已知STA失败，也不能仅凭1ps余量判定板子必然不稳定；但任何新模块都要重新实现，尚有IO电气与真实负载等模型外验收。答疑技术126（D88）也未给出统一工具修复法，而是建议关注实际影响。

建议：锁定925A可回退版本，先做稳定性验收；扩展按实际RAM/带宽预算，避免把“总LUT还够”当作所有资源/时序均充足。

证据：`reports/d12_verification.json:223,230`、`reports/implementation_stdout.log:278`。

### R11 中：来源、素材与新旧说明还需整理

赛事问题26（D30）要求作品不涉及知识产权与涉密问题；问题31（D34）澄清“往届作品提升”指自己的作品，不能把别人往届作品直接当自己成果。

当前保留VexRiscv/FatFs等第三方来源，不能宣称这些为团队原创。频谱HDL头部引用`docs/SPECTRUM.md`，但D12当前目录未带入该文件及原项目的hack_spectrum来源目录；早期目录有“只参考显示构思、未带入ESP32/arduinoFFT源码”的说明。应把准确来源说明补到最终提交包，不能因为旧说明缺失就直接推定代码侵权。GPL等许可的适用范围应根据实际复制内容核对。

七里香关卡来自用户提供的曲谱，改编为CSV并不自动证明拥有公开传播授权。提交演示可优先用本项目自写练习；使用第三方歌曲/曲谱时保留来源并确认使用范围。这里未作侵权判定。

D12还保留D9/D10历史说明和MP3材料；最终入口必须明确D12已去掉MP3运行时，不能用历史文档承诺现有功能。

### R12 高（形式）：匿名要求、现场独立作答与冻结版本

- 赛事问题15（D19）强调队名、报告、视频、演示不出现学校名称、校徽、地图位置等学校识别信息。当前未检查最终报告/视频/演示背景，属于待核对项，不是已发现泄露。注意桌面、工程路径、衣服、实验室背景与文档属性。
- 赛事问题46（D51）明确现场测验检查仿真波形、提供testbench，不能用AI作答。开发阶段使用AI不能直接等同于现场违规，但队员须能独立完成状态机及仿真、解释本工程。
- 赛事问题90（D95）区分已提交代码与后续现场完善，应保留提交版原件及哈希，后续版本另存。
- 官网当前列出的作品提交截止为2026-11-04 18:00。报名、组别、队员、材料模板等状态此次未登录核实；以本届系统/正式通知为准，不能拿表中往届答复替代。

## 优先顺序

1. 先解决/验证弱按压触发延迟，给出明确定义的PCM与模拟输出测量。
2. 明确纯HDL演奏主链与软件辅助边界，准备可操作的多频验收及保守的振荡器统计。
3. 完成D12实体琴键、触屏、灯光、TF卡与手机USB闭环，保留D11/925A原件。
4. 整理来源、匿名材料、提交包和现场独立仿真准备。
5. 有余力再考虑GPIO标准I2S、空间类效果及更多规模扩展，避免临近提交破坏已验证功能。

本次修改仅为说明文档，不包含功能修复、重新跑仿真/综合或实板测试。新的风险结论没有被倒填成925A发布时已验证的结果，原发布ZIP保持不变。
