xuanxly/fpga-piano-Chuyun/fpga/d13/docs/hardware/PCB4_20261021/PCB4.pdf

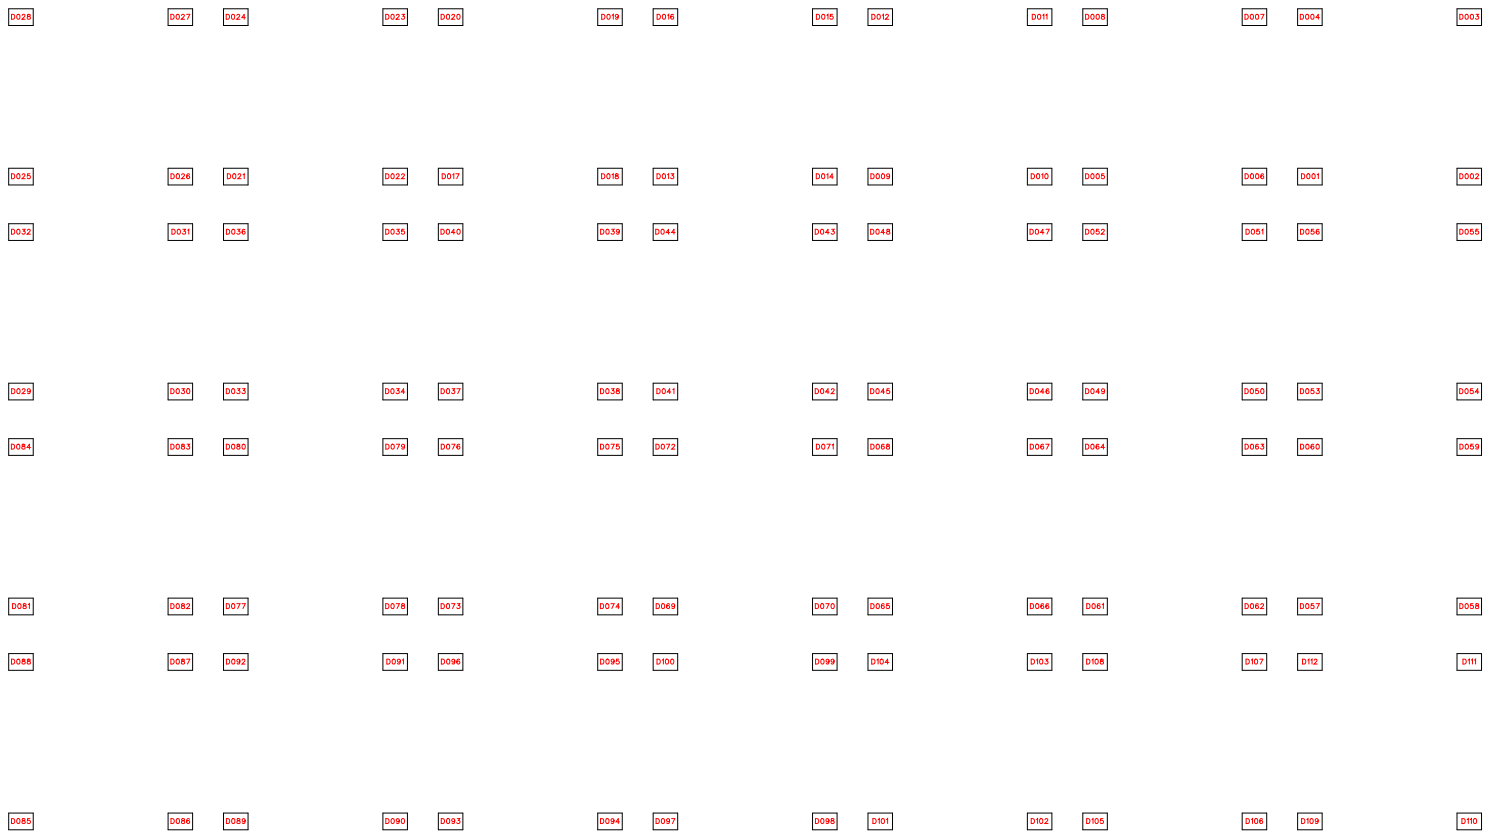
[picture p86: page 1]

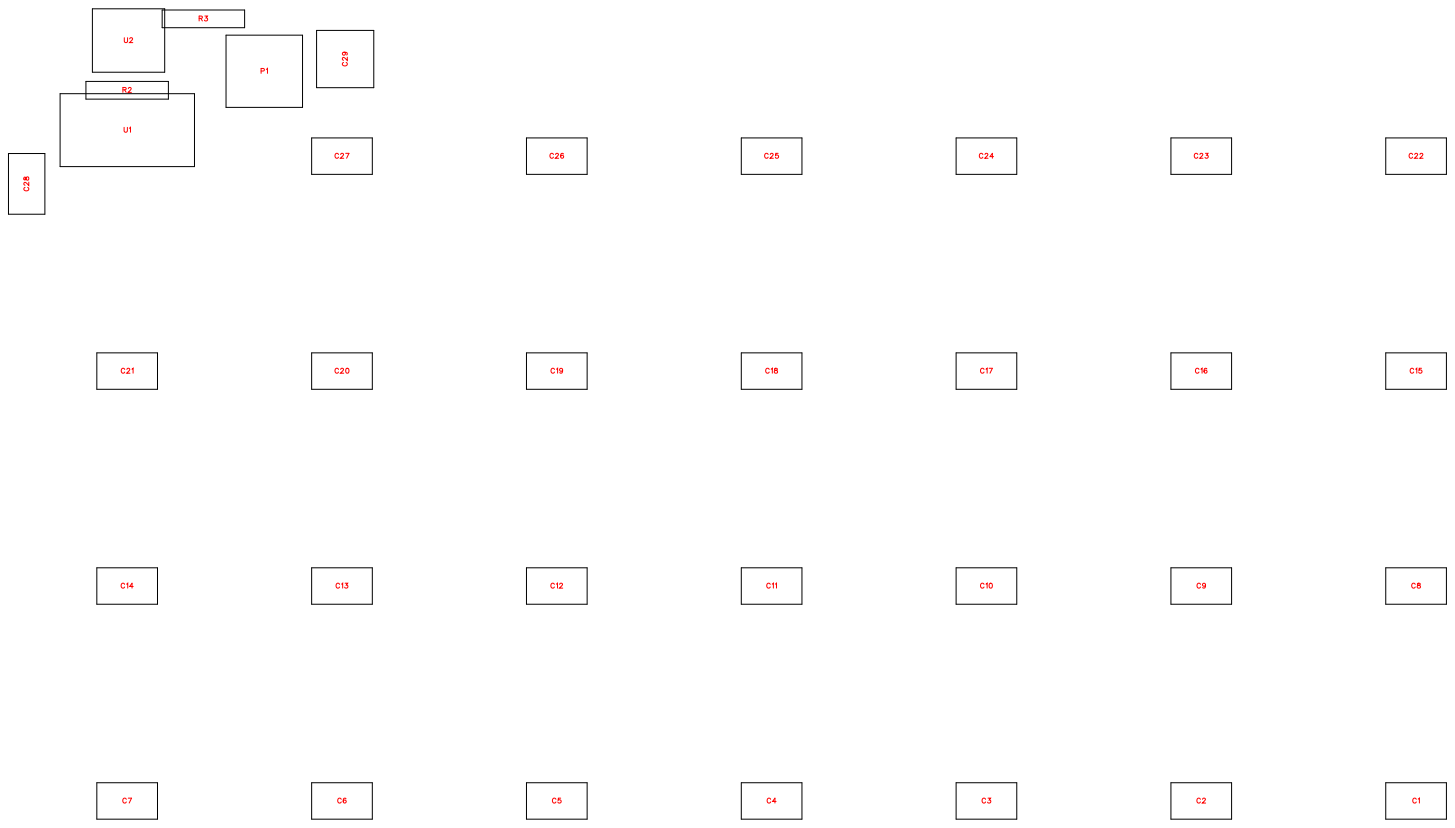
[picture p87: page 2]

No. | Quantity | Comment | Designator | Footprint | Value | Manufacturer Part | Manufacturer | Supplier Part | Supplier
1 | 28 | 100nF | C1,C2,C3,C4,C5,C6,C7,C8, C9,C10,C11,C12,C13,C14, C15,C16,C17,C18,C19,C20 ,C21,C22,C23,C24,C25,C2 6,C27,C28 | CAP-TH_L8. 5-W5.0-P5.0 0-D1.2 | 100nF | CT4-0805B1 04K500F3 | FH(风华 ) | C84772 | LCSC
2 | 1 | 470uF | C29 | CAP-TH_BD 8.0-P3.50-D0 .6-FD | 470uF | OCR471M1C BK-0811G | Lelon(立隆 ) | C134851 | LCSC
3 | 112 | WS2812B-20 20-V6

D001,D002,D003,D004,D00
5,D006,D007,D008,D009,D
010,D011,D012,D013,D014,
D015,D016,D017,D018,D01
9,D020,D021,D022,D023,D
024,D025,D026,D027,D028,
D029,D030,D031,D032,D03
3,D034,D035,D036,D037,D
038,D039,D040,D041,D042,
D043,D044,D045,D046,D04
7,D048,D049,D050,D051,D
052,D053,D054,D055,D056,
D057,D058,D059,D060,D06
1,D062,D063,D064,D065,D
066,D067,D068,D069,D070,
D071,D072,D073,D074,D07
5,D076,D077,D078,D079,D
080,D081,D082,D083,D084,
D085,D086,D087,D088,D08
9,D090,D091,D092,D093,D
094,D095,D096,D097,D098,
D099,D100,D101,D102,D10
3,D104,D105,D106,D107,D
108,D109,D110,D111,D112

LED-SMD_4
P-L2.2-W2.0-
P1.00_WS28
15C-2020-4P

WS2812B-20
20-V6
worldsemi | C52917434 | LCSC
4 | 1 | WJ500V-5.08 -2P | P1 | CONN-TH_2 P-P5.00_WJ 500V-5.08-2 P | | WJ500V-5.08 -2P | KANGNEX( 康奈克斯电气 ) | C8465 | LCSC
5 | 1 | 33 | R2 | RES-TH_BD 2.3-L6.5-P10. 50-D0.5 | 33 | CF1/4W-33 ±5% T | CCO(千志电 子) | C120019 | LCSC
6 | 1 | 10k | R3 | RES-TH_BD 2.3-L6.5-P10. 50-D0.5 | 10k | MF1/4W-10K ±1% T | CCO(千志电 子) | C119347 | LCSC
7 | 1 | SN74HCT12 5N | U1 | PDIP-14_L19 .3-W6.4-P2.5 4-LS7.6-BL | | SN74HCT12 5N | TI(德州仪器 ) | C154102 | LCSC
8 | 1 | PZ2.54-1*4-WZ | U2 | HDR-TH_4P-P2.54-H-M-W7.7-P | | PZ2.54-1*4-WZ | ZHOURI( 洲 日 ) | C5224015 | LCSC

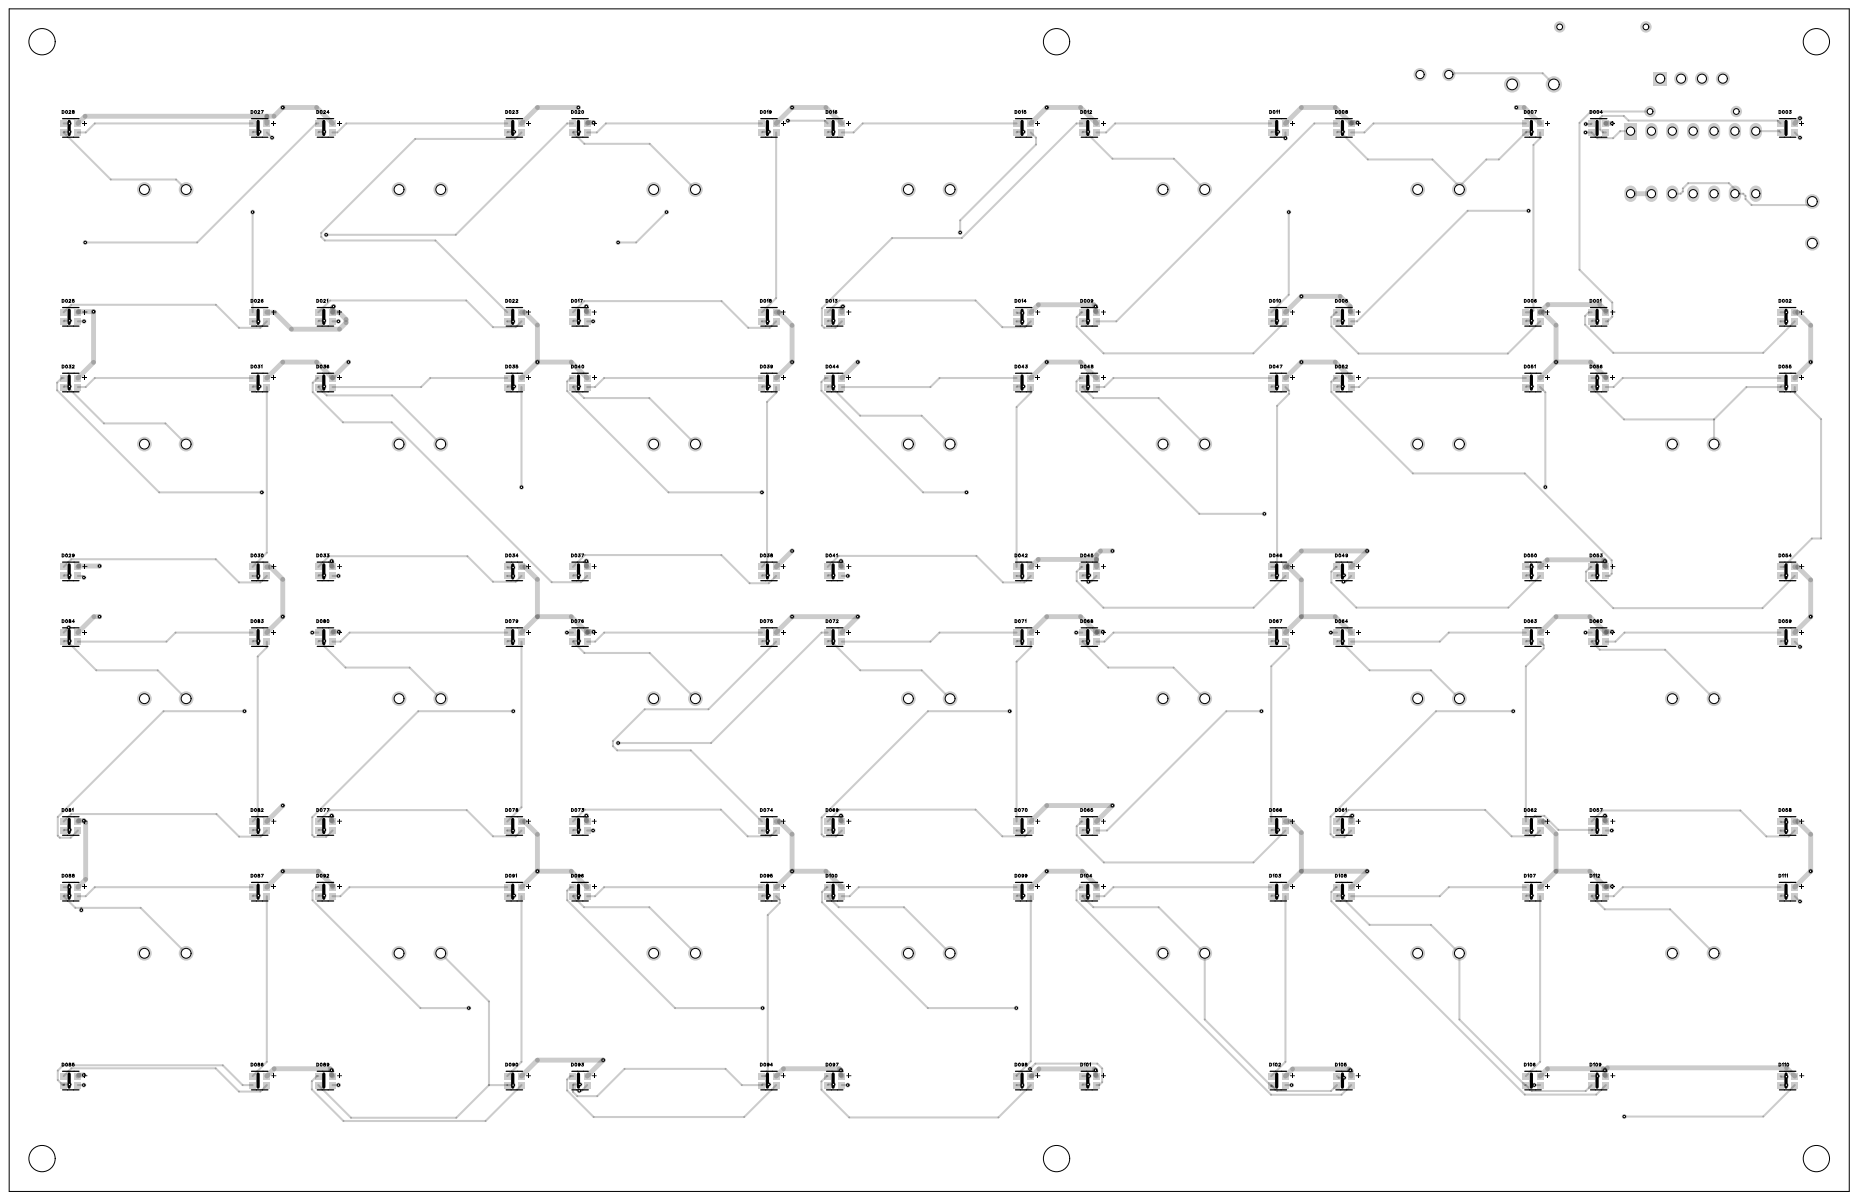
[picture p88: page 4]

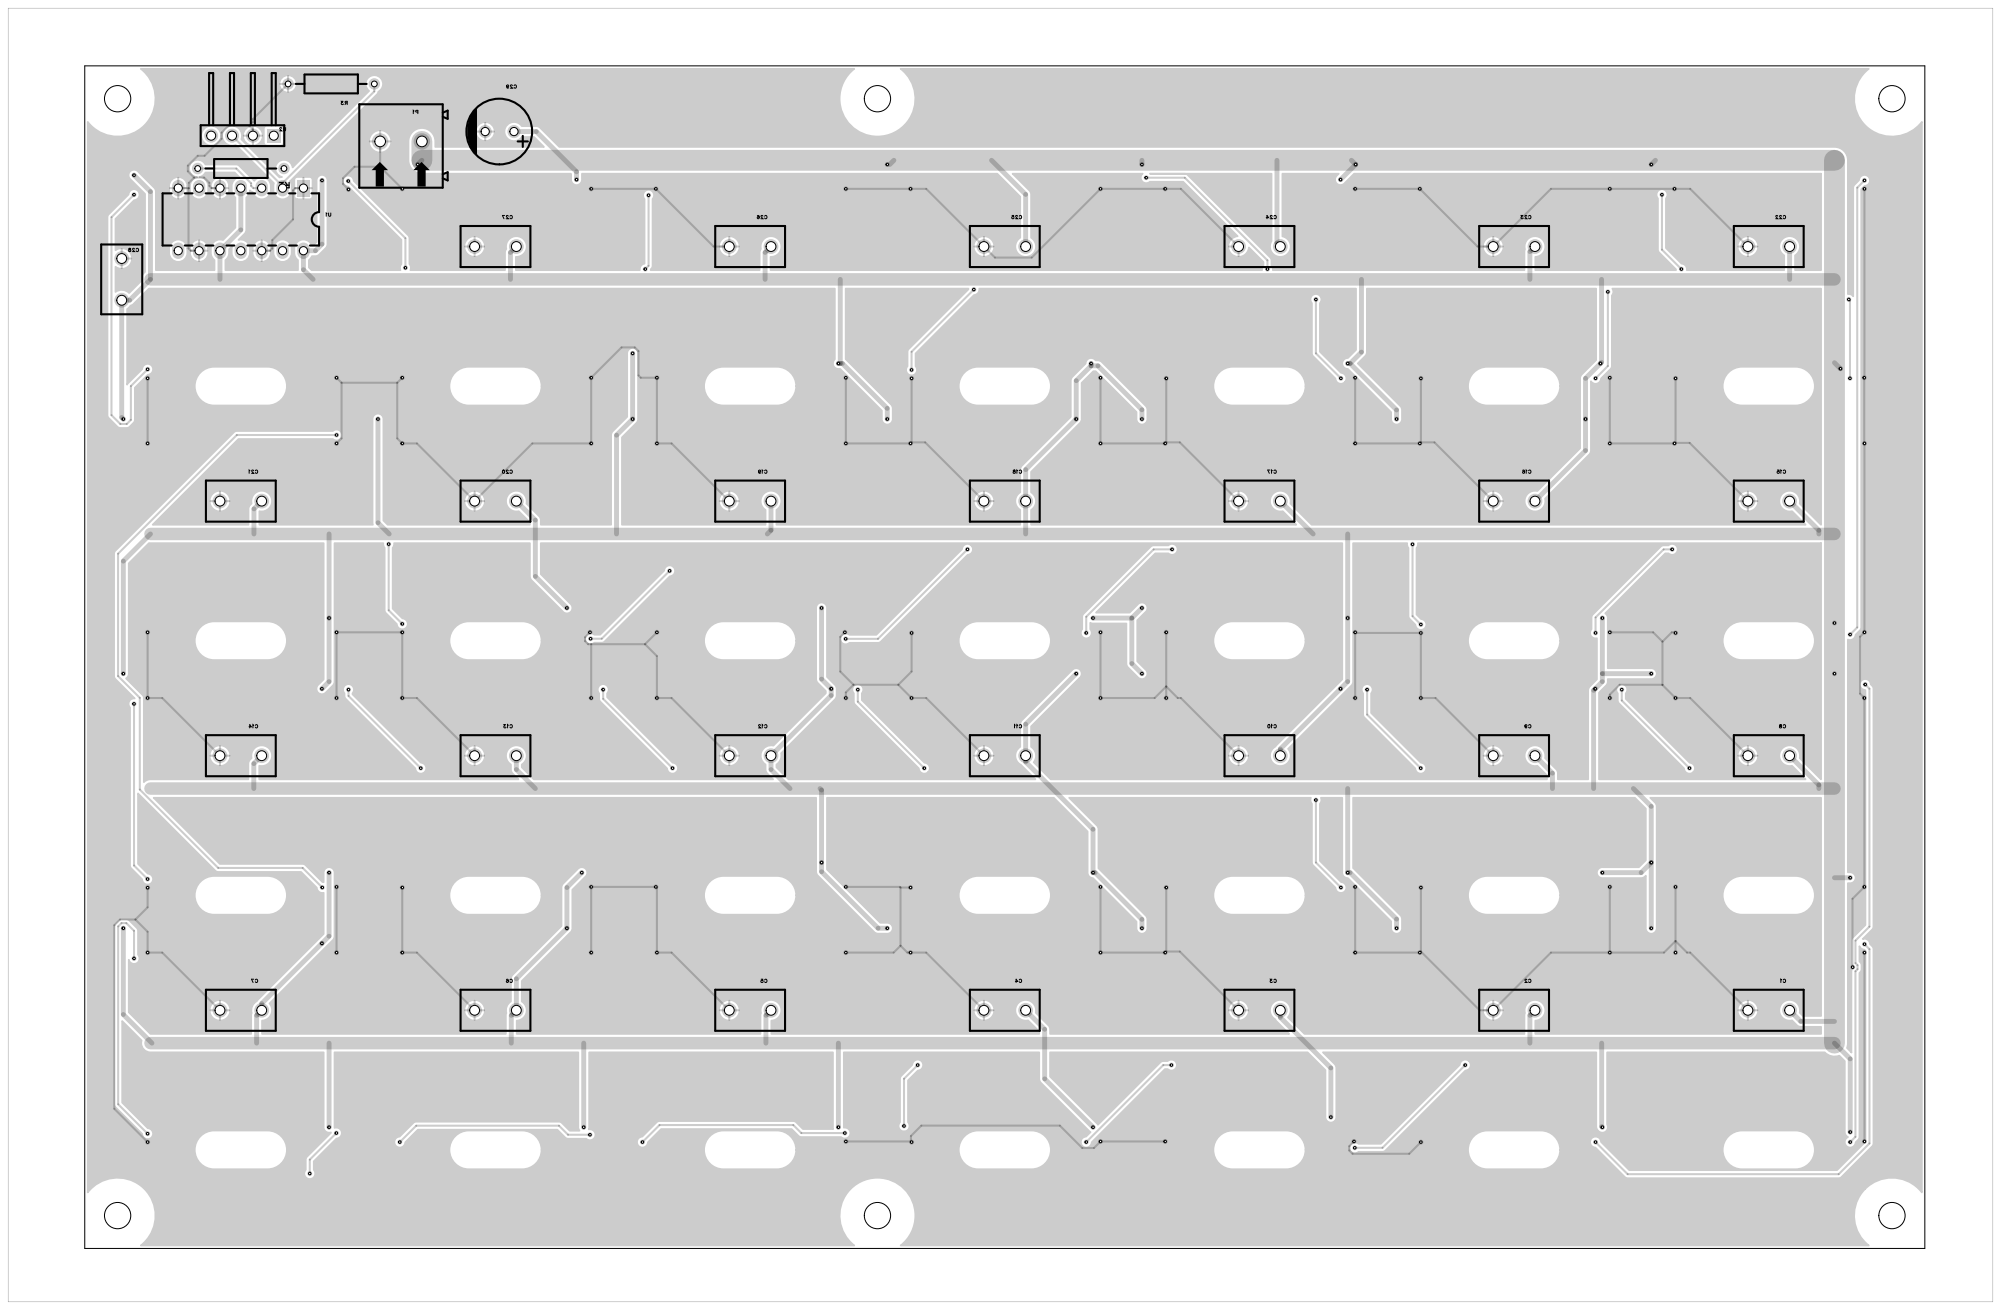
[picture p89: page 5]

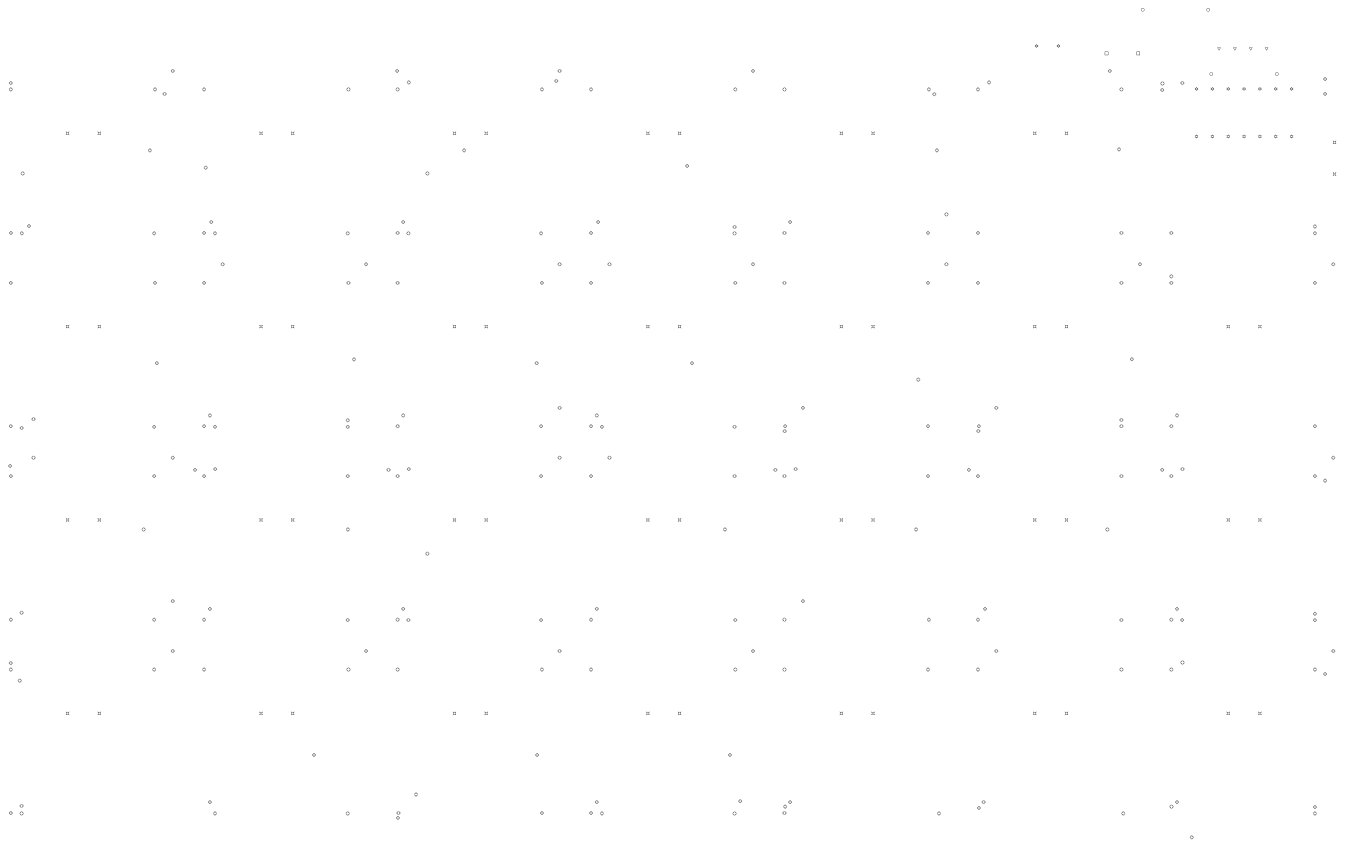
[picture p90: page 6]
