xuanxly/fpga-piano-Chuyun/fpga/d13/src/VexRiscv.v

// Generator : SpinalHDL v1.9.4    git head : 270018552577f3bb8e5339ee2583c9c22d324215
// Component : VexRiscv
// Git hash  : 63430af99f84cc1d11d58b556debe1cc3f238c67

`timescale 1ns/1ps

module VexRiscv (
  input  wire [31:0]   externalResetVector,
  input  wire          timerInterrupt,
  input  wire          softwareInterrupt,
  input  wire [31:0]   externalInterruptArray,
  output reg           iBusWishbone_CYC,
  output reg           iBusWishbone_STB,
  input  wire          iBusWishbone_ACK,
  output wire          iBusWishbone_WE,
  output wire [29:0]   iBusWishbone_ADR,
  input  wire [31:0]   iBusWishbone_DAT_MISO,
  output wire [31:0]   iBusWishbone_DAT_MOSI,
  output wire [3:0]    iBusWishbone_SEL,
  input  wire          iBusWishbone_ERR,
  output wire [2:0]    iBusWishbone_CTI,
  output wire [1:0]    iBusWishbone_BTE,
  output wire          dBusWishbone_CYC,
  output wire          dBusWishbone_STB,
  input  wire          dBusWishbone_ACK,
  output wire          dBusWishbone_WE,
  output wire [29:0]   dBusWishbone_ADR,
  input  wire [31:0]   dBusWishbone_DAT_MISO,
  output wire [31:0]   dBusWishbone_DAT_MOSI,
  output wire [3:0]    dBusWishbone_SEL,
  input  wire          dBusWishbone_ERR,
  output wire [2:0]    dBusWishbone_CTI,
  output wire [1:0]    dBusWishbone_BTE,
  input  wire          clk,
  input  wire          reset
);
  localparam ShiftCtrlEnum_DISABLE_1 = 2'd0;
  localparam ShiftCtrlEnum_SLL_1 = 2'd1;
  localparam ShiftCtrlEnum_SRL_1 = 2'd2;
  localparam ShiftCtrlEnum_SRA_1 = 2'd3;
  localparam EnvCtrlEnum_NONE = 2'd0;
  localparam EnvCtrlEnum_XRET = 2'd1;
  localparam EnvCtrlEnum_ECALL = 2'd2;
  localparam BranchCtrlEnum_INC = 2'd0;
  localparam BranchCtrlEnum_B = 2'd1;
  localparam BranchCtrlEnum_JAL = 2'd2;
  localparam BranchCtrlEnum_JALR = 2'd3;
  localparam AluBitwiseCtrlEnum_XOR_1 = 2'd0;
  localparam AluBitwiseCtrlEnum_OR_1 = 2'd1;
  localparam AluBitwiseCtrlEnum_AND_1 = 2'd2;
  localparam Src2CtrlEnum_RS = 2'd0;
  localparam Src2CtrlEnum_IMI = 2'd1;
  localparam Src2CtrlEnum_IMS = 2'd2;
  localparam Src2CtrlEnum_PC = 2'd3;
  localparam AluCtrlEnum_ADD_SUB = 2'd0;
  localparam AluCtrlEnum_SLT_SLTU = 2'd1;
  localparam AluCtrlEnum_BITWISE = 2'd2;
  localparam Src1CtrlEnum_RS = 2'd0;
  localparam Src1CtrlEnum_IMU = 2'd1;
  localparam Src1CtrlEnum_PC_INCREMENT = 2'd2;
  localparam Src1CtrlEnum_URS1 = 2'd3;

  wire                IBusCachedPlugin_cache_io_flush;
  wire                IBusCachedPlugin_cache_io_cpu_prefetch_isValid;
  wire                IBusCachedPlugin_cache_io_cpu_fetch_isValid;
  wire                IBusCachedPlugin_cache_io_cpu_fetch_isStuck;
  wire                IBusCachedPlugin_cache_io_cpu_fetch_isRemoved;
  wire                IBusCachedPlugin_cache_io_cpu_decode_isValid;
  wire                IBusCachedPlugin_cache_io_cpu_decode_isStuck;
  wire                IBusCachedPlugin_cache_io_cpu_decode_isUser;
  reg                 IBusCachedPlugin_cache_io_cpu_fill_valid;
  wire                dataCache_1_io_cpu_execute_isValid;
  wire       [31:0]   dataCache_1_io_cpu_execute_address;
  wire                dataCache_1_io_cpu_memory_isValid;
  wire       [31:0]   dataCache_1_io_cpu_memory_address;
  reg                 dataCache_1_io_cpu_memory_mmuRsp_isIoAccess;
  reg                 dataCache_1_io_cpu_writeBack_isValid;
  wire                dataCache_1_io_cpu_writeBack_isUser;
  wire       [31:0]   dataCache_1_io_cpu_writeBack_storeData;
  wire       [31:0]   dataCache_1_io_cpu_writeBack_address;
  wire                dataCache_1_io_cpu_writeBack_fence_SW;
  wire                dataCache_1_io_cpu_writeBack_fence_SR;
  wire                dataCache_1_io_cpu_writeBack_fence_SO;
  wire                dataCache_1_io_cpu_writeBack_fence_SI;
  wire                dataCache_1_io_cpu_writeBack_fence_PW;
  wire                dataCache_1_io_cpu_writeBack_fence_PR;
  wire                dataCache_1_io_cpu_writeBack_fence_PO;
  wire                dataCache_1_io_cpu_writeBack_fence_PI;
  wire       [3:0]    dataCache_1_io_cpu_writeBack_fence_FM;
  wire                dataCache_1_io_cpu_flush_valid;
  wire                dataCache_1_io_cpu_flush_payload_singleLine;
  wire       [6:0]    dataCache_1_io_cpu_flush_payload_lineId;
  reg        [31:0]   _zz_RegFilePlugin_regFile_port0;
  reg        [31:0]   _zz_RegFilePlugin_regFile_port1;
  wire                IBusCachedPlugin_cache_io_cpu_prefetch_haltIt;
  wire       [31:0]   IBusCachedPlugin_cache_io_cpu_fetch_data;
  wire       [31:0]   IBusCachedPlugin_cache_io_cpu_fetch_physicalAddress;
  wire                IBusCachedPlugin_cache_io_cpu_decode_error;
  wire                IBusCachedPlugin_cache_io_cpu_decode_mmuRefilling;
  wire                IBusCachedPlugin_cache_io_cpu_decode_mmuException;
  wire       [31:0]   IBusCachedPlugin_cache_io_cpu_decode_data;
  wire                IBusCachedPlugin_cache_io_cpu_decode_cacheMiss;
  wire       [31:0]   IBusCachedPlugin_cache_io_cpu_decode_physicalAddress;
  wire                IBusCachedPlugin_cache_io_mem_cmd_valid;
  wire       [31:0]   IBusCachedPlugin_cache_io_mem_cmd_payload_address;
  wire       [2:0]    IBusCachedPlugin_cache_io_mem_cmd_payload_size;
  wire                dataCache_1_io_cpu_execute_haltIt;
  wire                dataCache_1_io_cpu_execute_refilling;
  wire                dataCache_1_io_cpu_memory_isWrite;
  wire                dataCache_1_io_cpu_writeBack_haltIt;
  wire       [31:0]   dataCache_1_io_cpu_writeBack_data;
  wire                dataCache_1_io_cpu_writeBack_mmuException;
  wire                dataCache_1_io_cpu_writeBack_unalignedAccess;
  wire                dataCache_1_io_cpu_writeBack_accessError;
  wire                dataCache_1_io_cpu_writeBack_isWrite;
  wire                dataCache_1_io_cpu_writeBack_keepMemRspData;
  wire                dataCache_1_io_cpu_writeBack_exclusiveOk;
  wire                dataCache_1_io_cpu_flush_ready;
  wire                dataCache_1_io_cpu_redo;
  wire                dataCache_1_io_cpu_writesPending;
  wire                dataCache_1_io_mem_cmd_valid;
  wire                dataCache_1_io_mem_cmd_payload_wr;
  wire                dataCache_1_io_mem_cmd_payload_uncached;
  wire       [31:0]   dataCache_1_io_mem_cmd_payload_address;
  wire       [31:0]   dataCache_1_io_mem_cmd_payload_data;
  wire       [3:0]    dataCache_1_io_mem_cmd_payload_mask;
  wire       [2:0]    dataCache_1_io_mem_cmd_payload_size;
  wire                dataCache_1_io_mem_cmd_payload_last;
  wire       [51:0]   _zz_memory_MUL_LOW;
  wire       [51:0]   _zz_memory_MUL_LOW_1;
  wire       [51:0]   _zz_memory_MUL_LOW_2;
  wire       [32:0]   _zz_memory_MUL_LOW_3;
  wire       [51:0]   _zz_memory_MUL_LOW_4;
  wire       [49:0]   _zz_memory_MUL_LOW_5;
  wire       [51:0]   _zz_memory_MUL_LOW_6;
  wire       [49:0]   _zz_memory_MUL_LOW_7;
  wire       [31:0]   _zz_execute_SHIFT_RIGHT;
  wire       [32:0]   _zz_execute_SHIFT_RIGHT_1;
  wire       [32:0]   _zz_execute_SHIFT_RIGHT_2;
  wire       [31:0]   _zz_decode_LEGAL_INSTRUCTION;
  wire       [31:0]   _zz_decode_LEGAL_INSTRUCTION_1;
  wire       [31:0]   _zz_decode_LEGAL_INSTRUCTION_2;
  wire                _zz_decode_LEGAL_INSTRUCTION_3;
  wire       [0:0]    _zz_decode_LEGAL_INSTRUCTION_4;
  wire       [12:0]   _zz_decode_LEGAL_INSTRUCTION_5;
  wire       [31:0]   _zz_decode_LEGAL_INSTRUCTION_6;
  wire       [31:0]   _zz_decode_LEGAL_INSTRUCTION_7;
  wire       [31:0]   _zz_decode_LEGAL_INSTRUCTION_8;
  wire                _zz_decode_LEGAL_INSTRUCTION_9;
  wire       [0:0]    _zz_decode_LEGAL_INSTRUCTION_10;
  wire       [6:0]    _zz_decode_LEGAL_INSTRUCTION_11;
  wire       [31:0]   _zz_decode_LEGAL_INSTRUCTION_12;
  wire       [31:0]   _zz_decode_LEGAL_INSTRUCTION_13;
  wire       [31:0]   _zz_decode_LEGAL_INSTRUCTION_14;
  wire                _zz_decode_LEGAL_INSTRUCTION_15;
  wire       [0:0]    _zz_decode_LEGAL_INSTRUCTION_16;
  wire       [0:0]    _zz_decode_LEGAL_INSTRUCTION_17;
  wire       [3:0]    _zz__zz_IBusCachedPlugin_jump_pcLoad_payload_1;
  reg        [31:0]   _zz_IBusCachedPlugin_jump_pcLoad_payload_5;
  wire       [1:0]    _zz_IBusCachedPlugin_jump_pcLoad_payload_6;
  wire       [31:0]   _zz_IBusCachedPlugin_fetchPc_pc;
  wire       [2:0]    _zz_IBusCachedPlugin_fetchPc_pc_1;
  wire       [11:0]   _zz__zz_IBusCachedPlugin_decodePrediction_cmd_hadBranch;
  wire       [31:0]   _zz_IBusCachedPlugin_decodePrediction_cmd_hadBranch_2;
  wire       [19:0]   _zz__zz_2;
  wire       [11:0]   _zz__zz_4;
  wire       [31:0]   _zz__zz_6;
  wire       [31:0]   _zz__zz_6_1;
  wire       [19:0]   _zz__zz_IBusCachedPlugin_predictionJumpInterface_payload;
  wire       [11:0]   _zz__zz_IBusCachedPlugin_predictionJumpInterface_payload_2;
  wire                _zz_IBusCachedPlugin_predictionJumpInterface_payload_4;
  wire                _zz_IBusCachedPlugin_predictionJumpInterface_payload_5;
  wire                _zz_IBusCachedPlugin_predictionJumpInterface_payload_6;
  wire       [26:0]   _zz_io_cpu_flush_payload_lineId;
  wire       [26:0]   _zz_io_cpu_flush_payload_lineId_1;
  wire       [2:0]    _zz_DBusCachedPlugin_exceptionBus_payload_code;
  wire       [2:0]    _zz_DBusCachedPlugin_exceptionBus_payload_code_1;
  reg        [7:0]    _zz_writeBack_DBusCachedPlugin_rspShifted;
  wire       [1:0]    _zz_writeBack_DBusCachedPlugin_rspShifted_1;
  reg        [7:0]    _zz_writeBack_DBusCachedPlugin_rspShifted_2;
  wire       [0:0]    _zz_writeBack_DBusCachedPlugin_rspShifted_3;
  wire       [31:0]   _zz__zz_decode_IS_RS2_SIGNED;
  wire       [31:0]   _zz__zz_decode_IS_RS2_SIGNED_1;
  wire                _zz__zz_decode_IS_RS2_SIGNED_2;
  wire       [0:0]    _zz__zz_decode_IS_RS2_SIGNED_3;
  wire                _zz__zz_decode_IS_RS2_SIGNED_4;
  wire       [31:0]   _zz__zz_decode_IS_RS2_SIGNED_5;
  wire       [0:0]    _zz__zz_decode_IS_RS2_SIGNED_6;
  wire                _zz__zz_decode_IS_RS2_SIGNED_7;
  wire                _zz__zz_decode_IS_RS2_SIGNED_8;
  wire       [24:0]   _zz__zz_decode_IS_RS2_SIGNED_9;
  wire       [0:0]    _zz__zz_decode_IS_RS2_SIGNED_10;
  wire       [0:0]    _zz__zz_decode_IS_RS2_SIGNED_11;
  wire       [31:0]   _zz__zz_decode_IS_RS2_SIGNED_12;
  wire       [0:0]    _zz__zz_decode_IS_RS2_SIGNED_13;
  wire       [31:0]   _zz__zz_decode_IS_RS2_SIGNED_14;
  wire                _zz__zz_decode_IS_RS2_SIGNED_15;
  wire       [31:0]   _zz__zz_decode_IS_RS2_SIGNED_16;
  wire       [31:0]   _zz__zz_decode_IS_RS2_SIGNED_17;
  wire       [0:0]    _zz__zz_decode_IS_RS2_SIGNED_18;
  wire       [0:0]    _zz__zz_decode_IS_RS2_SIGNED_19;
  wire       [0:0]    _zz__zz_decode_IS_RS2_SIGNED_20;
  wire       [20:0]   _zz__zz_decode_IS_RS2_SIGNED_21;
  wire       [0:0]    _zz__zz_decode_IS_RS2_SIGNED_22;
  wire                _zz__zz_decode_IS_RS2_SIGNED_23;
  wire       [31:0]   _zz__zz_decode_IS_RS2_SIGNED_24;
  wire       [0:0]    _zz__zz_decode_IS_RS2_SIGNED_25;
  wire       [31:0]   _zz__zz_decode_IS_RS2_SIGNED_26;
  wire       [31:0]   _zz__zz_decode_IS_RS2_SIGNED_27;
  wire       [17:0]   _zz__zz_decode_IS_RS2_SIGNED_28;
  wire       [0:0]    _zz__zz_decode_IS_RS2_SIGNED_29;
  wire       [0:0]    _zz__zz_decode_IS_RS2_SIGNED_30;
  wire       [0:0]    _zz__zz_decode_IS_RS2_SIGNED_31;
  wire                _zz__zz_decode_IS_RS2_SIGNED_32;
  wire       [31:0]   _zz__zz_decode_IS_RS2_SIGNED_33;
  wire       [31:0]   _zz__zz_decode_IS_RS2_SIGNED_34;
  wire       [31:0]   _zz__zz_decode_IS_RS2_SIGNED_35;
  wire       [31:0]   _zz__zz_decode_IS_RS2_SIGNED_36;
  wire       [0:0]    _zz__zz_decode_IS_RS2_SIGNED_37;
  wire                _zz__zz_decode_IS_RS2_SIGNED_38;
  wire       [0:0]    _zz__zz_decode_IS_RS2_SIGNED_39;
  wire       [0:0]    _zz__zz_decode_IS_RS2_SIGNED_40;
  wire       [31:0]   _zz__zz_decode_IS_RS2_SIGNED_41;
  wire       [13:0]   _zz__zz_decode_IS_RS2_SIGNED_42;
  wire                _zz__zz_decode_IS_RS2_SIGNED_43;
  wire       [4:0]    _zz__zz_decode_IS_RS2_SIGNED_44;
  wire       [31:0]   _zz__zz_decode_IS_RS2_SIGNED_45;
  wire       [31:0]   _zz__zz_decode_IS_RS2_SIGNED_46;
  wire       [0:0]    _zz__zz_decode_IS_RS2_SIGNED_47;
  wire       [31:0]   _zz__zz_decode_IS_RS2_SIGNED_48;
  wire       [31:0]   _zz__zz_decode_IS_RS2_SIGNED_49;
  wire       [1:0]    _zz__zz_decode_IS_RS2_SIGNED_50;
  wire                _zz__zz_decode_IS_RS2_SIGNED_51;
  wire       [31:0]   _zz__zz_decode_IS_RS2_SIGNED_52;
  wire                _zz__zz_decode_IS_RS2_SIGNED_53;
  wire       [31:0]   _zz__zz_decode_IS_RS2_SIGNED_54;
  wire                _zz__zz_decode_IS_RS2_SIGNED_55;
  wire       [0:0]    _zz__zz_decode_IS_RS2_SIGNED_56;
  wire       [31:0]   _zz__zz_decode_IS_RS2_SIGNED_57;
  wire       [31:0]   _zz__zz_decode_IS_RS2_SIGNED_58;
  wire       [2:0]    _zz__zz_decode_IS_RS2_SIGNED_59;
  wire                _zz__zz_decode_IS_RS2_SIGNED_60;
  wire       [31:0]   _zz__zz_decode_IS_RS2_SIGNED_61;
  wire       [0:0]    _zz__zz_decode_IS_RS2_SIGNED_62;
  wire       [31:0]   _zz__zz_decode_IS_RS2_SIGNED_63;
  wire       [31:0]   _zz__zz_decode_IS_RS2_SIGNED_64;
  wire       [0:0]    _zz__zz_decode_IS_RS2_SIGNED_65;
  wire       [31:0]   _zz__zz_decode_IS_RS2_SIGNED_66;
  wire       [31:0]   _zz__zz_decode_IS_RS2_SIGNED_67;
  wire       [0:0]    _zz__zz_decode_IS_RS2_SIGNED_68;
  wire       [0:0]    _zz__zz_decode_IS_RS2_SIGNED_69;
  wire       [4:0]    _zz__zz_decode_IS_RS2_SIGNED_70;
  wire                _zz__zz_decode_IS_RS2_SIGNED_71;
  wire       [31:0]   _zz__zz_decode_IS_RS2_SIGNED_72;
  wire       [0:0]    _zz__zz_decode_IS_RS2_SIGNED_73;
  wire       [31:0]   _zz__zz_decode_IS_RS2_SIGNED_74;
  wire       [31:0]   _zz__zz_decode_IS_RS2_SIGNED_75;
  wire       [2:0]    _zz__zz_decode_IS_RS2_SIGNED_76;
  wire                _zz__zz_decode_IS_RS2_SIGNED_77;
  wire       [0:0]    _zz__zz_decode_IS_RS2_SIGNED_78;
  wire       [31:0]   _zz__zz_decode_IS_RS2_SIGNED_79;
  wire       [0:0]    _zz__zz_decode_IS_RS2_SIGNED_80;
  wire       [31:0]   _zz__zz_decode_IS_RS2_SIGNED_81;
  wire       [9:0]    _zz__zz_decode_IS_RS2_SIGNED_82;
  wire       [1:0]    _zz__zz_decode_IS_RS2_SIGNED_83;
  wire                _zz__zz_decode_IS_RS2_SIGNED_84;
  wire       [31:0]   _zz__zz_decode_IS_RS2_SIGNED_85;
  wire                _zz__zz_decode_IS_RS2_SIGNED_86;
  wire       [0:0]    _zz__zz_decode_IS_RS2_SIGNED_87;
  wire       [0:0]    _zz__zz_decode_IS_RS2_SIGNED_88;
  wire       [31:0]   _zz__zz_decode_IS_RS2_SIGNED_89;
  wire       [31:0]   _zz__zz_decode_IS_RS2_SIGNED_90;
  wire       [0:0]    _zz__zz_decode_IS_RS2_SIGNED_91;
  wire       [0:0]    _zz__zz_decode_IS_RS2_SIGNED_92;
  wire       [31:0]   _zz__zz_decode_IS_RS2_SIGNED_93;
  wire       [31:0]   _zz__zz_decode_IS_RS2_SIGNED_94;
  wire       [6:0]    _zz__zz_decode_IS_RS2_SIGNED_95;
  wire                _zz__zz_decode_IS_RS2_SIGNED_96;
  wire                _zz__zz_decode_IS_RS2_SIGNED_97;
  wire       [0:0]    _zz__zz_decode_IS_RS2_SIGNED_98;
  wire       [4:0]    _zz__zz_decode_IS_RS2_SIGNED_99;
  wire       [31:0]   _zz__zz_decode_IS_RS2_SIGNED_100;
  wire       [31:0]   _zz__zz_decode_IS_RS2_SIGNED_101;
  wire       [0:0]    _zz__zz_decode_IS_RS2_SIGNED_102;
  wire       [31:0]   _zz__zz_decode_IS_RS2_SIGNED_103;
  wire       [1:0]    _zz__zz_decode_IS_RS2_SIGNED_104;
  wire       [31:0]   _zz__zz_decode_IS_RS2_SIGNED_105;
  wire       [31:0]   _zz__zz_decode_IS_RS2_SIGNED_106;
  wire       [31:0]   _zz__zz_decode_IS_RS2_SIGNED_107;
  wire       [31:0]   _zz__zz_decode_IS_RS2_SIGNED_108;
  wire       [4:0]    _zz__zz_decode_IS_RS2_SIGNED_109;
  wire                _zz__zz_decode_IS_RS2_SIGNED_110;
  wire       [31:0]   _zz__zz_decode_IS_RS2_SIGNED_111;
  wire       [31:0]   _zz__zz_decode_IS_RS2_SIGNED_112;
  wire       [0:0]    _zz__zz_decode_IS_RS2_SIGNED_113;
  wire       [0:0]    _zz__zz_decode_IS_RS2_SIGNED_114;
  wire       [31:0]   _zz__zz_decode_IS_RS2_SIGNED_115;
  wire       [1:0]    _zz__zz_decode_IS_RS2_SIGNED_116;
  wire       [31:0]   _zz__zz_decode_IS_RS2_SIGNED_117;
  wire       [31:0]   _zz__zz_decode_IS_RS2_SIGNED_118;
  wire       [31:0]   _zz__zz_decode_IS_RS2_SIGNED_119;
  wire       [31:0]   _zz__zz_decode_IS_RS2_SIGNED_120;
  wire       [2:0]    _zz__zz_decode_IS_RS2_SIGNED_121;
  wire       [1:0]    _zz__zz_decode_IS_RS2_SIGNED_122;
  wire       [31:0]   _zz__zz_decode_IS_RS2_SIGNED_123;
  wire       [31:0]   _zz__zz_decode_IS_RS2_SIGNED_124;
  wire                _zz__zz_decode_IS_RS2_SIGNED_125;
  wire                _zz__zz_decode_IS_RS2_SIGNED_126;
  wire                _zz__zz_decode_IS_RS2_SIGNED_127;
  wire       [31:0]   _zz__zz_decode_IS_RS2_SIGNED_128;
  wire       [31:0]   _zz__zz_decode_IS_RS2_SIGNED_129;
  wire                _zz_RegFilePlugin_regFile_port;
  wire                _zz_decode_RegFilePlugin_rs1Data;
  wire                _zz_RegFilePlugin_regFile_port_1;
  wire                _zz_decode_RegFilePlugin_rs2Data;
  wire       [0:0]    _zz__zz_execute_REGFILE_WRITE_DATA;
  wire       [2:0]    _zz__zz_execute_SRC1;
  wire       [4:0]    _zz__zz_execute_SRC1_1;
  wire       [11:0]   _zz__zz_execute_SRC2_2;
  wire       [31:0]   _zz_execute_SrcPlugin_addSub;
  wire       [31:0]   _zz_execute_SrcPlugin_addSub_1;
  wire       [31:0]   _zz_execute_SrcPlugin_addSub_2;
  wire       [31:0]   _zz_execute_SrcPlugin_addSub_3;
  wire       [31:0]   _zz_execute_SrcPlugin_addSub_4;
  wire       [19:0]   _zz__zz_execute_BranchPlugin_missAlignedTarget_2;
  wire       [11:0]   _zz__zz_execute_BranchPlugin_missAlignedTarget_4;
  wire       [31:0]   _zz__zz_execute_BranchPlugin_missAlignedTarget_6;
  wire       [31:0]   _zz__zz_execute_BranchPlugin_missAlignedTarget_6_1;
  wire       [31:0]   _zz__zz_execute_BranchPlugin_missAlignedTarget_6_2;
  wire       [19:0]   _zz__zz_execute_BranchPlugin_branch_src2_2;
  wire       [11:0]   _zz__zz_execute_BranchPlugin_branch_src2_4;
  wire                _zz_execute_BranchPlugin_branch_src2_6;
  wire                _zz_execute_BranchPlugin_branch_src2_7;
  wire                _zz_execute_BranchPlugin_branch_src2_8;
  wire       [2:0]    _zz_execute_BranchPlugin_branch_src2_9;
  wire       [1:0]    _zz__zz_CsrPlugin_exceptionPortCtrl_exceptionContext_code_1;
  wire       [1:0]    _zz__zz_CsrPlugin_exceptionPortCtrl_exceptionContext_code_1_1;
  wire                _zz_when;
  wire       [65:0]   _zz_writeBack_MulPlugin_result;
  wire       [65:0]   _zz_writeBack_MulPlugin_result_1;
  wire       [31:0]   _zz__zz_decode_RS2_2;
  wire       [31:0]   _zz__zz_decode_RS2_2_1;
  wire       [5:0]    _zz_memory_DivPlugin_div_counter_valueNext;
  wire       [0:0]    _zz_memory_DivPlugin_div_counter_valueNext_1;
  wire       [32:0]   _zz_memory_DivPlugin_div_stage_0_remainderMinusDenominator;
  wire       [31:0]   _zz_memory_DivPlugin_div_stage_0_outRemainder;
  wire       [31:0]   _zz_memory_DivPlugin_div_stage_0_outRemainder_1;
  wire       [32:0]   _zz_memory_DivPlugin_div_stage_0_outNumerator;
  wire       [32:0]   _zz_memory_DivPlugin_div_result_1;
  wire       [32:0]   _zz_memory_DivPlugin_div_result_2;
  wire       [32:0]   _zz_memory_DivPlugin_div_result_3;
  wire       [32:0]   _zz_memory_DivPlugin_div_result_4;
  wire       [0:0]    _zz_memory_DivPlugin_div_result_5;
  wire       [32:0]   _zz_memory_DivPlugin_rs1_2;
  wire       [0:0]    _zz_memory_DivPlugin_rs1_3;
  wire       [31:0]   _zz_memory_DivPlugin_rs2_1;
  wire       [0:0]    _zz_memory_DivPlugin_rs2_2;
  wire       [26:0]   _zz_iBusWishbone_ADR_1;
  wire       [51:0]   memory_MUL_LOW;
  wire       [33:0]   memory_MUL_HH;
  wire       [33:0]   execute_MUL_HH;
  wire       [33:0]   execute_MUL_HL;
  wire       [33:0]   execute_MUL_LH;
  wire       [31:0]   execute_MUL_LL;
  wire       [31:0]   execute_BRANCH_CALC;
  wire                execute_BRANCH_DO;
  wire       [31:0]   execute_SHIFT_RIGHT;
  wire       [31:0]   execute_REGFILE_WRITE_DATA;
  wire       [31:0]   memory_MEMORY_STORE_DATA_RF;
  wire       [31:0]   execute_MEMORY_STORE_DATA_RF;
  wire                decode_CSR_READ_OPCODE;
  wire                decode_CSR_WRITE_OPCODE;
  wire                decode_PREDICTION_HAD_BRANCHED2;
  wire                decode_SRC2_FORCE_ZERO;
  wire                decode_IS_RS2_SIGNED;
  wire                decode_IS_RS1_SIGNED;
  wire                decode_IS_DIV;
  wire                memory_IS_MUL;
  wire                execute_IS_MUL;
  wire                decode_IS_MUL;
  wire       [1:0]    _zz_memory_to_writeBack_ENV_CTRL;
  wire       [1:0]    _zz_memory_to_writeBack_ENV_CTRL_1;
  wire       [1:0]    _zz_execute_to_memory_ENV_CTRL;
  wire       [1:0]    _zz_execute_to_memory_ENV_CTRL_1;
  wire       [1:0]    decode_ENV_CTRL;
  wire       [1:0]    _zz_decode_ENV_CTRL;
  wire       [1:0]    _zz_decode_to_execute_ENV_CTRL;
  wire       [1:0]    _zz_decode_to_execute_ENV_CTRL_1;
  wire                decode_IS_CSR;
  wire       [1:0]    _zz_decode_to_execute_BRANCH_CTRL;
  wire       [1:0]    _zz_decode_to_execute_BRANCH_CTRL_1;
  wire       [1:0]    _zz_execute_to_memory_SHIFT_CTRL;
  wire       [1:0]    _zz_execute_to_memory_SHIFT_CTRL_1;
  wire       [1:0]    decode_SHIFT_CTRL;
  wire       [1:0]    _zz_decode_SHIFT_CTRL;
  wire       [1:0]    _zz_decode_to_execute_SHIFT_CTRL;
  wire       [1:0]    _zz_decode_to_execute_SHIFT_CTRL_1;
  wire       [1:0]    decode_ALU_BITWISE_CTRL;
  wire       [1:0]    _zz_decode_ALU_BITWISE_CTRL;
  wire       [1:0]    _zz_decode_to_execute_ALU_BITWISE_CTRL;
  wire       [1:0]    _zz_decode_to_execute_ALU_BITWISE_CTRL_1;
  wire                decode_SRC_LESS_UNSIGNED;
  wire                decode_MEMORY_MANAGMENT;
  wire                memory_MEMORY_WR;
  wire                decode_MEMORY_WR;
  wire                execute_BYPASSABLE_MEMORY_STAGE;
  wire                decode_BYPASSABLE_MEMORY_STAGE;
  wire                decode_BYPASSABLE_EXECUTE_STAGE;
  wire       [1:0]    decode_SRC2_CTRL;
  wire       [1:0]    _zz_decode_SRC2_CTRL;
  wire       [1:0]    _zz_decode_to_execute_SRC2_CTRL;
  wire       [1:0]    _zz_decode_to_execute_SRC2_CTRL_1;
  wire       [1:0]    decode_ALU_CTRL;
  wire       [1:0]    _zz_decode_ALU_CTRL;
  wire       [1:0]    _zz_decode_to_execute_ALU_CTRL;
  wire       [1:0]    _zz_decode_to_execute_ALU_CTRL_1;
  wire       [1:0]    decode_SRC1_CTRL;
  wire       [1:0]    _zz_decode_SRC1_CTRL;
  wire       [1:0]    _zz_decode_to_execute_SRC1_CTRL;
  wire       [1:0]    _zz_decode_to_execute_SRC1_CTRL_1;
  wire                decode_MEMORY_FORCE_CONSTISTENCY;
  wire       [31:0]   writeBack_FORMAL_PC_NEXT;
  wire       [31:0]   memory_FORMAL_PC_NEXT;
  wire       [31:0]   execute_FORMAL_PC_NEXT;
  wire       [31:0]   decode_FORMAL_PC_NEXT;
  wire       [31:0]   memory_PC;
  wire                execute_IS_RS1_SIGNED;
  wire                execute_IS_DIV;
  wire                execute_IS_RS2_SIGNED;
  wire                memory_IS_DIV;
  wire                writeBack_IS_MUL;
  wire       [33:0]   writeBack_MUL_HH;
  wire       [51:0]   writeBack_MUL_LOW;
  wire       [33:0]   memory_MUL_HL;
  wire       [33:0]   memory_MUL_LH;
  wire       [31:0]   memory_MUL_LL;
  wire                execute_CSR_READ_OPCODE;
  wire                execute_CSR_WRITE_OPCODE;
  wire                execute_IS_CSR;
  wire       [1:0]    memory_ENV_CTRL;
  wire       [1:0]    _zz_memory_ENV_CTRL;
  wire       [1:0]    execute_ENV_CTRL;
  wire       [1:0]    _zz_execute_ENV_CTRL;
  wire       [1:0]    writeBack_ENV_CTRL;
  wire       [1:0]    _zz_writeBack_ENV_CTRL;
  wire       [31:0]   memory_BRANCH_CALC;
  wire                memory_BRANCH_DO;
  wire       [31:0]   execute_PC;
  wire                execute_PREDICTION_HAD_BRANCHED2;
  wire                execute_BRANCH_COND_RESULT;
  wire       [1:0]    execute_BRANCH_CTRL;
  wire       [1:0]    _zz_execute_BRANCH_CTRL;
  wire                decode_RS2_USE;
  wire                decode_RS1_USE;
  reg        [31:0]   _zz_decode_RS2;
  wire                execute_REGFILE_WRITE_VALID;
  wire                execute_BYPASSABLE_EXECUTE_STAGE;
  wire                memory_REGFILE_WRITE_VALID;
  wire       [31:0]   memory_INSTRUCTION;
  wire                memory_BYPASSABLE_MEMORY_STAGE;
  wire                writeBack_REGFILE_WRITE_VALID;
  reg        [31:0]   decode_RS2;
  reg        [31:0]   decode_RS1;
  wire       [31:0]   memory_SHIFT_RIGHT;
  reg        [31:0]   _zz_decode_RS2_1;
  wire       [1:0]    memory_SHIFT_CTRL;
  wire       [1:0]    _zz_memory_SHIFT_CTRL;
  wire       [1:0]    execute_SHIFT_CTRL;
  wire       [1:0]    _zz_execute_SHIFT_CTRL;
  wire                execute_SRC_LESS_UNSIGNED;
  wire                execute_SRC2_FORCE_ZERO;
  wire                execute_SRC_USE_SUB_LESS;
  wire       [31:0]   _zz_execute_to_memory_PC;
  wire       [1:0]    execute_SRC2_CTRL;
  wire       [1:0]    _zz_execute_SRC2_CTRL;
  wire       [1:0]    execute_SRC1_CTRL;
  wire       [1:0]    _zz_execute_SRC1_CTRL;
  wire                decode_SRC_USE_SUB_LESS;
  wire                decode_SRC_ADD_ZERO;
  wire       [31:0]   execute_SRC_ADD_SUB;
  wire                execute_SRC_LESS;
  wire       [1:0]    execute_ALU_CTRL;
  wire       [1:0]    _zz_execute_ALU_CTRL;
  wire       [31:0]   execute_SRC2;
  wire       [31:0]   execute_SRC1;
  wire       [1:0]    execute_ALU_BITWISE_CTRL;
  wire       [1:0]    _zz_execute_ALU_BITWISE_CTRL;
  wire       [31:0]   _zz_lastStageRegFileWrite_payload_address;
  wire                _zz_lastStageRegFileWrite_valid;
  reg                 _zz_1;
  wire       [31:0]   decode_INSTRUCTION_ANTICIPATED;
  reg                 decode_REGFILE_WRITE_VALID;
  wire                decode_LEGAL_INSTRUCTION;
  wire       [1:0]    _zz_decode_ENV_CTRL_1;
  wire       [1:0]    _zz_decode_BRANCH_CTRL;
  wire       [1:0]    _zz_decode_SHIFT_CTRL_1;
  wire       [1:0]    _zz_decode_ALU_BITWISE_CTRL_1;
  wire       [1:0]    _zz_decode_SRC2_CTRL_1;
  wire       [1:0]    _zz_decode_ALU_CTRL_1;
  wire       [1:0]    _zz_decode_SRC1_CTRL_1;
  reg        [31:0]   _zz_decode_RS2_2;
  wire                writeBack_MEMORY_WR;
  wire       [31:0]   writeBack_MEMORY_STORE_DATA_RF;
  wire       [31:0]   writeBack_REGFILE_WRITE_DATA;
  wire                writeBack_MEMORY_ENABLE;
  wire       [31:0]   memory_REGFILE_WRITE_DATA;
  wire                memory_MEMORY_ENABLE;
  wire                execute_MEMORY_FORCE_CONSTISTENCY;
  (* keep , syn_keep *) wire       [31:0]   execute_RS1 /* synthesis syn_keep = 1 */ ;
  wire                execute_MEMORY_MANAGMENT;
  (* keep , syn_keep *) wire       [31:0]   execute_RS2 /* synthesis syn_keep = 1 */ ;
  wire                execute_MEMORY_WR;
  wire       [31:0]   execute_SRC_ADD;
  wire                execute_MEMORY_ENABLE;
  wire       [31:0]   execute_INSTRUCTION;
  wire                decode_MEMORY_ENABLE;
  wire                decode_FLUSH_ALL;
  reg                 IBusCachedPlugin_rsp_issueDetected_4;
  reg                 IBusCachedPlugin_rsp_issueDetected_3;
  reg                 IBusCachedPlugin_rsp_issueDetected_2;
  reg                 IBusCachedPlugin_rsp_issueDetected_1;
  wire       [1:0]    decode_BRANCH_CTRL;
  wire       [1:0]    _zz_decode_BRANCH_CTRL_1;
  wire       [31:0]   decode_INSTRUCTION;
  reg        [31:0]   _zz_memory_to_writeBack_FORMAL_PC_NEXT;
  reg        [31:0]   _zz_decode_to_execute_FORMAL_PC_NEXT;
  wire       [31:0]   decode_PC;
  wire       [31:0]   writeBack_PC;
  wire       [31:0]   writeBack_INSTRUCTION;
  reg                 decode_arbitration_haltItself;
  reg                 decode_arbitration_haltByOther;
  reg                 decode_arbitration_removeIt;
  wire                decode_arbitration_flushIt;
  reg                 decode_arbitration_flushNext;
  reg                 decode_arbitration_isValid;
  wire                decode_arbitration_isStuck;
  wire                decode_arbitration_isStuckByOthers;
  wire                decode_arbitration_isFlushed;
  wire                decode_arbitration_isMoving;
  wire                decode_arbitration_isFiring;
  reg                 execute_arbitration_haltItself;
  reg                 execute_arbitration_haltByOther;
  reg                 execute_arbitration_removeIt;
  wire                execute_arbitration_flushIt;
  reg                 execute_arbitration_flushNext;
  reg                 execute_arbitration_isValid;
  wire                execute_arbitration_isStuck;
  wire                execute_arbitration_isStuckByOthers;
  wire                execute_arbitration_isFlushed;
  wire                execute_arbitration_isMoving;
  wire                execute_arbitration_isFiring;
  reg                 memory_arbitration_haltItself;
  wire                memory_arbitration_haltByOther;
  reg                 memory_arbitration_removeIt;
  wire                memory_arbitration_flushIt;
  reg                 memory_arbitration_flushNext;
  reg                 memory_arbitration_isValid;
  wire                memory_arbitration_isStuck;
  wire                memory_arbitration_isStuckByOthers;
  wire                memory_arbitration_isFlushed;
  wire                memory_arbitration_isMoving;
  wire                memory_arbitration_isFiring;
  reg                 writeBack_arbitration_haltItself;
  wire                writeBack_arbitration_haltByOther;
  reg                 writeBack_arbitration_removeIt;
  reg                 writeBack_arbitration_flushIt;
  reg                 writeBack_arbitration_flushNext;
  reg                 writeBack_arbitration_isValid;
  wire                writeBack_arbitration_isStuck;
  wire                writeBack_arbitration_isStuckByOthers;
  wire                writeBack_arbitration_isFlushed;
  wire                writeBack_arbitration_isMoving;
  wire                writeBack_arbitration_isFiring;
  wire       [31:0]   lastStageInstruction /* verilator public */ ;
  wire       [31:0]   lastStagePc /* verilator public */ ;
  wire                lastStageIsValid /* verilator public */ ;
  wire                lastStageIsFiring /* verilator public */ ;
  reg                 IBusCachedPlugin_fetcherHalt;
  wire                IBusCachedPlugin_forceNoDecodeCond;
  reg                 IBusCachedPlugin_incomingInstruction;
  wire                IBusCachedPlugin_predictionJumpInterface_valid;
  (* keep , syn_keep *) wire       [31:0]   IBusCachedPlugin_predictionJumpInterface_payload /* synthesis syn_keep = 1 */ ;
  reg                 IBusCachedPlugin_decodePrediction_cmd_hadBranch;
  wire                IBusCachedPlugin_decodePrediction_rsp_wasWrong;
  wire                IBusCachedPlugin_pcValids_0;
  wire                IBusCachedPlugin_pcValids_1;
  wire                IBusCachedPlugin_pcValids_2;
  wire                IBusCachedPlugin_pcValids_3;
  reg                 IBusCachedPlugin_decodeExceptionPort_valid;
  reg        [3:0]    IBusCachedPlugin_decodeExceptionPort_payload_code;
  wire       [31:0]   IBusCachedPlugin_decodeExceptionPort_payload_badAddr;
  wire                IBusCachedPlugin_mmuBus_cmd_0_isValid;
  wire                IBusCachedPlugin_mmuBus_cmd_0_isStuck;
  wire       [31:0]   IBusCachedPlugin_mmuBus_cmd_0_virtualAddress;
  wire                IBusCachedPlugin_mmuBus_cmd_0_bypassTranslation;
  wire       [31:0]   IBusCachedPlugin_mmuBus_rsp_physicalAddress;
  wire                IBusCachedPlugin_mmuBus_rsp_isIoAccess;
  wire                IBusCachedPlugin_mmuBus_rsp_isPaging;
  wire                IBusCachedPlugin_mmuBus_rsp_allowRead;
  wire                IBusCachedPlugin_mmuBus_rsp_allowWrite;
  wire                IBusCachedPlugin_mmuBus_rsp_allowExecute;
  wire                IBusCachedPlugin_mmuBus_rsp_exception;
  wire                IBusCachedPlugin_mmuBus_rsp_refilling;
  wire                IBusCachedPlugin_mmuBus_rsp_bypassTranslation;
  wire                IBusCachedPlugin_mmuBus_end;
  wire                IBusCachedPlugin_mmuBus_busy;
  wire                dBus_cmd_valid;
  wire                dBus_cmd_ready;
  wire                dBus_cmd_payload_wr;
  wire                dBus_cmd_payload_uncached;
  wire       [31:0]   dBus_cmd_payload_address;
  wire       [31:0]   dBus_cmd_payload_data;
  wire       [3:0]    dBus_cmd_payload_mask;
  wire       [2:0]    dBus_cmd_payload_size;
  wire                dBus_cmd_payload_last;
  wire                dBus_rsp_valid;
  wire                dBus_rsp_payload_last;
  wire       [31:0]   dBus_rsp_payload_data;
  wire                dBus_rsp_payload_error;
  wire                DBusCachedPlugin_mmuBus_cmd_0_isValid;
  wire                DBusCachedPlugin_mmuBus_cmd_0_isStuck;
  wire       [31:0]   DBusCachedPlugin_mmuBus_cmd_0_virtualAddress;
  wire                DBusCachedPlugin_mmuBus_cmd_0_bypassTranslation;
  wire       [31:0]   DBusCachedPlugin_mmuBus_rsp_physicalAddress;
  wire                DBusCachedPlugin_mmuBus_rsp_isIoAccess;
  wire                DBusCachedPlugin_mmuBus_rsp_isPaging;
  wire                DBusCachedPlugin_mmuBus_rsp_allowRead;
  wire                DBusCachedPlugin_mmuBus_rsp_allowWrite;
  wire                DBusCachedPlugin_mmuBus_rsp_allowExecute;
  wire                DBusCachedPlugin_mmuBus_rsp_exception;
  wire                DBusCachedPlugin_mmuBus_rsp_refilling;
  wire                DBusCachedPlugin_mmuBus_rsp_bypassTranslation;
  wire                DBusCachedPlugin_mmuBus_end;
  wire                DBusCachedPlugin_mmuBus_busy;
  reg                 DBusCachedPlugin_redoBranch_valid;
  wire       [31:0]   DBusCachedPlugin_redoBranch_payload;
  reg                 DBusCachedPlugin_exceptionBus_valid;
  reg        [3:0]    DBusCachedPlugin_exceptionBus_payload_code;
  wire       [31:0]   DBusCachedPlugin_exceptionBus_payload_badAddr;
  wire                decodeExceptionPort_valid;
  wire       [3:0]    decodeExceptionPort_payload_code;
  wire       [31:0]   decodeExceptionPort_payload_badAddr;
  wire                BranchPlugin_jumpInterface_valid;
  wire       [31:0]   BranchPlugin_jumpInterface_payload;
  wire                BranchPlugin_branchExceptionPort_valid;
  wire       [3:0]    BranchPlugin_branchExceptionPort_payload_code;
  wire       [31:0]   BranchPlugin_branchExceptionPort_payload_badAddr;
  wire                BranchPlugin_inDebugNoFetchFlag;
  wire       [31:0]   CsrPlugin_csrMapping_readDataSignal;
  wire       [31:0]   CsrPlugin_csrMapping_readDataInit;
  wire       [31:0]   CsrPlugin_csrMapping_writeDataSignal;
  reg                 CsrPlugin_csrMapping_allowCsrSignal;
  wire                CsrPlugin_csrMapping_hazardFree;
  wire                CsrPlugin_csrMapping_doForceFailCsr;
  wire                CsrPlugin_inWfi /* verilator public */ ;
  wire                CsrPlugin_thirdPartyWake;
  reg                 CsrPlugin_jumpInterface_valid;
  reg        [31:0]   CsrPlugin_jumpInterface_payload;
  wire                CsrPlugin_exceptionPendings_0;
  wire                CsrPlugin_exceptionPendings_1;
  wire                CsrPlugin_exceptionPendings_2;
  wire                CsrPlugin_exceptionPendings_3;
  wire                externalInterrupt;
  wire                contextSwitching;
  reg        [1:0]    CsrPlugin_privilege;
  wire                CsrPlugin_forceMachineWire;
  reg                 CsrPlugin_selfException_valid;
  reg        [3:0]    CsrPlugin_selfException_payload_code;
  wire       [31:0]   CsrPlugin_selfException_payload_badAddr;
  wire                CsrPlugin_allowInterrupts;
  wire                CsrPlugin_allowException;
  wire                CsrPlugin_allowEbreakException;
  wire                CsrPlugin_xretAwayFromMachine;
  wire                IBusCachedPlugin_externalFlush;
  wire                IBusCachedPlugin_jump_pcLoad_valid;
  wire       [31:0]   IBusCachedPlugin_jump_pcLoad_payload;
  wire       [3:0]    _zz_IBusCachedPlugin_jump_pcLoad_payload;
  wire       [3:0]    _zz_IBusCachedPlugin_jump_pcLoad_payload_1;
  wire                _zz_IBusCachedPlugin_jump_pcLoad_payload_2;
  wire                _zz_IBusCachedPlugin_jump_pcLoad_payload_3;
  wire                _zz_IBusCachedPlugin_jump_pcLoad_payload_4;
  wire                IBusCachedPlugin_fetchPc_output_valid;
  wire                IBusCachedPlugin_fetchPc_output_ready;
  wire       [31:0]   IBusCachedPlugin_fetchPc_output_payload;
  reg        [31:0]   IBusCachedPlugin_fetchPc_pcReg /* verilator public */ ;
  reg                 IBusCachedPlugin_fetchPc_correction;
  reg                 IBusCachedPlugin_fetchPc_correctionReg;
  wire                IBusCachedPlugin_fetchPc_output_fire;
  wire                IBusCachedPlugin_fetchPc_corrected;
  reg                 IBusCachedPlugin_fetchPc_pcRegPropagate;
  reg                 IBusCachedPlugin_fetchPc_booted;
  reg                 IBusCachedPlugin_fetchPc_inc;
  wire                when_Fetcher_l133;
  wire                when_Fetcher_l133_1;
  reg        [31:0]   IBusCachedPlugin_fetchPc_pc;
  wire                IBusCachedPlugin_fetchPc_redo_valid;
  wire       [31:0]   IBusCachedPlugin_fetchPc_redo_payload;
  reg                 IBusCachedPlugin_fetchPc_flushed;
  wire                when_Fetcher_l160;
  reg                 IBusCachedPlugin_iBusRsp_redoFetch;
  wire                IBusCachedPlugin_iBusRsp_stages_0_input_valid;
  wire                IBusCachedPlugin_iBusRsp_stages_0_input_ready;
  wire       [31:0]   IBusCachedPlugin_iBusRsp_stages_0_input_payload;
  wire                IBusCachedPlugin_iBusRsp_stages_0_output_valid;
  wire                IBusCachedPlugin_iBusRsp_stages_0_output_ready;
  wire       [31:0]   IBusCachedPlugin_iBusRsp_stages_0_output_payload;
  reg                 IBusCachedPlugin_iBusRsp_stages_0_halt;
  wire                IBusCachedPlugin_iBusRsp_stages_1_input_valid;
  wire                IBusCachedPlugin_iBusRsp_stages_1_input_ready;
  wire       [31:0]   IBusCachedPlugin_iBusRsp_stages_1_input_payload;
  wire                IBusCachedPlugin_iBusRsp_stages_1_output_valid;
  wire                IBusCachedPlugin_iBusRsp_stages_1_output_ready;
  wire       [31:0]   IBusCachedPlugin_iBusRsp_stages_1_output_payload;
  reg                 IBusCachedPlugin_iBusRsp_stages_1_halt;
  wire                IBusCachedPlugin_iBusRsp_stages_2_input_valid;
  wire                IBusCachedPlugin_iBusRsp_stages_2_input_ready;
  wire       [31:0]   IBusCachedPlugin_iBusRsp_stages_2_input_payload;
  wire                IBusCachedPlugin_iBusRsp_stages_2_output_valid;
  wire                IBusCachedPlugin_iBusRsp_stages_2_output_ready;
  wire       [31:0]   IBusCachedPlugin_iBusRsp_stages_2_output_payload;
  reg                 IBusCachedPlugin_iBusRsp_stages_2_halt;
  wire                _zz_IBusCachedPlugin_iBusRsp_stages_0_input_ready;
  wire                _zz_IBusCachedPlugin_iBusRsp_stages_1_input_ready;
  wire                _zz_IBusCachedPlugin_iBusRsp_stages_2_input_ready;
  wire                IBusCachedPlugin_iBusRsp_flush;
  wire                _zz_IBusCachedPlugin_iBusRsp_stages_0_output_ready;
  wire                _zz_IBusCachedPlugin_iBusRsp_stages_1_input_valid;
  reg                 _zz_IBusCachedPlugin_iBusRsp_stages_1_input_valid_1;
  wire                IBusCachedPlugin_iBusRsp_stages_1_output_m2sPipe_valid;
  wire                IBusCachedPlugin_iBusRsp_stages_1_output_m2sPipe_ready;
  wire       [31:0]   IBusCachedPlugin_iBusRsp_stages_1_output_m2sPipe_payload;
  reg                 _zz_IBusCachedPlugin_iBusRsp_stages_1_output_m2sPipe_valid;
  reg        [31:0]   _zz_IBusCachedPlugin_iBusRsp_stages_1_output_m2sPipe_payload;
  reg                 IBusCachedPlugin_iBusRsp_readyForError;
  wire                IBusCachedPlugin_iBusRsp_output_valid;
  wire                IBusCachedPlugin_iBusRsp_output_ready;
  wire       [31:0]   IBusCachedPlugin_iBusRsp_output_payload_pc;
  wire                IBusCachedPlugin_iBusRsp_output_payload_rsp_error;
  wire       [31:0]   IBusCachedPlugin_iBusRsp_output_payload_rsp_inst;
  wire                IBusCachedPlugin_iBusRsp_output_payload_isRvc;
  wire                when_Fetcher_l242;
  wire                when_Fetcher_l322;
  reg                 IBusCachedPlugin_injector_nextPcCalc_valids_0;
  wire                when_Fetcher_l331;
  reg                 IBusCachedPlugin_injector_nextPcCalc_valids_1;
  wire                when_Fetcher_l331_1;
  reg                 IBusCachedPlugin_injector_nextPcCalc_valids_2;
  wire                when_Fetcher_l331_2;
  reg                 IBusCachedPlugin_injector_nextPcCalc_valids_3;
  wire                when_Fetcher_l331_3;
  reg                 IBusCachedPlugin_injector_nextPcCalc_valids_4;
  wire                when_Fetcher_l331_4;
  wire                _zz_IBusCachedPlugin_decodePrediction_cmd_hadBranch;
  reg        [18:0]   _zz_IBusCachedPlugin_decodePrediction_cmd_hadBranch_1;
  wire                _zz_2;
  reg        [10:0]   _zz_3;
  wire                _zz_4;
  reg        [18:0]   _zz_5;
  reg                 _zz_6;
  wire                _zz_IBusCachedPlugin_predictionJumpInterface_payload;
  reg        [10:0]   _zz_IBusCachedPlugin_predictionJumpInterface_payload_1;
  wire                _zz_IBusCachedPlugin_predictionJumpInterface_payload_2;
  reg        [18:0]   _zz_IBusCachedPlugin_predictionJumpInterface_payload_3;
  wire                iBus_cmd_valid;
  wire                iBus_cmd_ready;
  reg        [31:0]   iBus_cmd_payload_address;
  wire       [2:0]    iBus_cmd_payload_size;
  wire                iBus_rsp_valid;
  wire       [31:0]   iBus_rsp_payload_data;
  wire                iBus_rsp_payload_error;
  reg        [31:0]   IBusCachedPlugin_rspCounter;
  wire                IBusCachedPlugin_s0_tightlyCoupledHit;
  reg                 IBusCachedPlugin_s1_tightlyCoupledHit;
  reg                 IBusCachedPlugin_s2_tightlyCoupledHit;
  wire                IBusCachedPlugin_rsp_iBusRspOutputHalt;
  wire                IBusCachedPlugin_rsp_issueDetected;
  reg                 IBusCachedPlugin_rsp_redoFetch;
  wire                when_IBusCachedPlugin_l245;
  wire                when_IBusCachedPlugin_l250;
  wire                when_IBusCachedPlugin_l256;
  wire                when_IBusCachedPlugin_l262;
  wire                when_IBusCachedPlugin_l273;
  wire                toplevel_dataCache_1_io_mem_cmd_s2mPipe_valid;
  reg                 toplevel_dataCache_1_io_mem_cmd_s2mPipe_ready;
  wire                toplevel_dataCache_1_io_mem_cmd_s2mPipe_payload_wr;
  wire                toplevel_dataCache_1_io_mem_cmd_s2mPipe_payload_uncached;
  wire       [31:0]   toplevel_dataCache_1_io_mem_cmd_s2mPipe_payload_address;
  wire       [31:0]   toplevel_dataCache_1_io_mem_cmd_s2mPipe_payload_data;
  wire       [3:0]    toplevel_dataCache_1_io_mem_cmd_s2mPipe_payload_mask;
  wire       [2:0]    toplevel_dataCache_1_io_mem_cmd_s2mPipe_payload_size;
  wire                toplevel_dataCache_1_io_mem_cmd_s2mPipe_payload_last;
  reg                 toplevel_dataCache_1_io_mem_cmd_rValidN;
  reg                 toplevel_dataCache_1_io_mem_cmd_rData_wr;
  reg                 toplevel_dataCache_1_io_mem_cmd_rData_uncached;
  reg        [31:0]   toplevel_dataCache_1_io_mem_cmd_rData_address;
  reg        [31:0]   toplevel_dataCache_1_io_mem_cmd_rData_data;
  reg        [3:0]    toplevel_dataCache_1_io_mem_cmd_rData_mask;
  reg        [2:0]    toplevel_dataCache_1_io_mem_cmd_rData_size;
  reg                 toplevel_dataCache_1_io_mem_cmd_rData_last;
  wire                toplevel_dataCache_1_io_mem_cmd_s2mPipe_m2sPipe_valid;
  wire                toplevel_dataCache_1_io_mem_cmd_s2mPipe_m2sPipe_ready;
  wire                toplevel_dataCache_1_io_mem_cmd_s2mPipe_m2sPipe_payload_wr;
  wire                toplevel_dataCache_1_io_mem_cmd_s2mPipe_m2sPipe_payload_uncached;
  wire       [31:0]   toplevel_dataCache_1_io_mem_cmd_s2mPipe_m2sPipe_payload_address;
  wire       [31:0]   toplevel_dataCache_1_io_mem_cmd_s2mPipe_m2sPipe_payload_data;
  wire       [3:0]    toplevel_dataCache_1_io_mem_cmd_s2mPipe_m2sPipe_payload_mask;
  wire       [2:0]    toplevel_dataCache_1_io_mem_cmd_s2mPipe_m2sPipe_payload_size;
  wire                toplevel_dataCache_1_io_mem_cmd_s2mPipe_m2sPipe_payload_last;
  reg                 toplevel_dataCache_1_io_mem_cmd_s2mPipe_rValid;
  reg                 toplevel_dataCache_1_io_mem_cmd_s2mPipe_rData_wr;
  reg                 toplevel_dataCache_1_io_mem_cmd_s2mPipe_rData_uncached;
  reg        [31:0]   toplevel_dataCache_1_io_mem_cmd_s2mPipe_rData_address;
  reg        [31:0]   toplevel_dataCache_1_io_mem_cmd_s2mPipe_rData_data;
  reg        [3:0]    toplevel_dataCache_1_io_mem_cmd_s2mPipe_rData_mask;
  reg        [2:0]    toplevel_dataCache_1_io_mem_cmd_s2mPipe_rData_size;
  reg                 toplevel_dataCache_1_io_mem_cmd_s2mPipe_rData_last;
  wire                when_Stream_l369;
  reg        [31:0]   DBusCachedPlugin_rspCounter;
  wire                when_DBusCachedPlugin_l352;
  wire       [1:0]    execute_DBusCachedPlugin_size;
  reg        [31:0]   _zz_execute_MEMORY_STORE_DATA_RF;
  wire                toplevel_dataCache_1_io_cpu_flush_isStall;
  wire                when_DBusCachedPlugin_l394;
  wire                when_DBusCachedPlugin_l410;
  wire                when_DBusCachedPlugin_l472;
  wire                when_DBusCachedPlugin_l533;
  wire                when_DBusCachedPlugin_l553;
  wire       [31:0]   writeBack_DBusCachedPlugin_rspData;
  wire       [7:0]    writeBack_DBusCachedPlugin_rspSplits_0;
  wire       [7:0]    writeBack_DBusCachedPlugin_rspSplits_1;
  wire       [7:0]    writeBack_DBusCachedPlugin_rspSplits_2;
  wire       [7:0]    writeBack_DBusCachedPlugin_rspSplits_3;
  reg        [31:0]   writeBack_DBusCachedPlugin_rspShifted;
  wire       [31:0]   writeBack_DBusCachedPlugin_rspRf;
  wire       [1:0]    switch_Misc_l232;
  wire                _zz_writeBack_DBusCachedPlugin_rspFormated;
  reg        [31:0]   _zz_writeBack_DBusCachedPlugin_rspFormated_1;
  wire                _zz_writeBack_DBusCachedPlugin_rspFormated_2;
  reg        [31:0]   _zz_writeBack_DBusCachedPlugin_rspFormated_3;
  reg        [31:0]   writeBack_DBusCachedPlugin_rspFormated;
  wire                when_DBusCachedPlugin_l580;
  wire       [31:0]   _zz_decode_IS_RS2_SIGNED;
  wire                _zz_decode_IS_RS2_SIGNED_1;
  wire                _zz_decode_IS_RS2_SIGNED_2;
  wire                _zz_decode_IS_RS2_SIGNED_3;
  wire                _zz_decode_IS_RS2_SIGNED_4;
  wire                _zz_decode_IS_RS2_SIGNED_5;
  wire       [1:0]    _zz_decode_SRC1_CTRL_2;
  wire       [1:0]    _zz_decode_ALU_CTRL_2;
  wire       [1:0]    _zz_decode_SRC2_CTRL_2;
  wire       [1:0]    _zz_decode_ALU_BITWISE_CTRL_2;
  wire       [1:0]    _zz_decode_SHIFT_CTRL_2;
  wire       [1:0]    _zz_decode_BRANCH_CTRL_2;
  wire       [1:0]    _zz_decode_ENV_CTRL_2;
  wire                when_RegFilePlugin_l63;
  wire       [4:0]    decode_RegFilePlugin_regFileReadAddress1;
  wire       [4:0]    decode_RegFilePlugin_regFileReadAddress2;
  wire       [31:0]   decode_RegFilePlugin_rs1Data;
  wire       [31:0]   decode_RegFilePlugin_rs2Data;
  reg                 lastStageRegFileWrite_valid /* verilator public */ ;
  reg        [4:0]    lastStageRegFileWrite_payload_address /* verilator public */ ;
  reg        [31:0]   lastStageRegFileWrite_payload_data /* verilator public */ ;
  reg                 _zz_10;
  reg        [31:0]   execute_IntAluPlugin_bitwise;
  reg        [31:0]   _zz_execute_REGFILE_WRITE_DATA;
  reg        [31:0]   _zz_execute_SRC1;
  wire                _zz_execute_SRC2;
  reg        [19:0]   _zz_execute_SRC2_1;
  wire                _zz_execute_SRC2_2;
  reg        [19:0]   _zz_execute_SRC2_3;
  reg        [31:0]   _zz_execute_SRC2_4;
  reg        [31:0]   execute_SrcPlugin_addSub;
  wire                execute_SrcPlugin_less;
  wire       [4:0]    execute_FullBarrelShifterPlugin_amplitude;
  reg        [31:0]   _zz_execute_FullBarrelShifterPlugin_reversed;
  wire       [31:0]   execute_FullBarrelShifterPlugin_reversed;
  reg        [31:0]   _zz_decode_RS2_3;
  reg                 HazardSimplePlugin_src0Hazard;
  reg                 HazardSimplePlugin_src1Hazard;
  wire                HazardSimplePlugin_writeBackWrites_valid;
  wire       [4:0]    HazardSimplePlugin_writeBackWrites_payload_address;
  wire       [31:0]   HazardSimplePlugin_writeBackWrites_payload_data;
  reg                 HazardSimplePlugin_writeBackBuffer_valid;
  reg        [4:0]    HazardSimplePlugin_writeBackBuffer_payload_address;
  reg        [31:0]   HazardSimplePlugin_writeBackBuffer_payload_data;
  wire                HazardSimplePlugin_addr0Match;
  wire                HazardSimplePlugin_addr1Match;
  wire                when_HazardSimplePlugin_l47;
  wire                when_HazardSimplePlugin_l48;
  wire                when_HazardSimplePlugin_l51;
  wire                when_HazardSimplePlugin_l45;
  wire                when_HazardSimplePlugin_l57;
  wire                when_HazardSimplePlugin_l58;
  wire                when_HazardSimplePlugin_l48_1;
  wire                when_HazardSimplePlugin_l51_1;
  wire                when_HazardSimplePlugin_l45_1;
  wire                when_HazardSimplePlugin_l57_1;
  wire                when_HazardSimplePlugin_l58_1;
  wire                when_HazardSimplePlugin_l48_2;
  wire                when_HazardSimplePlugin_l51_2;
  wire                when_HazardSimplePlugin_l45_2;
  wire                when_HazardSimplePlugin_l57_2;
  wire                when_HazardSimplePlugin_l58_2;
  wire                when_HazardSimplePlugin_l105;
  wire                when_HazardSimplePlugin_l108;
  wire                when_HazardSimplePlugin_l113;
  wire                execute_BranchPlugin_eq;
  wire       [2:0]    switch_Misc_l232_1;
  reg                 _zz_execute_BRANCH_COND_RESULT;
  reg                 _zz_execute_BRANCH_COND_RESULT_1;
  wire                _zz_execute_BranchPlugin_missAlignedTarget;
  reg        [19:0]   _zz_execute_BranchPlugin_missAlignedTarget_1;
  wire                _zz_execute_BranchPlugin_missAlignedTarget_2;
  reg        [10:0]   _zz_execute_BranchPlugin_missAlignedTarget_3;
  wire                _zz_execute_BranchPlugin_missAlignedTarget_4;
  reg        [18:0]   _zz_execute_BranchPlugin_missAlignedTarget_5;
  reg                 _zz_execute_BranchPlugin_missAlignedTarget_6;
  wire                execute_BranchPlugin_missAlignedTarget;
  reg        [31:0]   execute_BranchPlugin_branch_src1;
  reg        [31:0]   execute_BranchPlugin_branch_src2;
  wire                _zz_execute_BranchPlugin_branch_src2;
  reg        [19:0]   _zz_execute_BranchPlugin_branch_src2_1;
  wire                _zz_execute_BranchPlugin_branch_src2_2;
  reg        [10:0]   _zz_execute_BranchPlugin_branch_src2_3;
  wire                _zz_execute_BranchPlugin_branch_src2_4;
  reg        [18:0]   _zz_execute_BranchPlugin_branch_src2_5;
  wire       [31:0]   execute_BranchPlugin_branchAdder;
  wire       [1:0]    CsrPlugin_misa_base;
  wire       [25:0]   CsrPlugin_misa_extensions;
  reg        [1:0]    CsrPlugin_mtvec_mode;
  reg        [29:0]   CsrPlugin_mtvec_base;
  reg        [31:0]   CsrPlugin_mepc;
  reg                 CsrPlugin_mstatus_MIE;
  reg                 CsrPlugin_mstatus_MPIE;
  reg        [1:0]    CsrPlugin_mstatus_MPP;
  reg                 CsrPlugin_mip_MEIP;
  reg                 CsrPlugin_mip_MTIP;
  reg                 CsrPlugin_mip_MSIP;
  reg                 CsrPlugin_mie_MEIE;
  reg                 CsrPlugin_mie_MTIE;
  reg                 CsrPlugin_mie_MSIE;
  reg                 CsrPlugin_mcause_interrupt;
  reg        [3:0]    CsrPlugin_mcause_exceptionCode;
  reg        [31:0]   CsrPlugin_mtval;
  reg        [63:0]   CsrPlugin_mcycle;
  reg        [63:0]   CsrPlugin_minstret;
  wire                _zz_when_CsrPlugin_l1302;
  wire                _zz_when_CsrPlugin_l1302_1;
  wire                _zz_when_CsrPlugin_l1302_2;
  reg                 CsrPlugin_exceptionPortCtrl_exceptionValids_decode;
  reg                 CsrPlugin_exceptionPortCtrl_exceptionValids_execute;
  reg                 CsrPlugin_exceptionPortCtrl_exceptionValids_memory;
  reg                 CsrPlugin_exceptionPortCtrl_exceptionValids_writeBack;
  reg                 CsrPlugin_exceptionPortCtrl_exceptionValidsRegs_decode;
  reg                 CsrPlugin_exceptionPortCtrl_exceptionValidsRegs_execute;
  reg                 CsrPlugin_exceptionPortCtrl_exceptionValidsRegs_memory;
  reg                 CsrPlugin_exceptionPortCtrl_exceptionValidsRegs_writeBack;
  reg        [3:0]    CsrPlugin_exceptionPortCtrl_exceptionContext_code;
  reg        [31:0]   CsrPlugin_exceptionPortCtrl_exceptionContext_badAddr;
  wire       [1:0]    CsrPlugin_exceptionPortCtrl_exceptionTargetPrivilegeUncapped;
  wire       [1:0]    CsrPlugin_exceptionPortCtrl_exceptionTargetPrivilege;
  wire       [1:0]    _zz_CsrPlugin_exceptionPortCtrl_exceptionContext_code;
  wire                _zz_CsrPlugin_exceptionPortCtrl_exceptionContext_code_1;
  wire                when_CsrPlugin_l1259;
  wire                when_CsrPlugin_l1259_1;
  wire                when_CsrPlugin_l1259_2;
  wire                when_CsrPlugin_l1259_3;
  wire                when_CsrPlugin_l1272;
  reg                 CsrPlugin_interrupt_valid;
  reg        [3:0]    CsrPlugin_interrupt_code /* verilator public */ ;
  reg        [1:0]    CsrPlugin_interrupt_targetPrivilege;
  wire                when_CsrPlugin_l1296;
  wire                when_CsrPlugin_l1302;
  wire                when_CsrPlugin_l1302_1;
  wire                when_CsrPlugin_l1302_2;
  wire                CsrPlugin_exception;
  wire                CsrPlugin_lastStageWasWfi;
  reg                 CsrPlugin_pipelineLiberator_pcValids_0;
  reg                 CsrPlugin_pipelineLiberator_pcValids_1;
  reg                 CsrPlugin_pipelineLiberator_pcValids_2;
  wire                CsrPlugin_pipelineLiberator_active;
  wire                when_CsrPlugin_l1335;
  wire                when_CsrPlugin_l1335_1;
  wire                when_CsrPlugin_l1335_2;
  wire                when_CsrPlugin_l1340;
  reg                 CsrPlugin_pipelineLiberator_done;
  wire                when_CsrPlugin_l1346;
  wire                CsrPlugin_interruptJump /* verilator public */ ;
  reg                 CsrPlugin_hadException /* verilator public */ ;
  reg        [1:0]    CsrPlugin_targetPrivilege;
  reg        [3:0]    CsrPlugin_trapCause;
  wire                CsrPlugin_trapCauseEbreakDebug;
  reg        [1:0]    CsrPlugin_xtvec_mode;
  reg        [29:0]   CsrPlugin_xtvec_base;
  wire                CsrPlugin_trapEnterDebug;
  wire                when_CsrPlugin_l1390;
  wire                when_CsrPlugin_l1398;
  wire                when_CsrPlugin_l1456;
  wire       [1:0]    switch_CsrPlugin_l1460;
  reg                 execute_CsrPlugin_wfiWake;
  wire                when_CsrPlugin_l1527;
  wire                execute_CsrPlugin_blockedBySideEffects;
  reg                 execute_CsrPlugin_illegalAccess;
  reg                 execute_CsrPlugin_illegalInstruction;
  wire                when_CsrPlugin_l1547;
  wire                when_CsrPlugin_l1548;
  wire                when_CsrPlugin_l1555;
  reg                 execute_CsrPlugin_writeInstruction;
  reg                 execute_CsrPlugin_readInstruction;
  wire                execute_CsrPlugin_writeEnable;
  wire                execute_CsrPlugin_readEnable;
  wire       [31:0]   execute_CsrPlugin_readToWriteData;
  wire                switch_Misc_l232_2;
  reg        [31:0]   _zz_CsrPlugin_csrMapping_writeDataSignal;
  wire                when_CsrPlugin_l1587;
  wire                when_CsrPlugin_l1591;
  wire       [11:0]   execute_CsrPlugin_csrAddress;
  reg                 execute_MulPlugin_aSigned;
  reg                 execute_MulPlugin_bSigned;
  wire       [31:0]   execute_MulPlugin_a;
  wire       [31:0]   execute_MulPlugin_b;
  wire       [1:0]    switch_MulPlugin_l87;
  wire       [15:0]   execute_MulPlugin_aULow;
  wire       [15:0]   execute_MulPlugin_bULow;
  wire       [16:0]   execute_MulPlugin_aSLow;
  wire       [16:0]   execute_MulPlugin_bSLow;
  wire       [16:0]   execute_MulPlugin_aHigh;
  wire       [16:0]   execute_MulPlugin_bHigh;
  wire       [65:0]   writeBack_MulPlugin_result;
  wire                when_MulPlugin_l147;
  wire       [1:0]    switch_MulPlugin_l148;
  reg        [32:0]   memory_DivPlugin_rs1;
  reg        [31:0]   memory_DivPlugin_rs2;
  reg        [64:0]   memory_DivPlugin_accumulator;
  wire                memory_DivPlugin_frontendOk;
  reg                 memory_DivPlugin_div_needRevert;
  reg                 memory_DivPlugin_div_counter_willIncrement;
  reg                 memory_DivPlugin_div_counter_willClear;
  reg        [5:0]    memory_DivPlugin_div_counter_valueNext;
  reg        [5:0]    memory_DivPlugin_div_counter_value;
  wire                memory_DivPlugin_div_counter_willOverflowIfInc;
  wire                memory_DivPlugin_div_counter_willOverflow;
  reg                 memory_DivPlugin_div_done;
  wire                when_MulDivIterativePlugin_l126;
  wire                when_MulDivIterativePlugin_l126_1;
  reg        [31:0]   memory_DivPlugin_div_result;
  wire                when_MulDivIterativePlugin_l128;
  wire                when_MulDivIterativePlugin_l129;
  wire                when_MulDivIterativePlugin_l132;
  wire       [31:0]   _zz_memory_DivPlugin_div_stage_0_remainderShifted;
  wire       [32:0]   memory_DivPlugin_div_stage_0_remainderShifted;
  wire       [32:0]   memory_DivPlugin_div_stage_0_remainderMinusDenominator;
  wire       [31:0]   memory_DivPlugin_div_stage_0_outRemainder;
  wire       [31:0]   memory_DivPlugin_div_stage_0_outNumerator;
  wire                when_MulDivIterativePlugin_l151;
  wire       [31:0]   _zz_memory_DivPlugin_div_result;
  wire                when_MulDivIterativePlugin_l162;
  wire                _zz_memory_DivPlugin_rs2;
  wire                _zz_memory_DivPlugin_rs1;
  reg        [32:0]   _zz_memory_DivPlugin_rs1_1;
  reg        [31:0]   externalInterruptArray_regNext;
  reg        [31:0]   _zz_CsrPlugin_csrMapping_readDataInit;
  wire       [31:0]   _zz_externalInterrupt;
  wire                when_Pipeline_l124;
  reg        [31:0]   decode_to_execute_PC;
  wire                when_Pipeline_l124_1;
  reg        [31:0]   execute_to_memory_PC;
  wire                when_Pipeline_l124_2;
  reg        [31:0]   memory_to_writeBack_PC;
  wire                when_Pipeline_l124_3;
  reg        [31:0]   decode_to_execute_INSTRUCTION;
  wire                when_Pipeline_l124_4;
  reg        [31:0]   execute_to_memory_INSTRUCTION;
  wire                when_Pipeline_l124_5;
  reg        [31:0]   memory_to_writeBack_INSTRUCTION;
  wire                when_Pipeline_l124_6;
  reg        [31:0]   decode_to_execute_FORMAL_PC_NEXT;
  wire                when_Pipeline_l124_7;
  reg        [31:0]   execute_to_memory_FORMAL_PC_NEXT;
  wire                when_Pipeline_l124_8;
  reg        [31:0]   memory_to_writeBack_FORMAL_PC_NEXT;
  wire                when_Pipeline_l124_9;
  reg                 decode_to_execute_MEMORY_FORCE_CONSTISTENCY;
  wire                when_Pipeline_l124_10;
  reg        [1:0]    decode_to_execute_SRC1_CTRL;
  wire                when_Pipeline_l124_11;
  reg                 decode_to_execute_SRC_USE_SUB_LESS;
  wire                when_Pipeline_l124_12;
  reg                 decode_to_execute_MEMORY_ENABLE;
  wire                when_Pipeline_l124_13;
  reg                 execute_to_memory_MEMORY_ENABLE;
  wire                when_Pipeline_l124_14;
  reg                 memory_to_writeBack_MEMORY_ENABLE;
  wire                when_Pipeline_l124_15;
  reg        [1:0]    decode_to_execute_ALU_CTRL;
  wire                when_Pipeline_l124_16;
  reg        [1:0]    decode_to_execute_SRC2_CTRL;
  wire                when_Pipeline_l124_17;
  reg                 decode_to_execute_REGFILE_WRITE_VALID;
  wire                when_Pipeline_l124_18;
  reg                 execute_to_memory_REGFILE_WRITE_VALID;
  wire                when_Pipeline_l124_19;
  reg                 memory_to_writeBack_REGFILE_WRITE_VALID;
  wire                when_Pipeline_l124_20;
  reg                 decode_to_execute_BYPASSABLE_EXECUTE_STAGE;
  wire                when_Pipeline_l124_21;
  reg                 decode_to_execute_BYPASSABLE_MEMORY_STAGE;
  wire                when_Pipeline_l124_22;
  reg                 execute_to_memory_BYPASSABLE_MEMORY_STAGE;
  wire                when_Pipeline_l124_23;
  reg                 decode_to_execute_MEMORY_WR;
  wire                when_Pipeline_l124_24;
  reg                 execute_to_memory_MEMORY_WR;
  wire                when_Pipeline_l124_25;
  reg                 memory_to_writeBack_MEMORY_WR;
  wire                when_Pipeline_l124_26;
  reg                 decode_to_execute_MEMORY_MANAGMENT;
  wire                when_Pipeline_l124_27;
  reg                 decode_to_execute_SRC_LESS_UNSIGNED;
  wire                when_Pipeline_l124_28;
  reg        [1:0]    decode_to_execute_ALU_BITWISE_CTRL;
  wire                when_Pipeline_l124_29;
  reg        [1:0]    decode_to_execute_SHIFT_CTRL;
  wire                when_Pipeline_l124_30;
  reg        [1:0]    execute_to_memory_SHIFT_CTRL;
  wire                when_Pipeline_l124_31;
  reg        [1:0]    decode_to_execute_BRANCH_CTRL;
  wire                when_Pipeline_l124_32;
  reg                 decode_to_execute_IS_CSR;
  wire                when_Pipeline_l124_33;
  reg        [1:0]    decode_to_execute_ENV_CTRL;
  wire                when_Pipeline_l124_34;
  reg        [1:0]    execute_to_memory_ENV_CTRL;
  wire                when_Pipeline_l124_35;
  reg        [1:0]    memory_to_writeBack_ENV_CTRL;
  wire                when_Pipeline_l124_36;
  reg                 decode_to_execute_IS_MUL;
  wire                when_Pipeline_l124_37;
  reg                 execute_to_memory_IS_MUL;
  wire                when_Pipeline_l124_38;
  reg                 memory_to_writeBack_IS_MUL;
  wire                when_Pipeline_l124_39;
  reg                 decode_to_execute_IS_DIV;
  wire                when_Pipeline_l124_40;
  reg                 execute_to_memory_IS_DIV;
  wire                when_Pipeline_l124_41;
  reg                 decode_to_execute_IS_RS1_SIGNED;
  wire                when_Pipeline_l124_42;
  reg                 decode_to_execute_IS_RS2_SIGNED;
  wire                when_Pipeline_l124_43;
  reg        [31:0]   decode_to_execute_RS1;
  wire                when_Pipeline_l124_44;
  reg        [31:0]   decode_to_execute_RS2;
  wire                when_Pipeline_l124_45;
  reg                 decode_to_execute_SRC2_FORCE_ZERO;
  wire                when_Pipeline_l124_46;
  reg                 decode_to_execute_PREDICTION_HAD_BRANCHED2;
  wire                when_Pipeline_l124_47;
  reg                 decode_to_execute_CSR_WRITE_OPCODE;
  wire                when_Pipeline_l124_48;
  reg                 decode_to_execute_CSR_READ_OPCODE;
  wire                when_Pipeline_l124_49;
  reg        [31:0]   execute_to_memory_MEMORY_STORE_DATA_RF;
  wire                when_Pipeline_l124_50;
  reg        [31:0]   memory_to_writeBack_MEMORY_STORE_DATA_RF;
  wire                when_Pipeline_l124_51;
  reg        [31:0]   execute_to_memory_REGFILE_WRITE_DATA;
  wire                when_Pipeline_l124_52;
  reg        [31:0]   memory_to_writeBack_REGFILE_WRITE_DATA;
  wire                when_Pipeline_l124_53;
  reg        [31:0]   execute_to_memory_SHIFT_RIGHT;
  wire                when_Pipeline_l124_54;
  reg                 execute_to_memory_BRANCH_DO;
  wire                when_Pipeline_l124_55;
  reg        [31:0]   execute_to_memory_BRANCH_CALC;
  wire                when_Pipeline_l124_56;
  reg        [31:0]   execute_to_memory_MUL_LL;
  wire                when_Pipeline_l124_57;
  reg        [33:0]   execute_to_memory_MUL_LH;
  wire                when_Pipeline_l124_58;
  reg        [33:0]   execute_to_memory_MUL_HL;
  wire                when_Pipeline_l124_59;
  reg        [33:0]   execute_to_memory_MUL_HH;
  wire                when_Pipeline_l124_60;
  reg        [33:0]   memory_to_writeBack_MUL_HH;
  wire                when_Pipeline_l124_61;
  reg        [51:0]   memory_to_writeBack_MUL_LOW;
  wire                when_Pipeline_l151;
  wire                when_Pipeline_l154;
  wire                when_Pipeline_l151_1;
  wire                when_Pipeline_l154_1;
  wire                when_Pipeline_l151_2;
  wire                when_Pipeline_l154_2;
  wire                when_CsrPlugin_l1669;
  reg                 execute_CsrPlugin_csr_3264;
  wire                when_CsrPlugin_l1669_1;
  reg                 execute_CsrPlugin_csr_768;
  wire                when_CsrPlugin_l1669_2;
  reg                 execute_CsrPlugin_csr_836;
  wire                when_CsrPlugin_l1669_3;
  reg                 execute_CsrPlugin_csr_772;
  wire                when_CsrPlugin_l1669_4;
  reg                 execute_CsrPlugin_csr_773;
  wire                when_CsrPlugin_l1669_5;
  reg                 execute_CsrPlugin_csr_833;
  wire                when_CsrPlugin_l1669_6;
  reg                 execute_CsrPlugin_csr_834;
  wire                when_CsrPlugin_l1669_7;
  reg                 execute_CsrPlugin_csr_835;
  wire                when_CsrPlugin_l1669_8;
  reg                 execute_CsrPlugin_csr_3008;
  wire                when_CsrPlugin_l1669_9;
  reg                 execute_CsrPlugin_csr_4032;
  reg        [31:0]   _zz_CsrPlugin_csrMapping_readDataInit_1;
  wire       [1:0]    switch_CsrPlugin_l1031;
  reg        [31:0]   _zz_CsrPlugin_csrMapping_readDataInit_2;
  reg        [31:0]   _zz_CsrPlugin_csrMapping_readDataInit_3;
  reg        [31:0]   _zz_CsrPlugin_csrMapping_readDataInit_4;
  reg        [31:0]   _zz_CsrPlugin_csrMapping_readDataInit_5;
  reg        [31:0]   _zz_CsrPlugin_csrMapping_readDataInit_6;
  reg        [31:0]   _zz_CsrPlugin_csrMapping_readDataInit_7;
  reg        [31:0]   _zz_CsrPlugin_csrMapping_readDataInit_8;
  reg        [31:0]   _zz_CsrPlugin_csrMapping_readDataInit_9;
  wire                when_CsrPlugin_l1702;
  wire       [11:0]   _zz_when_CsrPlugin_l1709;
  wire                when_CsrPlugin_l1709;
  reg                 when_CsrPlugin_l1719;
  wire                when_CsrPlugin_l1717;
  wire                when_CsrPlugin_l1725;
  reg        [2:0]    _zz_iBusWishbone_ADR;
  wire                when_InstructionCache_l239;
  reg                 _zz_iBus_rsp_valid;
  reg        [31:0]   iBusWishbone_DAT_MISO_regNext;
  reg        [2:0]    _zz_dBusWishbone_ADR;
  wire                _zz_dBusWishbone_CYC;
  wire                _zz_dBus_cmd_ready;
  wire                _zz_dBus_cmd_ready_1;
  wire                _zz_dBus_cmd_ready_2;
  wire                _zz_dBusWishbone_ADR_1;
  reg                 _zz_dBus_rsp_valid;
  reg        [31:0]   dBusWishbone_DAT_MISO_regNext;
  `ifndef SYNTHESIS
  reg [39:0] _zz_memory_to_writeBack_ENV_CTRL_string;
  reg [39:0] _zz_memory_to_writeBack_ENV_CTRL_1_string;
  reg [39:0] _zz_execute_to_memory_ENV_CTRL_string;
  reg [39:0] _zz_execute_to_memory_ENV_CTRL_1_string;
  reg [39:0] decode_ENV_CTRL_string;
  reg [39:0] _zz_decode_ENV_CTRL_string;
  reg [39:0] _zz_decode_to_execute_ENV_CTRL_string;
  reg [39:0] _zz_decode_to_execute_ENV_CTRL_1_string;
  reg [31:0] _zz_decode_to_execute_BRANCH_CTRL_string;
  reg [31:0] _zz_decode_to_execute_BRANCH_CTRL_1_string;
  reg [71:0] _zz_execute_to_memory_SHIFT_CTRL_string;
  reg [71:0] _zz_execute_to_memory_SHIFT_CTRL_1_string;
  reg [71:0] decode_SHIFT_CTRL_string;
  reg [71:0] _zz_decode_SHIFT_CTRL_string;
  reg [71:0] _zz_decode_to_execute_SHIFT_CTRL_string;
  reg [71:0] _zz_decode_to_execute_SHIFT_CTRL_1_string;
  reg [39:0] decode_ALU_BITWISE_CTRL_string;
  reg [39:0] _zz_decode_ALU_BITWISE_CTRL_string;
  reg [39:0] _zz_decode_to_execute_ALU_BITWISE_CTRL_string;
  reg [39:0] _zz_decode_to_execute_ALU_BITWISE_CTRL_1_string;
  reg [23:0] decode_SRC2_CTRL_string;
  reg [23:0] _zz_decode_SRC2_CTRL_string;
  reg [23:0] _zz_decode_to_execute_SRC2_CTRL_string;
  reg [23:0] _zz_decode_to_execute_SRC2_CTRL_1_string;
  reg [63:0] decode_ALU_CTRL_string;
  reg [63:0] _zz_decode_ALU_CTRL_string;
  reg [63:0] _zz_decode_to_execute_ALU_CTRL_string;
  reg [63:0] _zz_decode_to_execute_ALU_CTRL_1_string;
  reg [95:0] decode_SRC1_CTRL_string;
  reg [95:0] _zz_decode_SRC1_CTRL_string;
  reg [95:0] _zz_decode_to_execute_SRC1_CTRL_string;
  reg [95:0] _zz_decode_to_execute_SRC1_CTRL_1_string;
  reg [39:0] memory_ENV_CTRL_string;
  reg [39:0] _zz_memory_ENV_CTRL_string;
  reg [39:0] execute_ENV_CTRL_string;
  reg [39:0] _zz_execute_ENV_CTRL_string;
  reg [39:0] writeBack_ENV_CTRL_string;
  reg [39:0] _zz_writeBack_ENV_CTRL_string;
  reg [31:0] execute_BRANCH_CTRL_string;
  reg [31:0] _zz_execute_BRANCH_CTRL_string;
  reg [71:0] memory_SHIFT_CTRL_string;
  reg [71:0] _zz_memory_SHIFT_CTRL_string;
  reg [71:0] execute_SHIFT_CTRL_string;
  reg [71:0] _zz_execute_SHIFT_CTRL_string;
  reg [23:0] execute_SRC2_CTRL_string;
  reg [23:0] _zz_execute_SRC2_CTRL_string;
  reg [95:0] execute_SRC1_CTRL_string;
  reg [95:0] _zz_execute_SRC1_CTRL_string;
  reg [63:0] execute_ALU_CTRL_string;
  reg [63:0] _zz_execute_ALU_CTRL_string;
  reg [39:0] execute_ALU_BITWISE_CTRL_string;
  reg [39:0] _zz_execute_ALU_BITWISE_CTRL_string;
  reg [39:0] _zz_decode_ENV_CTRL_1_string;
  reg [31:0] _zz_decode_BRANCH_CTRL_string;
  reg [71:0] _zz_decode_SHIFT_CTRL_1_string;
  reg [39:0] _zz_decode_ALU_BITWISE_CTRL_1_string;
  reg [23:0] _zz_decode_SRC2_CTRL_1_string;
  reg [63:0] _zz_decode_ALU_CTRL_1_string;
  reg [95:0] _zz_decode_SRC1_CTRL_1_string;
  reg [31:0] decode_BRANCH_CTRL_string;
  reg [31:0] _zz_decode_BRANCH_CTRL_1_string;
  reg [95:0] _zz_decode_SRC1_CTRL_2_string;
  reg [63:0] _zz_decode_ALU_CTRL_2_string;
  reg [23:0] _zz_decode_SRC2_CTRL_2_string;
  reg [39:0] _zz_decode_ALU_BITWISE_CTRL_2_string;
  reg [71:0] _zz_decode_SHIFT_CTRL_2_string;
  reg [31:0] _zz_decode_BRANCH_CTRL_2_string;
  reg [39:0] _zz_decode_ENV_CTRL_2_string;
  reg [95:0] decode_to_execute_SRC1_CTRL_string;
  reg [63:0] decode_to_execute_ALU_CTRL_string;
  reg [23:0] decode_to_execute_SRC2_CTRL_string;
  reg [39:0] decode_to_execute_ALU_BITWISE_CTRL_string;
  reg [71:0] decode_to_execute_SHIFT_CTRL_string;
  reg [71:0] execute_to_memory_SHIFT_CTRL_string;
  reg [31:0] decode_to_execute_BRANCH_CTRL_string;
  reg [39:0] decode_to_execute_ENV_CTRL_string;
  reg [39:0] execute_to_memory_ENV_CTRL_string;
  reg [39:0] memory_to_writeBack_ENV_CTRL_string;
  `endif

  (* no_rw_check , ram_style = "block" *) reg [31:0] RegFilePlugin_regFile [0:31] /* verilator public */ ;

  assign _zz_when = ({decodeExceptionPort_valid,IBusCachedPlugin_decodeExceptionPort_valid} != 2'b00);
  assign _zz_memory_MUL_LOW = ($signed(_zz_memory_MUL_LOW_1) + $signed(_zz_memory_MUL_LOW_4));
  assign _zz_memory_MUL_LOW_1 = ($signed(52'h0000000000000) + $signed(_zz_memory_MUL_LOW_2));
  assign _zz_memory_MUL_LOW_3 = {1'b0,memory_MUL_LL};
  assign _zz_memory_MUL_LOW_2 = {{19{_zz_memory_MUL_LOW_3[32]}}, _zz_memory_MUL_LOW_3};
  assign _zz_memory_MUL_LOW_5 = ({16'd0,memory_MUL_LH} <<< 5'd16);
  assign _zz_memory_MUL_LOW_4 = {{2{_zz_memory_MUL_LOW_5[49]}}, _zz_memory_MUL_LOW_5};
  assign _zz_memory_MUL_LOW_7 = ({16'd0,memory_MUL_HL} <<< 5'd16);
  assign _zz_memory_MUL_LOW_6 = {{2{_zz_memory_MUL_LOW_7[49]}}, _zz_memory_MUL_LOW_7};
  assign _zz_execute_SHIFT_RIGHT_1 = ($signed(_zz_execute_SHIFT_RIGHT_2) >>> execute_FullBarrelShifterPlugin_amplitude);
  assign _zz_execute_SHIFT_RIGHT = _zz_execute_SHIFT_RIGHT_1[31 : 0];
  assign _zz_execute_SHIFT_RIGHT_2 = {((execute_SHIFT_CTRL == ShiftCtrlEnum_SRA_1) && execute_FullBarrelShifterPlugin_reversed[31]),execute_FullBarrelShifterPlugin_reversed};
  assign _zz__zz_IBusCachedPlugin_jump_pcLoad_payload_1 = (_zz_IBusCachedPlugin_jump_pcLoad_payload - 4'b0001);
  assign _zz_IBusCachedPlugin_fetchPc_pc_1 = {IBusCachedPlugin_fetchPc_inc,2'b00};
  assign _zz_IBusCachedPlugin_fetchPc_pc = {29'd0, _zz_IBusCachedPlugin_fetchPc_pc_1};
  assign _zz__zz_IBusCachedPlugin_decodePrediction_cmd_hadBranch = {{{decode_INSTRUCTION[31],decode_INSTRUCTION[7]},decode_INSTRUCTION[30 : 25]},decode_INSTRUCTION[11 : 8]};
  assign _zz_IBusCachedPlugin_decodePrediction_cmd_hadBranch_2 = {{_zz_IBusCachedPlugin_decodePrediction_cmd_hadBranch_1,{{{decode_INSTRUCTION[31],decode_INSTRUCTION[7]},decode_INSTRUCTION[30 : 25]},decode_INSTRUCTION[11 : 8]}},1'b0};
  assign _zz__zz_2 = {{{decode_INSTRUCTION[31],decode_INSTRUCTION[19 : 12]},decode_INSTRUCTION[20]},decode_INSTRUCTION[30 : 21]};
  assign _zz__zz_4 = {{{decode_INSTRUCTION[31],decode_INSTRUCTION[7]},decode_INSTRUCTION[30 : 25]},decode_INSTRUCTION[11 : 8]};
  assign _zz__zz_6 = {{_zz_3,{{{decode_INSTRUCTION[31],decode_INSTRUCTION[19 : 12]},decode_INSTRUCTION[20]},decode_INSTRUCTION[30 : 21]}},1'b0};
  assign _zz__zz_6_1 = {{_zz_5,{{{decode_INSTRUCTION[31],decode_INSTRUCTION[7]},decode_INSTRUCTION[30 : 25]},decode_INSTRUCTION[11 : 8]}},1'b0};
  assign _zz__zz_IBusCachedPlugin_predictionJumpInterface_payload = {{{decode_INSTRUCTION[31],decode_INSTRUCTION[19 : 12]},decode_INSTRUCTION[20]},decode_INSTRUCTION[30 : 21]};
  assign _zz__zz_IBusCachedPlugin_predictionJumpInterface_payload_2 = {{{decode_INSTRUCTION[31],decode_INSTRUCTION[7]},decode_INSTRUCTION[30 : 25]},decode_INSTRUCTION[11 : 8]};
  assign _zz_io_cpu_flush_payload_lineId = _zz_io_cpu_flush_payload_lineId_1;
  assign _zz_io_cpu_flush_payload_lineId_1 = (execute_RS1 >>> 3'd5);
  assign _zz_DBusCachedPlugin_exceptionBus_payload_code = (writeBack_MEMORY_WR ? 3'b111 : 3'b101);
  assign _zz_DBusCachedPlugin_exceptionBus_payload_code_1 = (writeBack_MEMORY_WR ? 3'b110 : 3'b100);
  assign _zz__zz_execute_REGFILE_WRITE_DATA = execute_SRC_LESS;
  assign _zz__zz_execute_SRC1 = 3'b100;
  assign _zz__zz_execute_SRC1_1 = execute_INSTRUCTION[19 : 15];
  assign _zz__zz_execute_SRC2_2 = {execute_INSTRUCTION[31 : 25],execute_INSTRUCTION[11 : 7]};
  assign _zz_execute_SrcPlugin_addSub = ($signed(_zz_execute_SrcPlugin_addSub_1) + $signed(_zz_execute_SrcPlugin_addSub_4));
  assign _zz_execute_SrcPlugin_addSub_1 = ($signed(_zz_execute_SrcPlugin_addSub_2) + $signed(_zz_execute_SrcPlugin_addSub_3));
  assign _zz_execute_SrcPlugin_addSub_2 = execute_SRC1;
  assign _zz_execute_SrcPlugin_addSub_3 = (execute_SRC_USE_SUB_LESS ? (~ execute_SRC2) : execute_SRC2);
  assign _zz_execute_SrcPlugin_addSub_4 = (execute_SRC_USE_SUB_LESS ? 32'h00000001 : 32'h00000000);
  assign _zz__zz_execute_BranchPlugin_missAlignedTarget_2 = {{{execute_INSTRUCTION[31],execute_INSTRUCTION[19 : 12]},execute_INSTRUCTION[20]},execute_INSTRUCTION[30 : 21]};
  assign _zz__zz_execute_BranchPlugin_missAlignedTarget_4 = {{{execute_INSTRUCTION[31],execute_INSTRUCTION[7]},execute_INSTRUCTION[30 : 25]},execute_INSTRUCTION[11 : 8]};
  assign _zz__zz_execute_BranchPlugin_missAlignedTarget_6 = {_zz_execute_BranchPlugin_missAlignedTarget_1,execute_INSTRUCTION[31 : 20]};
  assign _zz__zz_execute_BranchPlugin_missAlignedTarget_6_1 = {{_zz_execute_BranchPlugin_missAlignedTarget_3,{{{execute_INSTRUCTION[31],execute_INSTRUCTION[19 : 12]},execute_INSTRUCTION[20]},execute_INSTRUCTION[30 : 21]}},1'b0};
  assign _zz__zz_execute_BranchPlugin_missAlignedTarget_6_2 = {{_zz_execute_BranchPlugin_missAlignedTarget_5,{{{execute_INSTRUCTION[31],execute_INSTRUCTION[7]},execute_INSTRUCTION[30 : 25]},execute_INSTRUCTION[11 : 8]}},1'b0};
  assign _zz__zz_execute_BranchPlugin_branch_src2_2 = {{{execute_INSTRUCTION[31],execute_INSTRUCTION[19 : 12]},execute_INSTRUCTION[20]},execute_INSTRUCTION[30 : 21]};
  assign _zz__zz_execute_BranchPlugin_branch_src2_4 = {{{execute_INSTRUCTION[31],execute_INSTRUCTION[7]},execute_INSTRUCTION[30 : 25]},execute_INSTRUCTION[11 : 8]};
  assign _zz_execute_BranchPlugin_branch_src2_9 = 3'b100;
  assign _zz__zz_CsrPlugin_exceptionPortCtrl_exceptionContext_code_1 = (_zz_CsrPlugin_exceptionPortCtrl_exceptionContext_code & (~ _zz__zz_CsrPlugin_exceptionPortCtrl_exceptionContext_code_1_1));
  assign _zz__zz_CsrPlugin_exceptionPortCtrl_exceptionContext_code_1_1 = (_zz_CsrPlugin_exceptionPortCtrl_exceptionContext_code - 2'b01);
  assign _zz_writeBack_MulPlugin_result = {{14{writeBack_MUL_LOW[51]}}, writeBack_MUL_LOW};
  assign _zz_writeBack_MulPlugin_result_1 = ({32'd0,writeBack_MUL_HH} <<< 6'd32);
  assign _zz__zz_decode_RS2_2 = writeBack_MUL_LOW[31 : 0];
  assign _zz__zz_decode_RS2_2_1 = writeBack_MulPlugin_result[63 : 32];
  assign _zz_memory_DivPlugin_div_counter_valueNext_1 = memory_DivPlugin_div_counter_willIncrement;
  assign _zz_memory_DivPlugin_div_counter_valueNext = {5'd0, _zz_memory_DivPlugin_div_counter_valueNext_1};
  assign _zz_memory_DivPlugin_div_stage_0_remainderMinusDenominator = {1'd0, memory_DivPlugin_rs2};
  assign _zz_memory_DivPlugin_div_stage_0_outRemainder = memory_DivPlugin_div_stage_0_remainderMinusDenominator[31:0];
  assign _zz_memory_DivPlugin_div_stage_0_outRemainder_1 = memory_DivPlugin_div_stage_0_remainderShifted[31:0];
  assign _zz_memory_DivPlugin_div_stage_0_outNumerator = {_zz_memory_DivPlugin_div_stage_0_remainderShifted,(! memory_DivPlugin_div_stage_0_remainderMinusDenominator[32])};
  assign _zz_memory_DivPlugin_div_result_1 = _zz_memory_DivPlugin_div_result_2;
  assign _zz_memory_DivPlugin_div_result_2 = _zz_memory_DivPlugin_div_result_3;
  assign _zz_memory_DivPlugin_div_result_3 = ({memory_DivPlugin_div_needRevert,(memory_DivPlugin_div_needRevert ? (~ _zz_memory_DivPlugin_div_result) : _zz_memory_DivPlugin_div_result)} + _zz_memory_DivPlugin_div_result_4);
  assign _zz_memory_DivPlugin_div_result_5 = memory_DivPlugin_div_needRevert;
  assign _zz_memory_DivPlugin_div_result_4 = {32'd0, _zz_memory_DivPlugin_div_result_5};
  assign _zz_memory_DivPlugin_rs1_3 = _zz_memory_DivPlugin_rs1;
  assign _zz_memory_DivPlugin_rs1_2 = {32'd0, _zz_memory_DivPlugin_rs1_3};
  assign _zz_memory_DivPlugin_rs2_2 = _zz_memory_DivPlugin_rs2;
  assign _zz_memory_DivPlugin_rs2_1 = {31'd0, _zz_memory_DivPlugin_rs2_2};
  assign _zz_iBusWishbone_ADR_1 = (iBus_cmd_payload_address >>> 3'd5);
  assign _zz_decode_RegFilePlugin_rs1Data = 1'b1;
  assign _zz_decode_RegFilePlugin_rs2Data = 1'b1;
  assign _zz_IBusCachedPlugin_jump_pcLoad_payload_6 = {_zz_IBusCachedPlugin_jump_pcLoad_payload_4,_zz_IBusCachedPlugin_jump_pcLoad_payload_3};
  assign _zz_writeBack_DBusCachedPlugin_rspShifted_1 = dataCache_1_io_cpu_writeBack_address[1 : 0];
  assign _zz_writeBack_DBusCachedPlugin_rspShifted_3 = dataCache_1_io_cpu_writeBack_address[1 : 1];
  assign _zz_decode_LEGAL_INSTRUCTION = 32'h0000207f;
  assign _zz_decode_LEGAL_INSTRUCTION_1 = (decode_INSTRUCTION & 32'h0000407f);
  assign _zz_decode_LEGAL_INSTRUCTION_2 = 32'h00004063;
  assign _zz_decode_LEGAL_INSTRUCTION_3 = ((decode_INSTRUCTION & 32'h0000207f) == 32'h00002013);
  assign _zz_decode_LEGAL_INSTRUCTION_4 = ((decode_INSTRUCTION & 32'h0000107f) == 32'h00000013);
  assign _zz_decode_LEGAL_INSTRUCTION_5 = {((decode_INSTRUCTION & 32'h0000603f) == 32'h00000023),{((decode_INSTRUCTION & 32'h0000207f) == 32'h00000003),{((decode_INSTRUCTION & _zz_decode_LEGAL_INSTRUCTION_6) == 32'h00000003),{(_zz_decode_LEGAL_INSTRUCTION_7 == _zz_decode_LEGAL_INSTRUCTION_8),{_zz_decode_LEGAL_INSTRUCTION_9,{_zz_decode_LEGAL_INSTRUCTION_10,_zz_decode_LEGAL_INSTRUCTION_11}}}}}};
  assign _zz_decode_LEGAL_INSTRUCTION_6 = 32'h0000505f;
  assign _zz_decode_LEGAL_INSTRUCTION_7 = (decode_INSTRUCTION & 32'h0000707b);
  assign _zz_decode_LEGAL_INSTRUCTION_8 = 32'h00000063;
  assign _zz_decode_LEGAL_INSTRUCTION_9 = ((decode_INSTRUCTION & 32'h0000607f) == 32'h0000000f);
  assign _zz_decode_LEGAL_INSTRUCTION_10 = ((decode_INSTRUCTION & 32'hfc00007f) == 32'h00000033);
  assign _zz_decode_LEGAL_INSTRUCTION_11 = {((decode_INSTRUCTION & 32'h01f0707f) == 32'h0000500f),{((decode_INSTRUCTION & 32'hbe00705f) == 32'h00005013),{((decode_INSTRUCTION & _zz_decode_LEGAL_INSTRUCTION_12) == 32'h00001013),{(_zz_decode_LEGAL_INSTRUCTION_13 == _zz_decode_LEGAL_INSTRUCTION_14),{_zz_decode_LEGAL_INSTRUCTION_15,{_zz_decode_LEGAL_INSTRUCTION_16,_zz_decode_LEGAL_INSTRUCTION_17}}}}}};
  assign _zz_decode_LEGAL_INSTRUCTION_12 = 32'hfe00305f;
  assign _zz_decode_LEGAL_INSTRUCTION_13 = (decode_INSTRUCTION & 32'hbe00707f);
  assign _zz_decode_LEGAL_INSTRUCTION_14 = 32'h00000033;
  assign _zz_decode_LEGAL_INSTRUCTION_15 = ((decode_INSTRUCTION & 32'hdfffffff) == 32'h10200073);
  assign _zz_decode_LEGAL_INSTRUCTION_16 = ((decode_INSTRUCTION & 32'hffffffff) == 32'h10500073);
  assign _zz_decode_LEGAL_INSTRUCTION_17 = ((decode_INSTRUCTION & 32'hffffffff) == 32'h00000073);
  assign _zz_IBusCachedPlugin_predictionJumpInterface_payload_4 = decode_INSTRUCTION[31];
  assign _zz_IBusCachedPlugin_predictionJumpInterface_payload_5 = decode_INSTRUCTION[31];
  assign _zz_IBusCachedPlugin_predictionJumpInterface_payload_6 = decode_INSTRUCTION[7];
  assign _zz__zz_decode_IS_RS2_SIGNED = (decode_INSTRUCTION & 32'h02004064);
  assign _zz__zz_decode_IS_RS2_SIGNED_1 = 32'h02004020;
  assign _zz__zz_decode_IS_RS2_SIGNED_2 = ((decode_INSTRUCTION & 32'h02004074) == 32'h02000030);
  assign _zz__zz_decode_IS_RS2_SIGNED_3 = ((decode_INSTRUCTION & 32'h10003050) == 32'h00000050);
  assign _zz__zz_decode_IS_RS2_SIGNED_4 = (|((decode_INSTRUCTION & _zz__zz_decode_IS_RS2_SIGNED_5) == 32'h10000050));
  assign _zz__zz_decode_IS_RS2_SIGNED_6 = (|{_zz__zz_decode_IS_RS2_SIGNED_7,_zz__zz_decode_IS_RS2_SIGNED_8});
  assign _zz__zz_decode_IS_RS2_SIGNED_9 = {(|{_zz__zz_decode_IS_RS2_SIGNED_10,_zz__zz_decode_IS_RS2_SIGNED_11}),{(|_zz__zz_decode_IS_RS2_SIGNED_13),{_zz__zz_decode_IS_RS2_SIGNED_15,{_zz__zz_decode_IS_RS2_SIGNED_18,_zz__zz_decode_IS_RS2_SIGNED_21}}}};
  assign _zz__zz_decode_IS_RS2_SIGNED_5 = 32'h10403050;
  assign _zz__zz_decode_IS_RS2_SIGNED_7 = ((decode_INSTRUCTION & 32'h00001050) == 32'h00001050);
  assign _zz__zz_decode_IS_RS2_SIGNED_8 = ((decode_INSTRUCTION & 32'h00002050) == 32'h00002050);
  assign _zz__zz_decode_IS_RS2_SIGNED_10 = _zz_decode_IS_RS2_SIGNED_4;
  assign _zz__zz_decode_IS_RS2_SIGNED_11 = ((decode_INSTRUCTION & _zz__zz_decode_IS_RS2_SIGNED_12) == 32'h00000004);
  assign _zz__zz_decode_IS_RS2_SIGNED_13 = ((decode_INSTRUCTION & _zz__zz_decode_IS_RS2_SIGNED_14) == 32'h00000040);
  assign _zz__zz_decode_IS_RS2_SIGNED_15 = (|(_zz__zz_decode_IS_RS2_SIGNED_16 == _zz__zz_decode_IS_RS2_SIGNED_17));
  assign _zz__zz_decode_IS_RS2_SIGNED_18 = (|{_zz__zz_decode_IS_RS2_SIGNED_19,_zz__zz_decode_IS_RS2_SIGNED_20});
  assign _zz__zz_decode_IS_RS2_SIGNED_21 = {(|_zz__zz_decode_IS_RS2_SIGNED_22),{_zz__zz_decode_IS_RS2_SIGNED_23,{_zz__zz_decode_IS_RS2_SIGNED_25,_zz__zz_decode_IS_RS2_SIGNED_28}}};
  assign _zz__zz_decode_IS_RS2_SIGNED_12 = 32'h0000001c;
  assign _zz__zz_decode_IS_RS2_SIGNED_14 = 32'h00000058;
  assign _zz__zz_decode_IS_RS2_SIGNED_16 = (decode_INSTRUCTION & 32'h02007054);
  assign _zz__zz_decode_IS_RS2_SIGNED_17 = 32'h00005010;
  assign _zz__zz_decode_IS_RS2_SIGNED_19 = ((decode_INSTRUCTION & 32'h40003054) == 32'h40001010);
  assign _zz__zz_decode_IS_RS2_SIGNED_20 = ((decode_INSTRUCTION & 32'h02007054) == 32'h00001010);
  assign _zz__zz_decode_IS_RS2_SIGNED_22 = ((decode_INSTRUCTION & 32'h00000064) == 32'h00000024);
  assign _zz__zz_decode_IS_RS2_SIGNED_23 = (|((decode_INSTRUCTION & _zz__zz_decode_IS_RS2_SIGNED_24) == 32'h00001000));
  assign _zz__zz_decode_IS_RS2_SIGNED_25 = (|(_zz__zz_decode_IS_RS2_SIGNED_26 == _zz__zz_decode_IS_RS2_SIGNED_27));
  assign _zz__zz_decode_IS_RS2_SIGNED_28 = {(|{_zz__zz_decode_IS_RS2_SIGNED_29,_zz__zz_decode_IS_RS2_SIGNED_30}),{(|_zz__zz_decode_IS_RS2_SIGNED_31),{_zz__zz_decode_IS_RS2_SIGNED_32,{_zz__zz_decode_IS_RS2_SIGNED_37,_zz__zz_decode_IS_RS2_SIGNED_42}}}};
  assign _zz__zz_decode_IS_RS2_SIGNED_24 = 32'h00001000;
  assign _zz__zz_decode_IS_RS2_SIGNED_26 = (decode_INSTRUCTION & 32'h00003000);
  assign _zz__zz_decode_IS_RS2_SIGNED_27 = 32'h00002000;
  assign _zz__zz_decode_IS_RS2_SIGNED_29 = ((decode_INSTRUCTION & 32'h00002010) == 32'h00002000);
  assign _zz__zz_decode_IS_RS2_SIGNED_30 = ((decode_INSTRUCTION & 32'h00005000) == 32'h00001000);
  assign _zz__zz_decode_IS_RS2_SIGNED_31 = ((decode_INSTRUCTION & 32'h00004048) == 32'h00004008);
  assign _zz__zz_decode_IS_RS2_SIGNED_32 = (|{(_zz__zz_decode_IS_RS2_SIGNED_33 == _zz__zz_decode_IS_RS2_SIGNED_34),(_zz__zz_decode_IS_RS2_SIGNED_35 == _zz__zz_decode_IS_RS2_SIGNED_36)});
  assign _zz__zz_decode_IS_RS2_SIGNED_37 = (|{_zz__zz_decode_IS_RS2_SIGNED_38,{_zz__zz_decode_IS_RS2_SIGNED_39,_zz__zz_decode_IS_RS2_SIGNED_40}});
  assign _zz__zz_decode_IS_RS2_SIGNED_42 = {(|_zz__zz_decode_IS_RS2_SIGNED_43),{(|_zz__zz_decode_IS_RS2_SIGNED_44),{_zz__zz_decode_IS_RS2_SIGNED_55,{_zz__zz_decode_IS_RS2_SIGNED_68,_zz__zz_decode_IS_RS2_SIGNED_82}}}};
  assign _zz__zz_decode_IS_RS2_SIGNED_33 = (decode_INSTRUCTION & 32'h00000034);
  assign _zz__zz_decode_IS_RS2_SIGNED_34 = 32'h00000020;
  assign _zz__zz_decode_IS_RS2_SIGNED_35 = (decode_INSTRUCTION & 32'h00000064);
  assign _zz__zz_decode_IS_RS2_SIGNED_36 = 32'h00000020;
  assign _zz__zz_decode_IS_RS2_SIGNED_38 = ((decode_INSTRUCTION & 32'h00000050) == 32'h00000040);
  assign _zz__zz_decode_IS_RS2_SIGNED_39 = _zz_decode_IS_RS2_SIGNED_2;
  assign _zz__zz_decode_IS_RS2_SIGNED_40 = ((decode_INSTRUCTION & _zz__zz_decode_IS_RS2_SIGNED_41) == 32'h00000040);
  assign _zz__zz_decode_IS_RS2_SIGNED_43 = ((decode_INSTRUCTION & 32'h00000020) == 32'h00000020);
  assign _zz__zz_decode_IS_RS2_SIGNED_44 = {(_zz__zz_decode_IS_RS2_SIGNED_45 == _zz__zz_decode_IS_RS2_SIGNED_46),{_zz_decode_IS_RS2_SIGNED_3,{_zz__zz_decode_IS_RS2_SIGNED_47,_zz__zz_decode_IS_RS2_SIGNED_50}}};
  assign _zz__zz_decode_IS_RS2_SIGNED_55 = (|{_zz_decode_IS_RS2_SIGNED_3,{_zz__zz_decode_IS_RS2_SIGNED_56,_zz__zz_decode_IS_RS2_SIGNED_59}});
  assign _zz__zz_decode_IS_RS2_SIGNED_68 = (|{_zz__zz_decode_IS_RS2_SIGNED_69,_zz__zz_decode_IS_RS2_SIGNED_70});
  assign _zz__zz_decode_IS_RS2_SIGNED_82 = {(|_zz__zz_decode_IS_RS2_SIGNED_83),{_zz__zz_decode_IS_RS2_SIGNED_86,{_zz__zz_decode_IS_RS2_SIGNED_91,_zz__zz_decode_IS_RS2_SIGNED_95}}};
  assign _zz__zz_decode_IS_RS2_SIGNED_41 = 32'h00403040;
  assign _zz__zz_decode_IS_RS2_SIGNED_45 = (decode_INSTRUCTION & 32'h00000040);
  assign _zz__zz_decode_IS_RS2_SIGNED_46 = 32'h00000040;
  assign _zz__zz_decode_IS_RS2_SIGNED_47 = (_zz__zz_decode_IS_RS2_SIGNED_48 == _zz__zz_decode_IS_RS2_SIGNED_49);
  assign _zz__zz_decode_IS_RS2_SIGNED_50 = {_zz__zz_decode_IS_RS2_SIGNED_51,_zz__zz_decode_IS_RS2_SIGNED_53};
  assign _zz__zz_decode_IS_RS2_SIGNED_56 = (_zz__zz_decode_IS_RS2_SIGNED_57 == _zz__zz_decode_IS_RS2_SIGNED_58);
  assign _zz__zz_decode_IS_RS2_SIGNED_59 = {_zz__zz_decode_IS_RS2_SIGNED_60,{_zz__zz_decode_IS_RS2_SIGNED_62,_zz__zz_decode_IS_RS2_SIGNED_65}};
  assign _zz__zz_decode_IS_RS2_SIGNED_69 = _zz_decode_IS_RS2_SIGNED_4;
  assign _zz__zz_decode_IS_RS2_SIGNED_70 = {_zz__zz_decode_IS_RS2_SIGNED_71,{_zz__zz_decode_IS_RS2_SIGNED_73,_zz__zz_decode_IS_RS2_SIGNED_76}};
  assign _zz__zz_decode_IS_RS2_SIGNED_83 = {_zz_decode_IS_RS2_SIGNED_3,_zz__zz_decode_IS_RS2_SIGNED_84};
  assign _zz__zz_decode_IS_RS2_SIGNED_86 = (|{_zz__zz_decode_IS_RS2_SIGNED_87,_zz__zz_decode_IS_RS2_SIGNED_88});
  assign _zz__zz_decode_IS_RS2_SIGNED_91 = (|_zz__zz_decode_IS_RS2_SIGNED_92);
  assign _zz__zz_decode_IS_RS2_SIGNED_95 = {_zz__zz_decode_IS_RS2_SIGNED_96,{_zz__zz_decode_IS_RS2_SIGNED_98,_zz__zz_decode_IS_RS2_SIGNED_109}};
  assign _zz__zz_decode_IS_RS2_SIGNED_48 = (decode_INSTRUCTION & 32'h00004020);
  assign _zz__zz_decode_IS_RS2_SIGNED_49 = 32'h00004020;
  assign _zz__zz_decode_IS_RS2_SIGNED_51 = ((decode_INSTRUCTION & _zz__zz_decode_IS_RS2_SIGNED_52) == 32'h00000010);
  assign _zz__zz_decode_IS_RS2_SIGNED_53 = ((decode_INSTRUCTION & _zz__zz_decode_IS_RS2_SIGNED_54) == 32'h00000020);
  assign _zz__zz_decode_IS_RS2_SIGNED_57 = (decode_INSTRUCTION & 32'h00002030);
  assign _zz__zz_decode_IS_RS2_SIGNED_58 = 32'h00002010;
  assign _zz__zz_decode_IS_RS2_SIGNED_60 = ((decode_INSTRUCTION & _zz__zz_decode_IS_RS2_SIGNED_61) == 32'h00000010);
  assign _zz__zz_decode_IS_RS2_SIGNED_62 = (_zz__zz_decode_IS_RS2_SIGNED_63 == _zz__zz_decode_IS_RS2_SIGNED_64);
  assign _zz__zz_decode_IS_RS2_SIGNED_65 = (_zz__zz_decode_IS_RS2_SIGNED_66 == _zz__zz_decode_IS_RS2_SIGNED_67);
  assign _zz__zz_decode_IS_RS2_SIGNED_71 = ((decode_INSTRUCTION & _zz__zz_decode_IS_RS2_SIGNED_72) == 32'h00001010);
  assign _zz__zz_decode_IS_RS2_SIGNED_73 = (_zz__zz_decode_IS_RS2_SIGNED_74 == _zz__zz_decode_IS_RS2_SIGNED_75);
  assign _zz__zz_decode_IS_RS2_SIGNED_76 = {_zz__zz_decode_IS_RS2_SIGNED_77,{_zz__zz_decode_IS_RS2_SIGNED_78,_zz__zz_decode_IS_RS2_SIGNED_80}};
  assign _zz__zz_decode_IS_RS2_SIGNED_84 = ((decode_INSTRUCTION & _zz__zz_decode_IS_RS2_SIGNED_85) == 32'h00000020);
  assign _zz__zz_decode_IS_RS2_SIGNED_87 = _zz_decode_IS_RS2_SIGNED_3;
  assign _zz__zz_decode_IS_RS2_SIGNED_88 = (_zz__zz_decode_IS_RS2_SIGNED_89 == _zz__zz_decode_IS_RS2_SIGNED_90);
  assign _zz__zz_decode_IS_RS2_SIGNED_92 = (_zz__zz_decode_IS_RS2_SIGNED_93 == _zz__zz_decode_IS_RS2_SIGNED_94);
  assign _zz__zz_decode_IS_RS2_SIGNED_96 = (|_zz__zz_decode_IS_RS2_SIGNED_97);
  assign _zz__zz_decode_IS_RS2_SIGNED_98 = (|_zz__zz_decode_IS_RS2_SIGNED_99);
  assign _zz__zz_decode_IS_RS2_SIGNED_109 = {_zz__zz_decode_IS_RS2_SIGNED_110,{_zz__zz_decode_IS_RS2_SIGNED_113,_zz__zz_decode_IS_RS2_SIGNED_121}};
  assign _zz__zz_decode_IS_RS2_SIGNED_52 = 32'h00000030;
  assign _zz__zz_decode_IS_RS2_SIGNED_54 = 32'h02000020;
  assign _zz__zz_decode_IS_RS2_SIGNED_61 = 32'h00001030;
  assign _zz__zz_decode_IS_RS2_SIGNED_63 = (decode_INSTRUCTION & 32'h02002060);
  assign _zz__zz_decode_IS_RS2_SIGNED_64 = 32'h00002020;
  assign _zz__zz_decode_IS_RS2_SIGNED_66 = (decode_INSTRUCTION & 32'h02003020);
  assign _zz__zz_decode_IS_RS2_SIGNED_67 = 32'h00000020;
  assign _zz__zz_decode_IS_RS2_SIGNED_72 = 32'h00001010;
  assign _zz__zz_decode_IS_RS2_SIGNED_74 = (decode_INSTRUCTION & 32'h00002010);
  assign _zz__zz_decode_IS_RS2_SIGNED_75 = 32'h00002010;
  assign _zz__zz_decode_IS_RS2_SIGNED_77 = ((decode_INSTRUCTION & 32'h00000050) == 32'h00000010);
  assign _zz__zz_decode_IS_RS2_SIGNED_78 = ((decode_INSTRUCTION & _zz__zz_decode_IS_RS2_SIGNED_79) == 32'h00000004);
  assign _zz__zz_decode_IS_RS2_SIGNED_80 = ((decode_INSTRUCTION & _zz__zz_decode_IS_RS2_SIGNED_81) == 32'h00000000);
  assign _zz__zz_decode_IS_RS2_SIGNED_85 = 32'h00000070;
  assign _zz__zz_decode_IS_RS2_SIGNED_89 = (decode_INSTRUCTION & 32'h00000020);
  assign _zz__zz_decode_IS_RS2_SIGNED_90 = 32'h00000000;
  assign _zz__zz_decode_IS_RS2_SIGNED_93 = (decode_INSTRUCTION & 32'h00004014);
  assign _zz__zz_decode_IS_RS2_SIGNED_94 = 32'h00004010;
  assign _zz__zz_decode_IS_RS2_SIGNED_97 = ((decode_INSTRUCTION & 32'h00006014) == 32'h00002010);
  assign _zz__zz_decode_IS_RS2_SIGNED_99 = {(_zz__zz_decode_IS_RS2_SIGNED_100 == _zz__zz_decode_IS_RS2_SIGNED_101),{_zz_decode_IS_RS2_SIGNED_2,{_zz__zz_decode_IS_RS2_SIGNED_102,_zz__zz_decode_IS_RS2_SIGNED_104}}};
  assign _zz__zz_decode_IS_RS2_SIGNED_110 = (|(_zz__zz_decode_IS_RS2_SIGNED_111 == _zz__zz_decode_IS_RS2_SIGNED_112));
  assign _zz__zz_decode_IS_RS2_SIGNED_113 = (|{_zz__zz_decode_IS_RS2_SIGNED_114,_zz__zz_decode_IS_RS2_SIGNED_116});
  assign _zz__zz_decode_IS_RS2_SIGNED_121 = {(|_zz__zz_decode_IS_RS2_SIGNED_122),{_zz__zz_decode_IS_RS2_SIGNED_125,_zz__zz_decode_IS_RS2_SIGNED_127}};
  assign _zz__zz_decode_IS_RS2_SIGNED_79 = 32'h0000000c;
  assign _zz__zz_decode_IS_RS2_SIGNED_81 = 32'h00000028;
  assign _zz__zz_decode_IS_RS2_SIGNED_100 = (decode_INSTRUCTION & 32'h00000044);
  assign _zz__zz_decode_IS_RS2_SIGNED_101 = 32'h00000000;
  assign _zz__zz_decode_IS_RS2_SIGNED_102 = ((decode_INSTRUCTION & _zz__zz_decode_IS_RS2_SIGNED_103) == 32'h00002000);
  assign _zz__zz_decode_IS_RS2_SIGNED_104 = {(_zz__zz_decode_IS_RS2_SIGNED_105 == _zz__zz_decode_IS_RS2_SIGNED_106),(_zz__zz_decode_IS_RS2_SIGNED_107 == _zz__zz_decode_IS_RS2_SIGNED_108)};
  assign _zz__zz_decode_IS_RS2_SIGNED_111 = (decode_INSTRUCTION & 32'h00000058);
  assign _zz__zz_decode_IS_RS2_SIGNED_112 = 32'h00000000;
  assign _zz__zz_decode_IS_RS2_SIGNED_114 = ((decode_INSTRUCTION & _zz__zz_decode_IS_RS2_SIGNED_115) == 32'h00000040);
  assign _zz__zz_decode_IS_RS2_SIGNED_116 = {(_zz__zz_decode_IS_RS2_SIGNED_117 == _zz__zz_decode_IS_RS2_SIGNED_118),(_zz__zz_decode_IS_RS2_SIGNED_119 == _zz__zz_decode_IS_RS2_SIGNED_120)};
  assign _zz__zz_decode_IS_RS2_SIGNED_122 = {(_zz__zz_decode_IS_RS2_SIGNED_123 == _zz__zz_decode_IS_RS2_SIGNED_124),_zz_decode_IS_RS2_SIGNED_1};
  assign _zz__zz_decode_IS_RS2_SIGNED_125 = (|{_zz__zz_decode_IS_RS2_SIGNED_126,_zz_decode_IS_RS2_SIGNED_1});
  assign _zz__zz_decode_IS_RS2_SIGNED_127 = (|(_zz__zz_decode_IS_RS2_SIGNED_128 == _zz__zz_decode_IS_RS2_SIGNED_129));
  assign _zz__zz_decode_IS_RS2_SIGNED_103 = 32'h00006004;
  assign _zz__zz_decode_IS_RS2_SIGNED_105 = (decode_INSTRUCTION & 32'h00005004);
  assign _zz__zz_decode_IS_RS2_SIGNED_106 = 32'h00001000;
  assign _zz__zz_decode_IS_RS2_SIGNED_107 = (decode_INSTRUCTION & 32'h00004050);
  assign _zz__zz_decode_IS_RS2_SIGNED_108 = 32'h00004000;
  assign _zz__zz_decode_IS_RS2_SIGNED_115 = 32'h00000044;
  assign _zz__zz_decode_IS_RS2_SIGNED_117 = (decode_INSTRUCTION & 32'h00002014);
  assign _zz__zz_decode_IS_RS2_SIGNED_118 = 32'h00002010;
  assign _zz__zz_decode_IS_RS2_SIGNED_119 = (decode_INSTRUCTION & 32'h40000034);
  assign _zz__zz_decode_IS_RS2_SIGNED_120 = 32'h40000030;
  assign _zz__zz_decode_IS_RS2_SIGNED_123 = (decode_INSTRUCTION & 32'h00000014);
  assign _zz__zz_decode_IS_RS2_SIGNED_124 = 32'h00000004;
  assign _zz__zz_decode_IS_RS2_SIGNED_126 = ((decode_INSTRUCTION & 32'h00000044) == 32'h00000004);
  assign _zz__zz_decode_IS_RS2_SIGNED_128 = (decode_INSTRUCTION & 32'h00005048);
  assign _zz__zz_decode_IS_RS2_SIGNED_129 = 32'h00001008;
  assign _zz_execute_BranchPlugin_branch_src2_6 = execute_INSTRUCTION[31];
  assign _zz_execute_BranchPlugin_branch_src2_7 = execute_INSTRUCTION[31];
  assign _zz_execute_BranchPlugin_branch_src2_8 = execute_INSTRUCTION[7];
  always @(posedge clk) begin
    if(_zz_decode_RegFilePlugin_rs1Data) begin
      _zz_RegFilePlugin_regFile_port0 <= RegFilePlugin_regFile[decode_RegFilePlugin_regFileReadAddress1];
    end
  end

  always @(posedge clk) begin
    if(_zz_decode_RegFilePlugin_rs2Data) begin
      _zz_RegFilePlugin_regFile_port1 <= RegFilePlugin_regFile[decode_RegFilePlugin_regFileReadAddress2];
    end
  end

  always @(posedge clk) begin
    if(_zz_1) begin
      RegFilePlugin_regFile[lastStageRegFileWrite_payload_address] <= lastStageRegFileWrite_payload_data;
    end
  end

  InstructionCache IBusCachedPlugin_cache (
    .io_flush                              (IBusCachedPlugin_cache_io_flush                           ), //i
    .io_cpu_prefetch_isValid               (IBusCachedPlugin_cache_io_cpu_prefetch_isValid            ), //i
    .io_cpu_prefetch_haltIt                (IBusCachedPlugin_cache_io_cpu_prefetch_haltIt             ), //o
    .io_cpu_prefetch_pc                    (IBusCachedPlugin_iBusRsp_stages_0_input_payload[31:0]     ), //i
    .io_cpu_fetch_isValid                  (IBusCachedPlugin_cache_io_cpu_fetch_isValid               ), //i
    .io_cpu_fetch_isStuck                  (IBusCachedPlugin_cache_io_cpu_fetch_isStuck               ), //i
    .io_cpu_fetch_isRemoved                (IBusCachedPlugin_cache_io_cpu_fetch_isRemoved             ), //i
    .io_cpu_fetch_pc                       (IBusCachedPlugin_iBusRsp_stages_1_input_payload[31:0]     ), //i
    .io_cpu_fetch_data                     (IBusCachedPlugin_cache_io_cpu_fetch_data[31:0]            ), //o
    .io_cpu_fetch_mmuRsp_physicalAddress   (IBusCachedPlugin_mmuBus_rsp_physicalAddress[31:0]         ), //i
    .io_cpu_fetch_mmuRsp_isIoAccess        (IBusCachedPlugin_mmuBus_rsp_isIoAccess                    ), //i
    .io_cpu_fetch_mmuRsp_isPaging          (IBusCachedPlugin_mmuBus_rsp_isPaging                      ), //i
    .io_cpu_fetch_mmuRsp_allowRead         (IBusCachedPlugin_mmuBus_rsp_allowRead                     ), //i
    .io_cpu_fetch_mmuRsp_allowWrite        (IBusCachedPlugin_mmuBus_rsp_allowWrite                    ), //i
    .io_cpu_fetch_mmuRsp_allowExecute      (IBusCachedPlugin_mmuBus_rsp_allowExecute                  ), //i
    .io_cpu_fetch_mmuRsp_exception         (IBusCachedPlugin_mmuBus_rsp_exception                     ), //i
    .io_cpu_fetch_mmuRsp_refilling         (IBusCachedPlugin_mmuBus_rsp_refilling                     ), //i
    .io_cpu_fetch_mmuRsp_bypassTranslation (IBusCachedPlugin_mmuBus_rsp_bypassTranslation             ), //i
    .io_cpu_fetch_physicalAddress          (IBusCachedPlugin_cache_io_cpu_fetch_physicalAddress[31:0] ), //o
    .io_cpu_decode_isValid                 (IBusCachedPlugin_cache_io_cpu_decode_isValid              ), //i
    .io_cpu_decode_isStuck                 (IBusCachedPlugin_cache_io_cpu_decode_isStuck              ), //i
    .io_cpu_decode_pc                      (IBusCachedPlugin_iBusRsp_stages_2_input_payload[31:0]     ), //i
    .io_cpu_decode_physicalAddress         (IBusCachedPlugin_cache_io_cpu_decode_physicalAddress[31:0]), //o
    .io_cpu_decode_data                    (IBusCachedPlugin_cache_io_cpu_decode_data[31:0]           ), //o
    .io_cpu_decode_cacheMiss               (IBusCachedPlugin_cache_io_cpu_decode_cacheMiss            ), //o
    .io_cpu_decode_error                   (IBusCachedPlugin_cache_io_cpu_decode_error                ), //o
    .io_cpu_decode_mmuRefilling            (IBusCachedPlugin_cache_io_cpu_decode_mmuRefilling         ), //o
    .io_cpu_decode_mmuException            (IBusCachedPlugin_cache_io_cpu_decode_mmuException         ), //o
    .io_cpu_decode_isUser                  (IBusCachedPlugin_cache_io_cpu_decode_isUser               ), //i
    .io_cpu_fill_valid                     (IBusCachedPlugin_cache_io_cpu_fill_valid                  ), //i
    .io_cpu_fill_payload                   (IBusCachedPlugin_cache_io_cpu_decode_physicalAddress[31:0]), //i
    .io_mem_cmd_valid                      (IBusCachedPlugin_cache_io_mem_cmd_valid                   ), //o
    .io_mem_cmd_ready                      (iBus_cmd_ready                                            ), //i
    .io_mem_cmd_payload_address            (IBusCachedPlugin_cache_io_mem_cmd_payload_address[31:0]   ), //o
    .io_mem_cmd_payload_size               (IBusCachedPlugin_cache_io_mem_cmd_payload_size[2:0]       ), //o
    .io_mem_rsp_valid                      (iBus_rsp_valid                                            ), //i
    .io_mem_rsp_payload_data               (iBus_rsp_payload_data[31:0]                               ), //i
    .io_mem_rsp_payload_error              (iBus_rsp_payload_error                                    ), //i
    .clk                                   (clk                                                       ), //i
    .reset                                 (reset                                                     )  //i
  );
  DataCache dataCache_1 (
    .io_cpu_execute_isValid                 (dataCache_1_io_cpu_execute_isValid               ), //i
    .io_cpu_execute_address                 (dataCache_1_io_cpu_execute_address[31:0]         ), //i
    .io_cpu_execute_haltIt                  (dataCache_1_io_cpu_execute_haltIt                ), //o
    .io_cpu_execute_args_wr                 (execute_MEMORY_WR                                ), //i
    .io_cpu_execute_args_size               (execute_DBusCachedPlugin_size[1:0]               ), //i
    .io_cpu_execute_args_totalyConsistent   (execute_MEMORY_FORCE_CONSTISTENCY                ), //i
    .io_cpu_execute_refilling               (dataCache_1_io_cpu_execute_refilling             ), //o
    .io_cpu_memory_isValid                  (dataCache_1_io_cpu_memory_isValid                ), //i
    .io_cpu_memory_isStuck                  (memory_arbitration_isStuck                       ), //i
    .io_cpu_memory_isWrite                  (dataCache_1_io_cpu_memory_isWrite                ), //o
    .io_cpu_memory_address                  (dataCache_1_io_cpu_memory_address[31:0]          ), //i
    .io_cpu_memory_mmuRsp_physicalAddress   (DBusCachedPlugin_mmuBus_rsp_physicalAddress[31:0]), //i
    .io_cpu_memory_mmuRsp_isIoAccess        (dataCache_1_io_cpu_memory_mmuRsp_isIoAccess      ), //i
    .io_cpu_memory_mmuRsp_isPaging          (DBusCachedPlugin_mmuBus_rsp_isPaging             ), //i
    .io_cpu_memory_mmuRsp_allowRead         (DBusCachedPlugin_mmuBus_rsp_allowRead            ), //i
    .io_cpu_memory_mmuRsp_allowWrite        (DBusCachedPlugin_mmuBus_rsp_allowWrite           ), //i
    .io_cpu_memory_mmuRsp_allowExecute      (DBusCachedPlugin_mmuBus_rsp_allowExecute         ), //i
    .io_cpu_memory_mmuRsp_exception         (DBusCachedPlugin_mmuBus_rsp_exception            ), //i
    .io_cpu_memory_mmuRsp_refilling         (DBusCachedPlugin_mmuBus_rsp_refilling            ), //i
    .io_cpu_memory_mmuRsp_bypassTranslation (DBusCachedPlugin_mmuBus_rsp_bypassTranslation    ), //i
    .io_cpu_writeBack_isValid               (dataCache_1_io_cpu_writeBack_isValid             ), //i
    .io_cpu_writeBack_isStuck               (writeBack_arbitration_isStuck                    ), //i
    .io_cpu_writeBack_isFiring              (writeBack_arbitration_isFiring                   ), //i
    .io_cpu_writeBack_isUser                (dataCache_1_io_cpu_writeBack_isUser              ), //i
    .io_cpu_writeBack_haltIt                (dataCache_1_io_cpu_writeBack_haltIt              ), //o
    .io_cpu_writeBack_isWrite               (dataCache_1_io_cpu_writeBack_isWrite             ), //o
    .io_cpu_writeBack_storeData             (dataCache_1_io_cpu_writeBack_storeData[31:0]     ), //i
    .io_cpu_writeBack_data                  (dataCache_1_io_cpu_writeBack_data[31:0]          ), //o
    .io_cpu_writeBack_address               (dataCache_1_io_cpu_writeBack_address[31:0]       ), //i
    .io_cpu_writeBack_mmuException          (dataCache_1_io_cpu_writeBack_mmuException        ), //o
    .io_cpu_writeBack_unalignedAccess       (dataCache_1_io_cpu_writeBack_unalignedAccess     ), //o
    .io_cpu_writeBack_accessError           (dataCache_1_io_cpu_writeBack_accessError         ), //o
    .io_cpu_writeBack_keepMemRspData        (dataCache_1_io_cpu_writeBack_keepMemRspData      ), //o
    .io_cpu_writeBack_fence_SW              (dataCache_1_io_cpu_writeBack_fence_SW            ), //i
    .io_cpu_writeBack_fence_SR              (dataCache_1_io_cpu_writeBack_fence_SR            ), //i
    .io_cpu_writeBack_fence_SO              (dataCache_1_io_cpu_writeBack_fence_SO            ), //i
    .io_cpu_writeBack_fence_SI              (dataCache_1_io_cpu_writeBack_fence_SI            ), //i
    .io_cpu_writeBack_fence_PW              (dataCache_1_io_cpu_writeBack_fence_PW            ), //i
    .io_cpu_writeBack_fence_PR              (dataCache_1_io_cpu_writeBack_fence_PR            ), //i
    .io_cpu_writeBack_fence_PO              (dataCache_1_io_cpu_writeBack_fence_PO            ), //i
    .io_cpu_writeBack_fence_PI              (dataCache_1_io_cpu_writeBack_fence_PI            ), //i
    .io_cpu_writeBack_fence_FM              (dataCache_1_io_cpu_writeBack_fence_FM[3:0]       ), //i
    .io_cpu_writeBack_exclusiveOk           (dataCache_1_io_cpu_writeBack_exclusiveOk         ), //o
    .io_cpu_redo                            (dataCache_1_io_cpu_redo                          ), //o
    .io_cpu_flush_valid                     (dataCache_1_io_cpu_flush_valid                   ), //i
    .io_cpu_flush_ready                     (dataCache_1_io_cpu_flush_ready                   ), //o
    .io_cpu_flush_payload_singleLine        (dataCache_1_io_cpu_flush_payload_singleLine      ), //i
    .io_cpu_flush_payload_lineId            (dataCache_1_io_cpu_flush_payload_lineId[6:0]     ), //i
    .io_cpu_writesPending                   (dataCache_1_io_cpu_writesPending                 ), //o
    .io_mem_cmd_valid                       (dataCache_1_io_mem_cmd_valid                     ), //o
    .io_mem_cmd_ready                       (toplevel_dataCache_1_io_mem_cmd_rValidN          ), //i
    .io_mem_cmd_payload_wr                  (dataCache_1_io_mem_cmd_payload_wr                ), //o
    .io_mem_cmd_payload_uncached            (dataCache_1_io_mem_cmd_payload_uncached          ), //o
    .io_mem_cmd_payload_address             (dataCache_1_io_mem_cmd_payload_address[31:0]     ), //o
    .io_mem_cmd_payload_data                (dataCache_1_io_mem_cmd_payload_data[31:0]        ), //o
    .io_mem_cmd_payload_mask                (dataCache_1_io_mem_cmd_payload_mask[3:0]         ), //o
    .io_mem_cmd_payload_size                (dataCache_1_io_mem_cmd_payload_size[2:0]         ), //o
    .io_mem_cmd_payload_last                (dataCache_1_io_mem_cmd_payload_last              ), //o
    .io_mem_rsp_valid                       (dBus_rsp_valid                                   ), //i
    .io_mem_rsp_payload_last                (dBus_rsp_payload_last                            ), //i
    .io_mem_rsp_payload_data                (dBus_rsp_payload_data[31:0]                      ), //i
    .io_mem_rsp_payload_error               (dBus_rsp_payload_error                           ), //i
    .clk                                    (clk                                              ), //i
    .reset                                  (reset                                            )  //i
  );
  always @(*) begin
    case(_zz_IBusCachedPlugin_jump_pcLoad_payload_6)
      2'b00 : _zz_IBusCachedPlugin_jump_pcLoad_payload_5 = DBusCachedPlugin_redoBranch_payload;
      2'b01 : _zz_IBusCachedPlugin_jump_pcLoad_payload_5 = CsrPlugin_jumpInterface_payload;
      2'b10 : _zz_IBusCachedPlugin_jump_pcLoad_payload_5 = BranchPlugin_jumpInterface_payload;
      default : _zz_IBusCachedPlugin_jump_pcLoad_payload_5 = IBusCachedPlugin_predictionJumpInterface_payload;
    endcase
  end

  always @(*) begin
    case(_zz_writeBack_DBusCachedPlugin_rspShifted_1)
      2'b00 : _zz_writeBack_DBusCachedPlugin_rspShifted = writeBack_DBusCachedPlugin_rspSplits_0;
      2'b01 : _zz_writeBack_DBusCachedPlugin_rspShifted = writeBack_DBusCachedPlugin_rspSplits_1;
      2'b10 : _zz_writeBack_DBusCachedPlugin_rspShifted = writeBack_DBusCachedPlugin_rspSplits_2;
      default : _zz_writeBack_DBusCachedPlugin_rspShifted = writeBack_DBusCachedPlugin_rspSplits_3;
    endcase
  end

  always @(*) begin
    case(_zz_writeBack_DBusCachedPlugin_rspShifted_3)
      1'b0 : _zz_writeBack_DBusCachedPlugin_rspShifted_2 = writeBack_DBusCachedPlugin_rspSplits_1;
      default : _zz_writeBack_DBusCachedPlugin_rspShifted_2 = writeBack_DBusCachedPlugin_rspSplits_3;
    endcase
  end
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
