xuanxly/fpga-piano-Chuyun/fpga/d13/firmware/media_hw.h

#ifndef MEDIA_HW_H
#define MEDIA_HW_H
#include <stdint.h>
#include <stddef.h>
// 与media_soc.v保持一致：所有外设位于不缓存的高地址，文件/音频不依赖CPU缓存刷新。
#define MEDIA_BASE 0xf0000000u
#define MEDIA_FIFO_WORDS 6144u
enum {HW_MS=0,HW_PAGE=4,HW_EVENTS=8,HW_EVENT_POP=12,HW_REC_CTL=16,HW_REC_COUNT=20,HW_REC_POP=24,HW_REC_SAMPLES=28,
      HW_PLAY_CTL=32,HW_PLAY_FREE=36,HW_PLAY_PUSH=40,HW_PLAY_FRAMES=44,HW_PLAY_STATUS=48,
      HW_REC_LAST_VALID=60,HW_SPI_CFG=64,HW_SPI_TX=68,HW_SPI_RX=72,HW_NAV=80,HW_UI_COMMIT=84,HW_BOOT_STATUS=88,HW_GAME_CTL=256,HW_GAME_TIME=260,HW_GAME_MASK=264,HW_GAME_DURATION=268,HW_GAME_COMMIT=272,HW_USB_CTL=512,HW_USB_STATUS=512,HW_USB_RX_COUNT=516,HW_USB_RX=520,HW_USB_TX_FREE=524,HW_USB_TX=528,HW_UI_BASE=4096};
enum {CMD_PAGE=1,CMD_RECORD=2,CMD_REC_PAUSE=3,CMD_OPEN=4,CMD_UP=5,CMD_LIST_PREV=6,CMD_LIST_NEXT=7,CMD_REFRESH=8,
      CMD_PLAY_PAUSE=9,CMD_PLAY_STOP=10,CMD_SEEK=11,CMD_PREVIOUS=12,CMD_NEXT=13,CMD_GAME_OPEN=15,CMD_GAME_MODE=16,CMD_GAME_PAUSE=17,CMD_GAME_STOP=18,CMD_USB_DISK=19};
enum {PAGE_HOME=0,PAGE_SPECTRUM=1,PAGE_KEYBOARD=2,PAGE_RECORDER=3,PAGE_FILES=4,PAGE_PLAYER=5,PAGE_TIMBRE=6,PAGE_GAME=7,PAGE_VERIFY=8,PAGE_EFFECTS=9};
enum {REC_IDLE=0,REC_RUNNING=1,REC_PAUSED=2,REC_SAVING=3,REC_PREPARING=4,REC_ERROR=5};
enum {PLAY_IDLE=0,PLAY_RUNNING=1,PLAY_PAUSED=2,PLAY_LOADING=3,PLAY_ENDED=4,PLAY_ERROR=5};
enum {MSG_READY=0,MSG_NO_CARD=1,MSG_MOUNT_ERROR=2,MSG_SAVED=3,MSG_END_REC_FIRST=4,MSG_UNSUPPORTED=5,
      MSG_IO_ERROR=6,MSG_DECODE_ERROR=7,MSG_REC_OVERFLOW=8,MSG_PLAY_UNDERFLOW=9,MSG_MAX_TIME=10,MSG_LOADING=11,
      MSG_EMPTY=12,MSG_REMOVED=13,MSG_NO_MEMORY=14,MSG_BAD_CHART=15,MSG_USB_WAIT=16,MSG_USB_EXPORTED=17,MSG_USB_UNPLUG=18};
uint32_t hw_read(unsigned offset);
void hw_write(unsigned offset,uint32_t value);
void media_init(void);
void media_step(void);
void media_heap_reset(void);
size_t media_heap_used(void);
#endif
