xuanxly/fpga-piano-Chuyun/fpga/d13/src/note_frequency28.v

`timescale 1ns/1ps
// 四个八度白键C3..B6，全局移调-5..+5；相位增量取round(f*2^32/48000)。
module note_frequency28(input wire [4:0] key_index,input wire signed [3:0] transpose,output reg [31:0] phase_step);
reg signed [7:0] base_note,actual_note;
always @* begin
case(key_index)
5'd0:base_note=8'sd48;
5'd1:base_note=8'sd50;
5'd2:base_note=8'sd52;
5'd3:base_note=8'sd53;
5'd4:base_note=8'sd55;
5'd5:base_note=8'sd57;
5'd6:base_note=8'sd59;
5'd7:base_note=8'sd60;
5'd8:base_note=8'sd62;
5'd9:base_note=8'sd64;
5'd10:base_note=8'sd65;
5'd11:base_note=8'sd67;
5'd12:base_note=8'sd69;
5'd13:base_note=8'sd71;
5'd14:base_note=8'sd72;
5'd15:base_note=8'sd74;
5'd16:base_note=8'sd76;
5'd17:base_note=8'sd77;
5'd18:base_note=8'sd79;
5'd19:base_note=8'sd81;
5'd20:base_note=8'sd83;
5'd21:base_note=8'sd84;
5'd22:base_note=8'sd86;
5'd23:base_note=8'sd88;
5'd24:base_note=8'sd89;
5'd25:base_note=8'sd91;
5'd26:base_note=8'sd93;
5'd27:base_note=8'sd95;
default:base_note=0;endcase
actual_note=base_note+{{4{transpose[3]}},transpose};
case(actual_note)
8'sd43:phase_step=32'd8768789;
8'sd44:phase_step=32'd9290209;
8'sd45:phase_step=32'd9842633;
8'sd46:phase_step=32'd10427907;
8'sd47:phase_step=32'd11047982;
8'sd48:phase_step=32'd11704930;
8'sd49:phase_step=32'd12400941;
8'sd50:phase_step=32'd13138339;
8'sd51:phase_step=32'd13919586;
8'sd52:phase_step=32'd14747287;
8'sd53:phase_step=32'd15624207;
8'sd54:phase_step=32'd16553270;
8'sd55:phase_step=32'd17537579;
8'sd56:phase_step=32'd18580418;
8'sd57:phase_step=32'd19685267;
8'sd58:phase_step=32'd20855814;
8'sd59:phase_step=32'd22095965;
8'sd60:phase_step=32'd23409859;
8'sd61:phase_step=32'd24801882;
8'sd62:phase_step=32'd26276679;
8'sd63:phase_step=32'd27839171;
8'sd64:phase_step=32'd29494575;
8'sd65:phase_step=32'd31248413;
8'sd66:phase_step=32'd33106541;
8'sd67:phase_step=32'd35075158;
8'sd68:phase_step=32'd37160835;
8'sd69:phase_step=32'd39370534;
8'sd70:phase_step=32'd41711627;
8'sd71:phase_step=32'd44191930;
8'sd72:phase_step=32'd46819719;
8'sd73:phase_step=32'd49603764;
8'sd74:phase_step=32'd52553357;
8'sd75:phase_step=32'd55678342;
8'sd76:phase_step=32'd58989149;
8'sd77:phase_step=32'd62496826;
8'sd78:phase_step=32'd66213081;
8'sd79:phase_step=32'd70150316;
8'sd80:phase_step=32'd74321671;
8'sd81:phase_step=32'd78741067;
8'sd82:phase_step=32'd83423255;
8'sd83:phase_step=32'd88383859;
8'sd84:phase_step=32'd93639437;
8'sd85:phase_step=32'd99207528;
8'sd86:phase_step=32'd105106715;
8'sd87:phase_step=32'd111356685;
8'sd88:phase_step=32'd117978298;
8'sd89:phase_step=32'd124993653;
8'sd90:phase_step=32'd132426162;
8'sd91:phase_step=32'd140300631;
8'sd92:phase_step=32'd148643341;
8'sd93:phase_step=32'd157482134;
8'sd94:phase_step=32'd166846509;
8'sd95:phase_step=32'd176767719;
8'sd96:phase_step=32'd187278874;
8'sd97:phase_step=32'd198415056;
8'sd98:phase_step=32'd210213429;
8'sd99:phase_step=32'd222713370;
8'sd100:phase_step=32'd235956596;
default:phase_step=0;endcase
if(key_index>=28) phase_step=0;end
endmodule
