xuanxly/fpga-piano-Chuyun/(commit log)

2026-11-02 Add CHUYUN FPGA piano project and documentation
    [ALL_KEYS.CSV, CHORDS.CSV, FOUR_ROWS.CSV, HOLD_TEST.CSV, NEXT_PAGE.CSV, QLX_EASY.CSV, RHYTHM.CSV, SCALE.CSV]
2026-11-03 Update D13 project and R8 technical report; remove personal attribution
    [ALL_KEYS.CSV, CHORDS.CSV, FOUR_ROWS.CSV, HOLD_TEST.CSV, NEXT_PAGE.CSV, ODEJOY.CSV, QLX_EASY.CSV, RHYTHM.CSV]
2026-11-03 Normalize editable level source line endings and refresh checksums
    [manifest.csv]
2026-11-03 Clarify measured digital gate-to-DAC latency in R9 report
    [manifest.csv]
2026-11-03 Complete template review with software flows and prototype evidence in R10 report
    [manifest.csv]
